ninomegadriver/BlueJamma/CRU/README.md

Custom Resolution Utility  
Copyright (C) 2012-2022 ToastyX  
https://monitortests.com/custom-resolution-utility  
  
Permission is hereby granted, free of charge, to any person obtaining a copy
of this software the rights to use, copy, and/or distribute copies of the
software subject to the following conditions:  
  
The above copyright notice and this permission notice shall be included in
all copies of the software.  
  
THE SOFTWARE IS PROVIDED "AS IS" WITHOUT WARRANTY OF ANY KIND, EXPRESS OR
IMPLIED. IN NO EVENT SHALL THE AUTHOR BE LIABLE FOR ANY CLAIM, DAMAGES, OR
OTHER LIABILITY IN CONNECTION WITH THE USE OF THE SOFTWARE.
