ninomegadriver/BlueJamma/images/BlueJammaInShell1.jpg

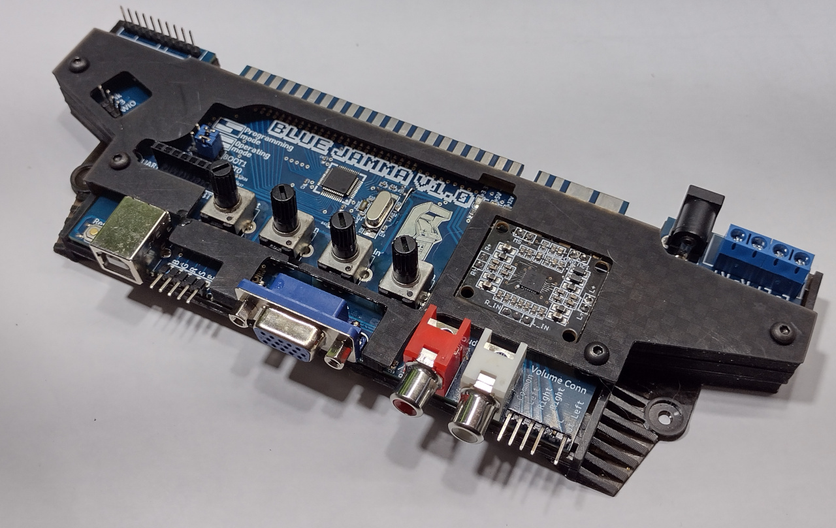
images/BlueJammaInShell1.jpg
