ninomegadriver/BlueJamma/images/BlueJammaInShell2.jpg

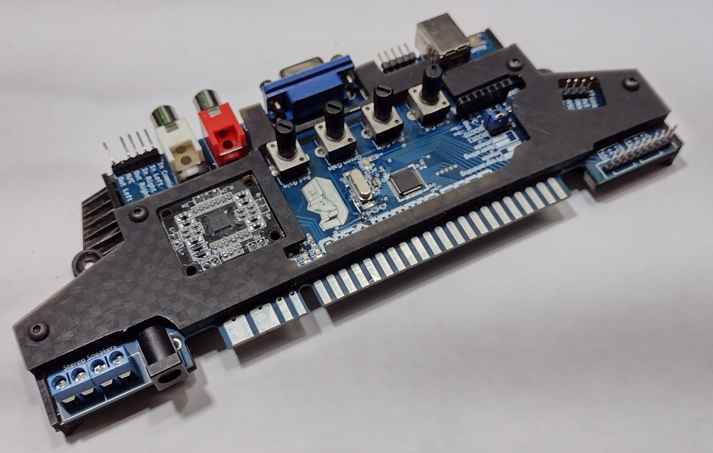
images/BlueJammaInShell2.jpg
