ninomegadriver/BlueJamma/images/BlueJammaInShell3.jpg

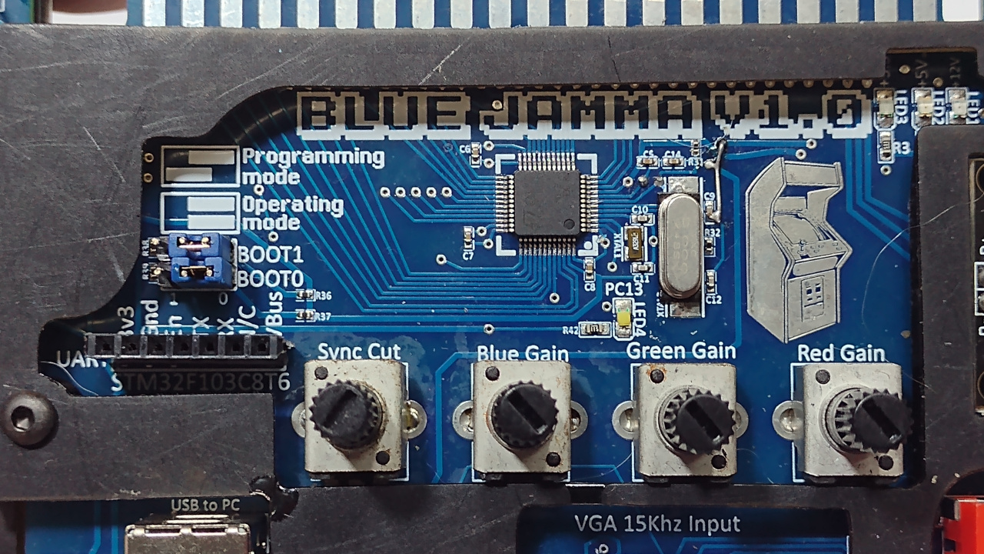
images/BlueJammaInShell3.jpg
