ninomegadriver/BlueJamma/images/pcb-cad-top.jpg

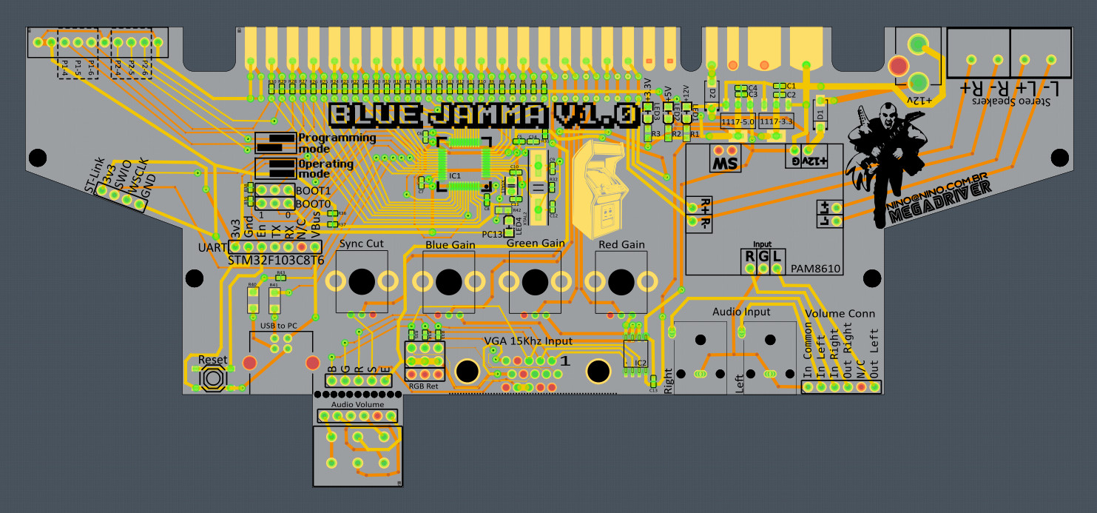
images/pcb-cad-top.jpg
