ninomegadriver/BlueJamma/images/pcb-top.jpg

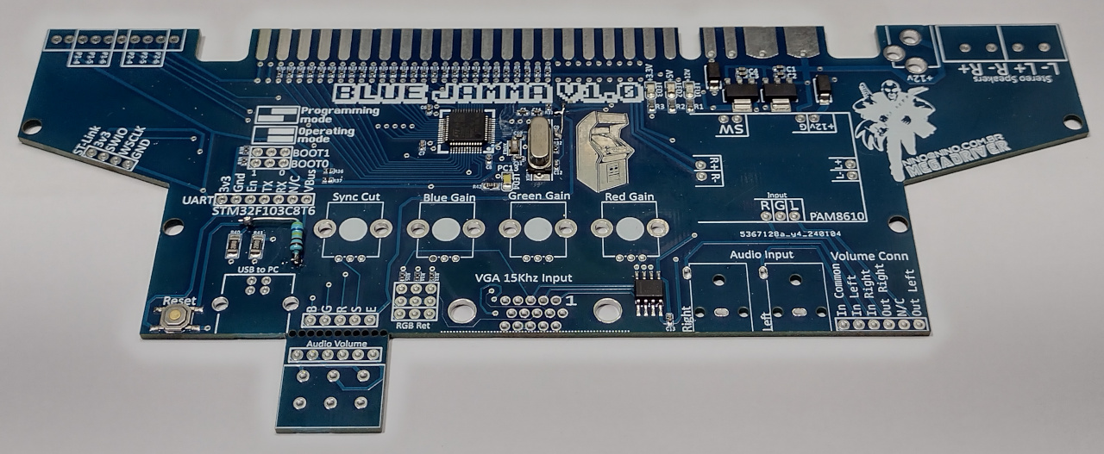
images/pcb-top.jpg
