ninomegadriver/BlueJamma/images/pcbs.jpg

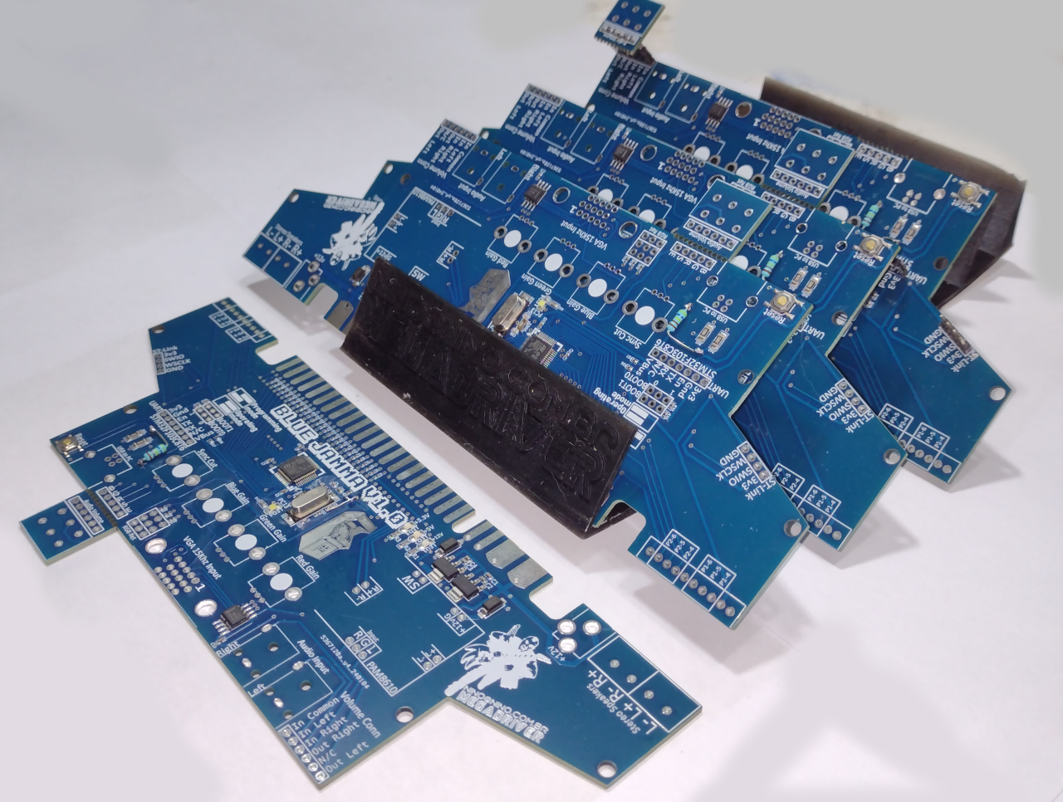
images/pcbs.jpg
