ninomegadriver/BlueJamma/images/schematic-audio.jpg

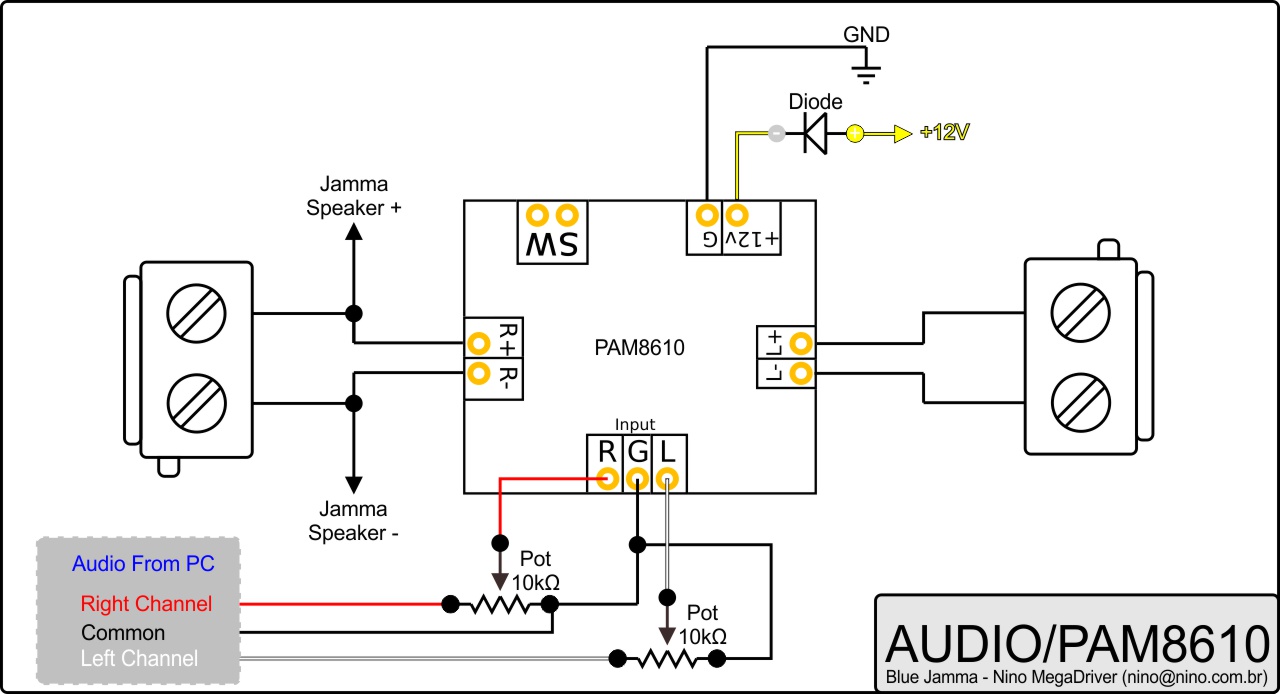
images/schematic-audio.jpg
