ninomegadriver/BlueJamma/images/schematic-flash.jpg

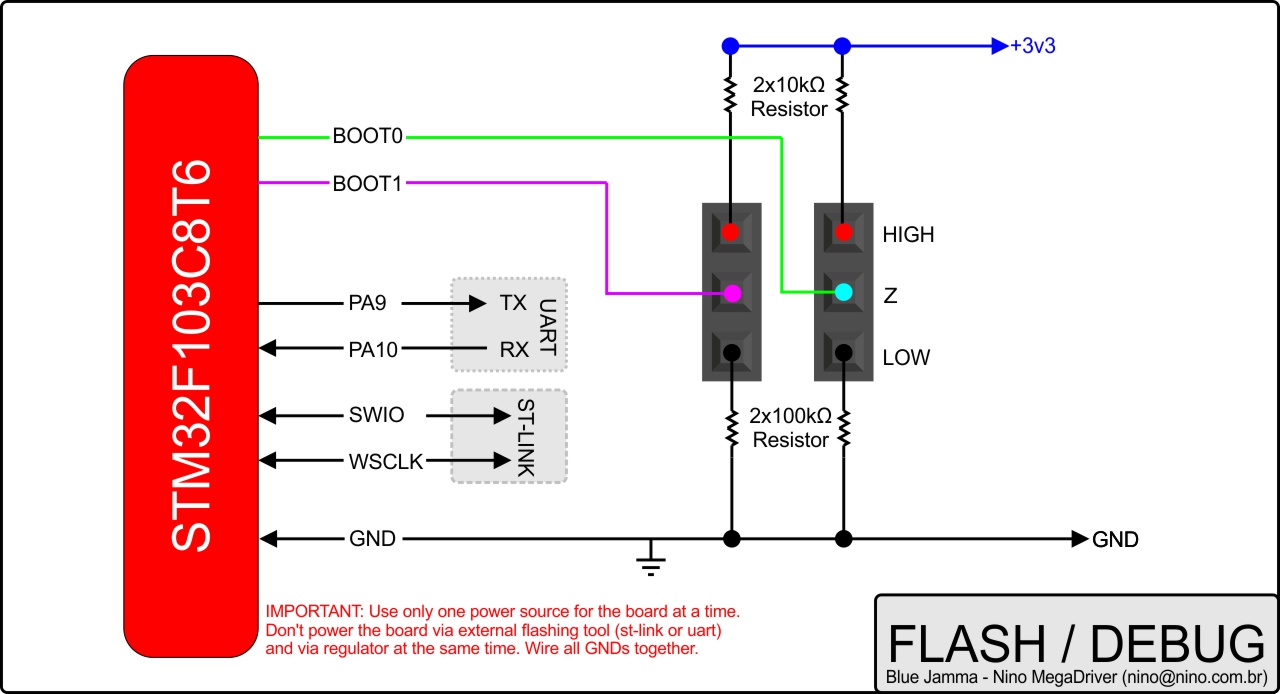
images/schematic-flash.jpg
