ninomegadriver/BlueJamma/images/schematic-oscillator.jpg

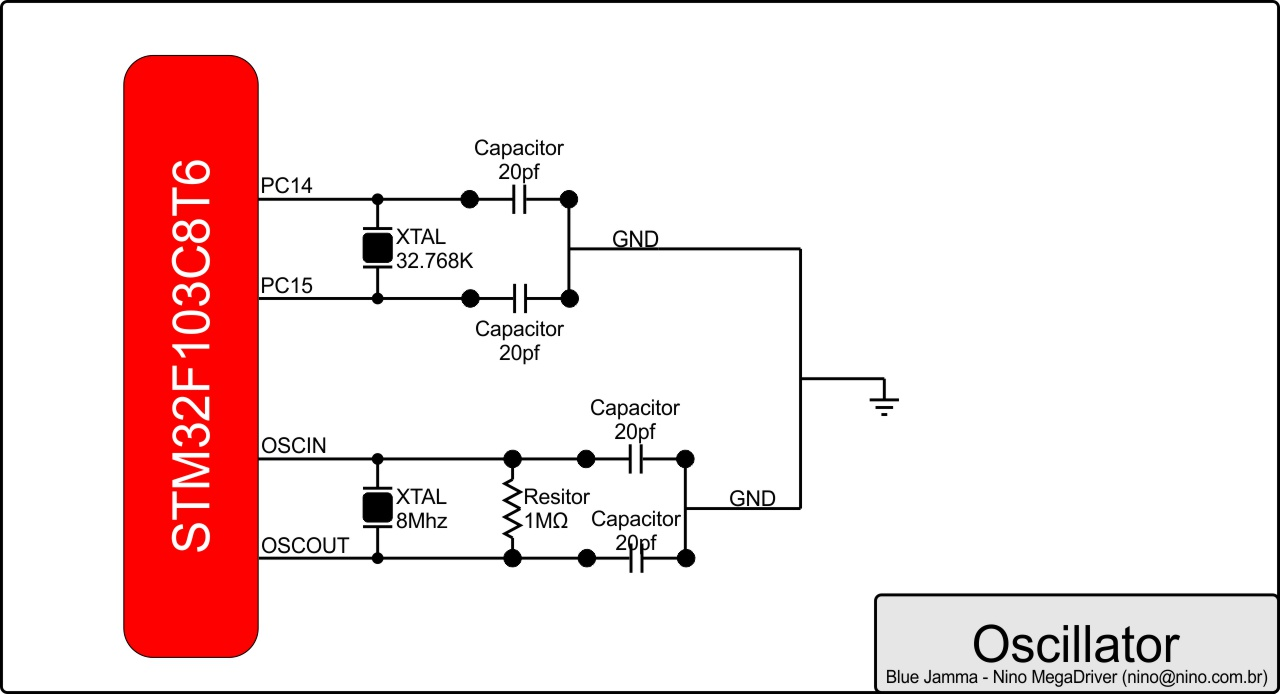
images/schematic-oscillator.jpg
