ninomegadriver/BlueJamma/images/schematic-power.jpg

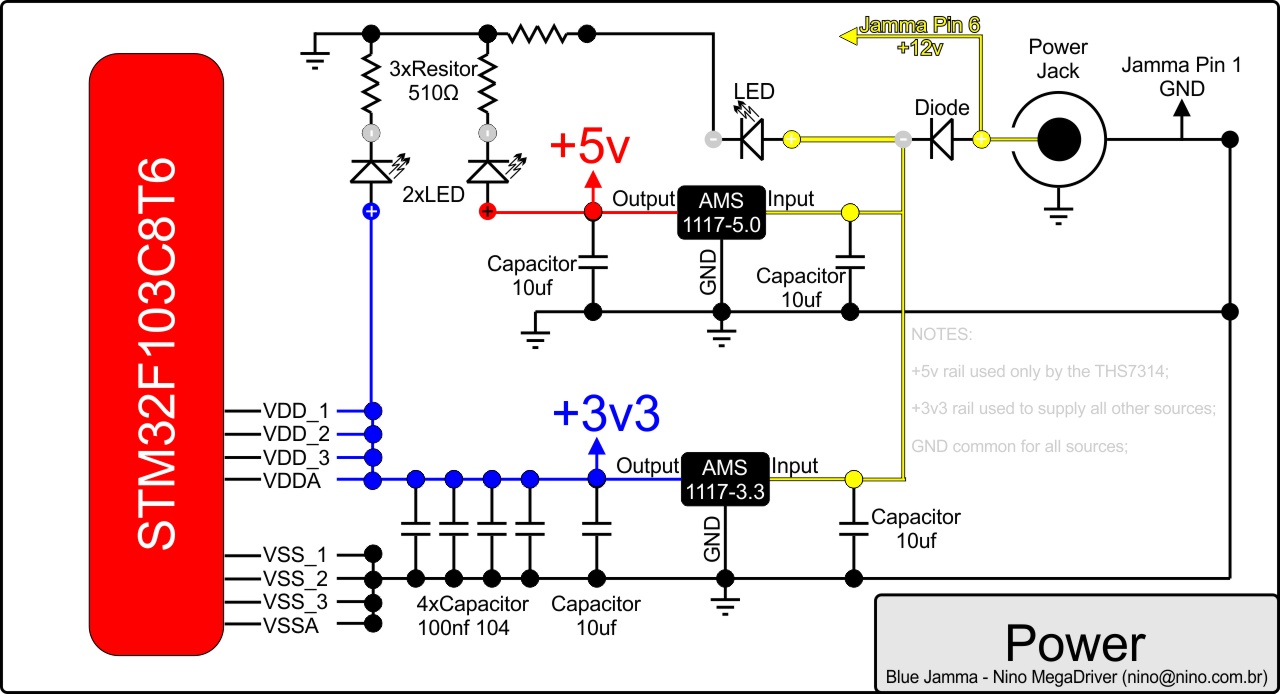
images/schematic-power.jpg
