ninomegadriver/BlueJamma/images/schematic-usb.jpg

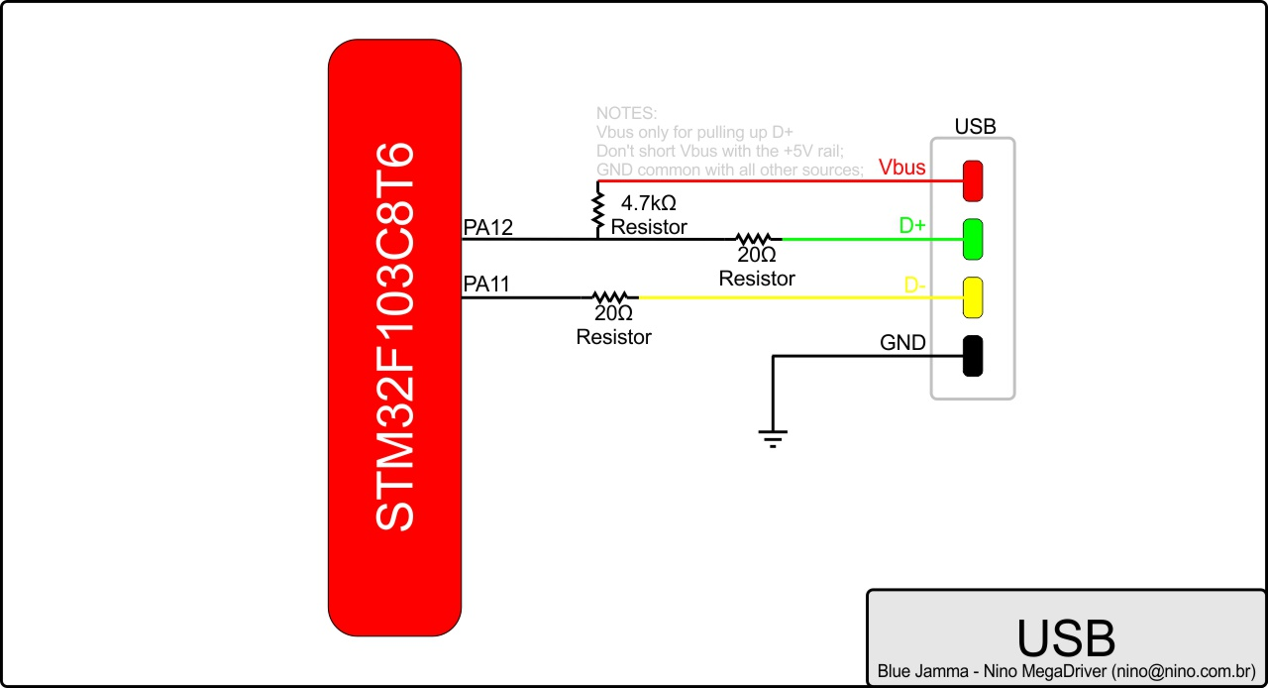
images/schematic-usb.jpg
