ninomegadriver/BlueJamma/images/schematic-video.jpg

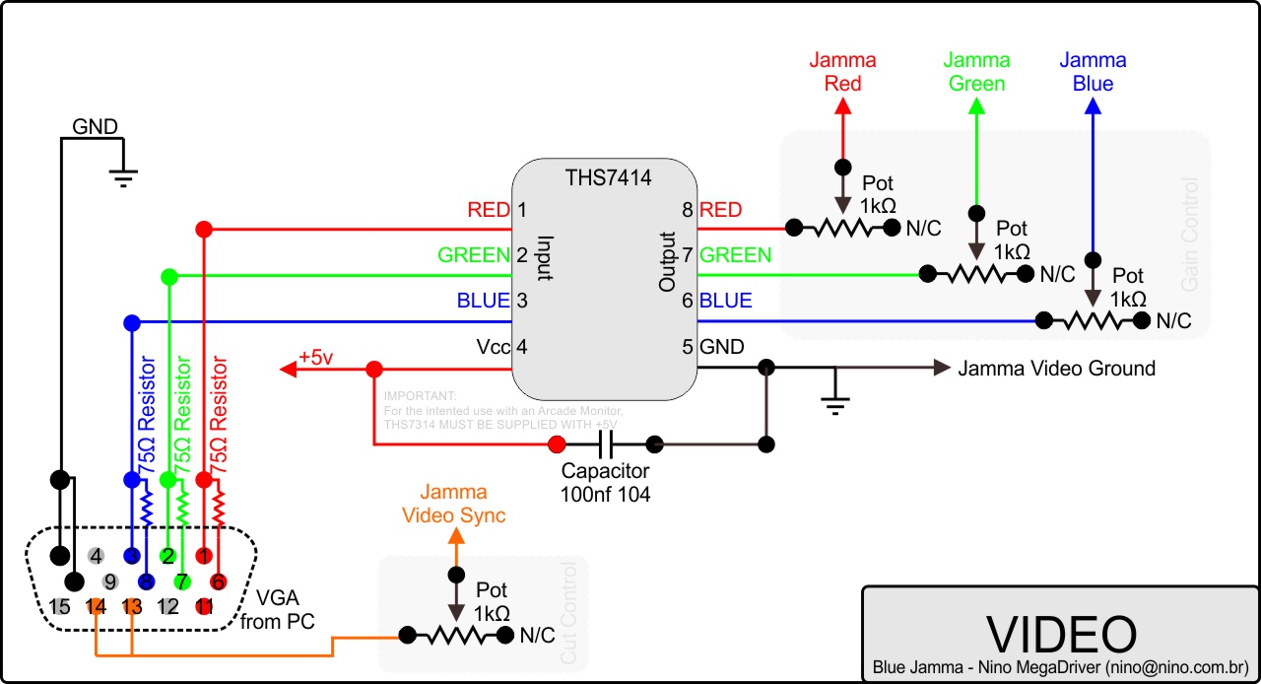
images/schematic-video.jpg
