ninomegadriver/BlueJamma/images/VGA-HowTo-Step00.jpg

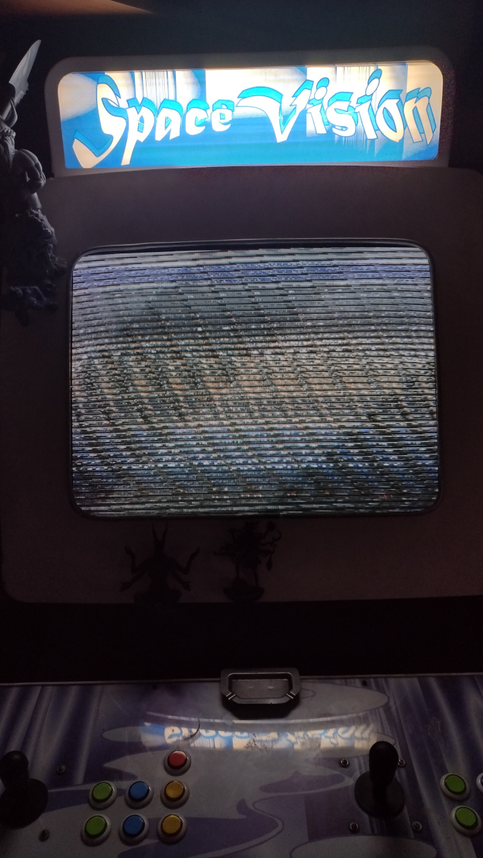
images/VGA-HowTo-Step00.jpg
