ninomegadriver/BlueJamma/images/VGA-HowTo-Step01.jpg

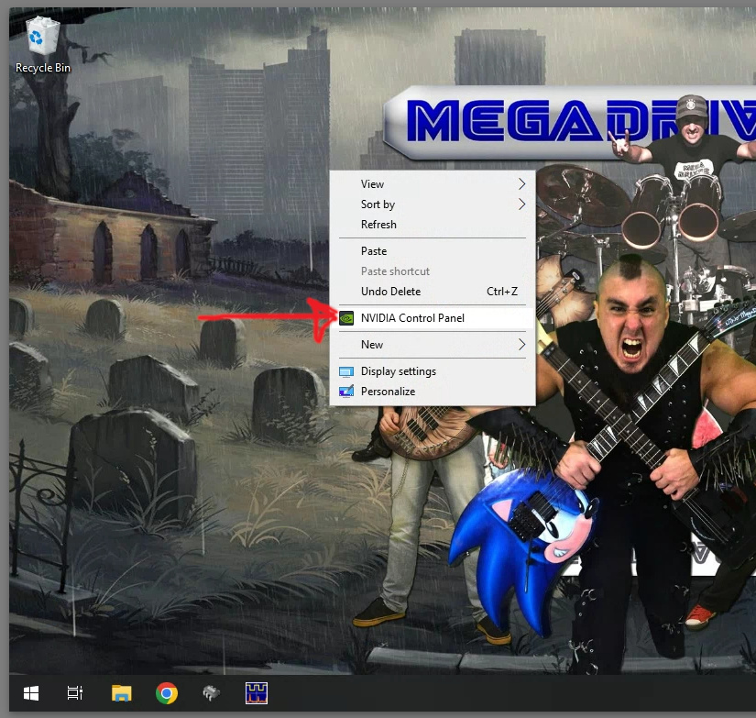
images/VGA-HowTo-Step01.jpg
