ninomegadriver/BlueJamma/images/VGA-HowTo-Step02.jpg

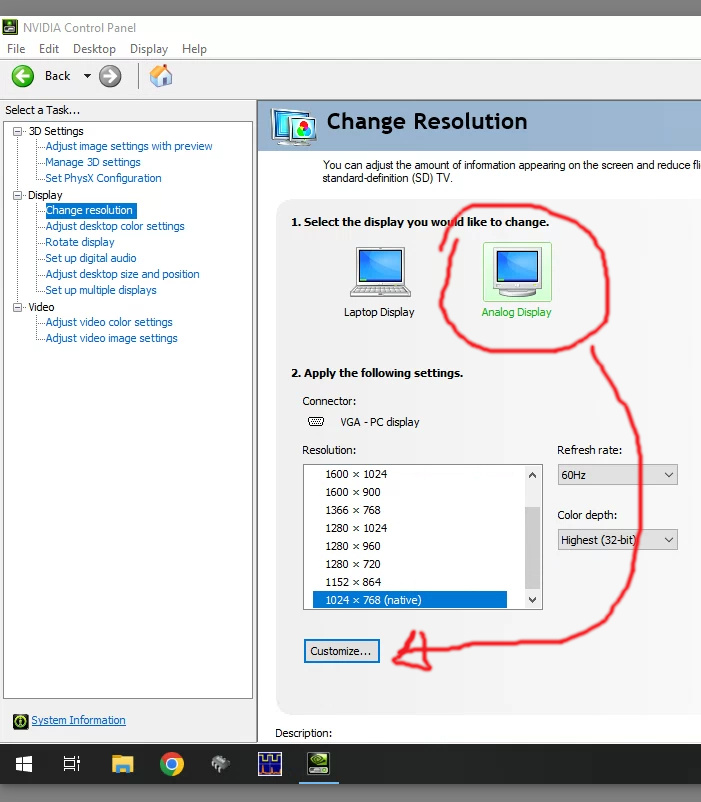
images/VGA-HowTo-Step02.jpg
