ninomegadriver/BlueJamma/images/VGA-HowTo-Step03.jpg

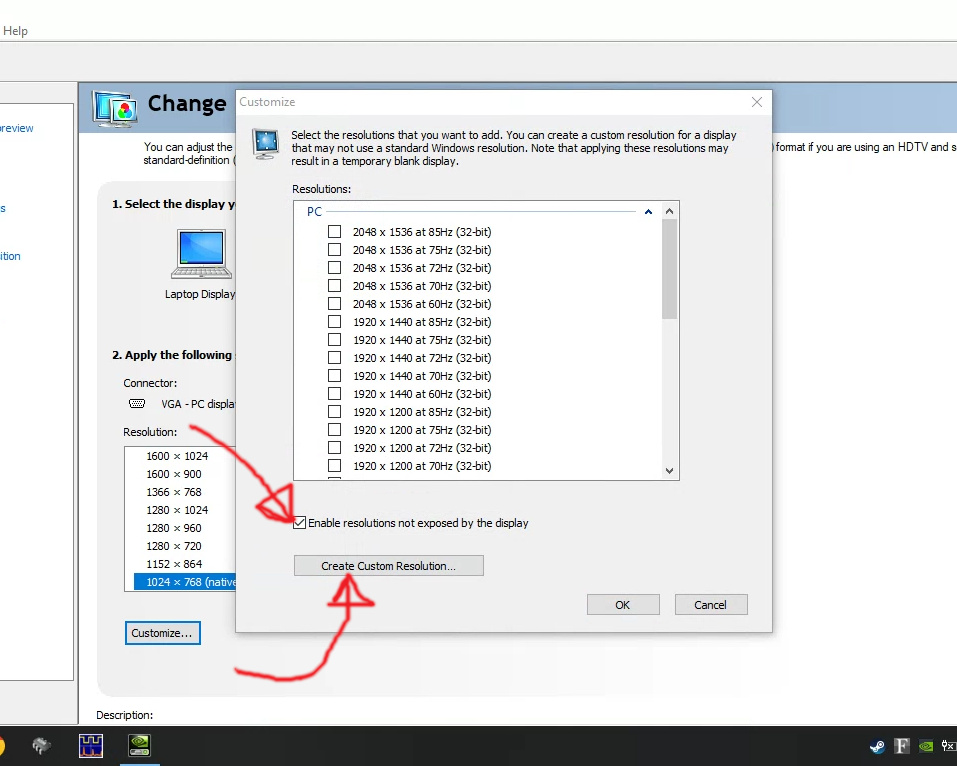
images/VGA-HowTo-Step03.jpg
