ninomegadriver/BlueJamma/images/VGA-HowTo-Step04.jpg

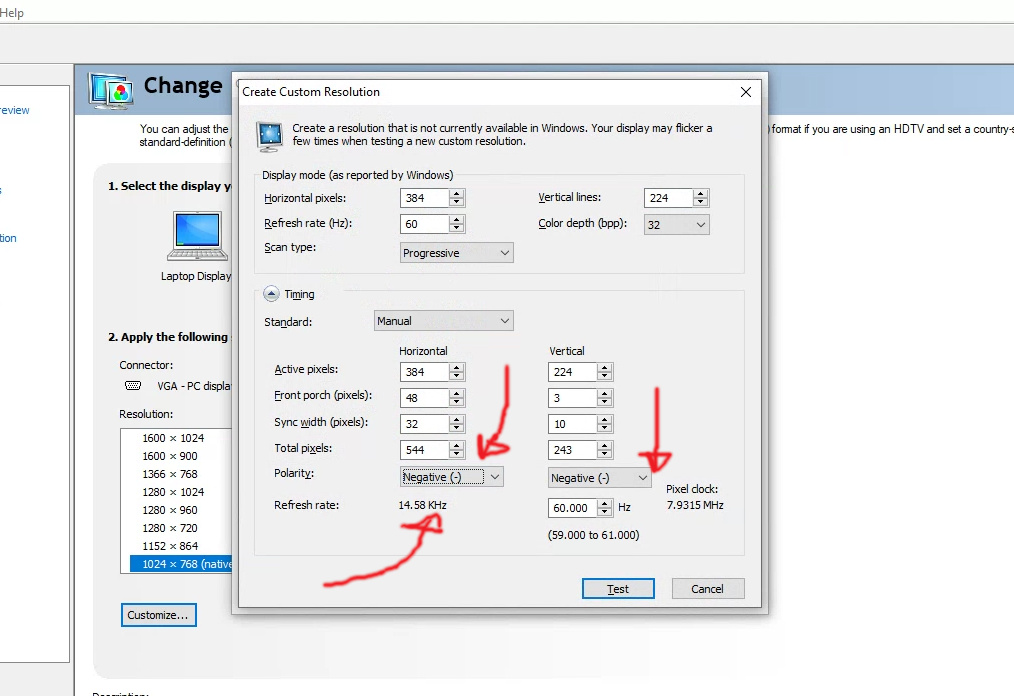
images/VGA-HowTo-Step04.jpg
