ninomegadriver/BlueJamma/images/VGA-HowTo-Step05.jpg

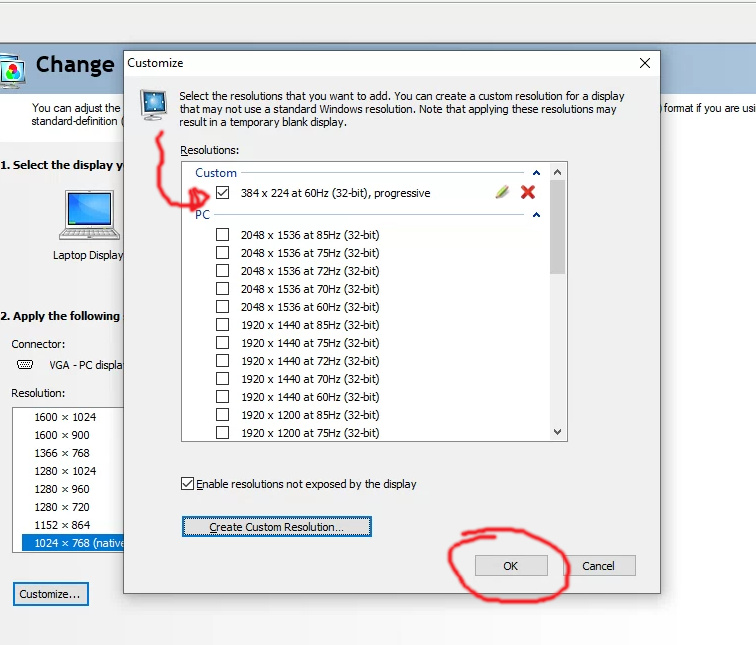
images/VGA-HowTo-Step05.jpg
