ninomegadriver/BlueJamma/images/VGA-HowTo-Step06.jpg

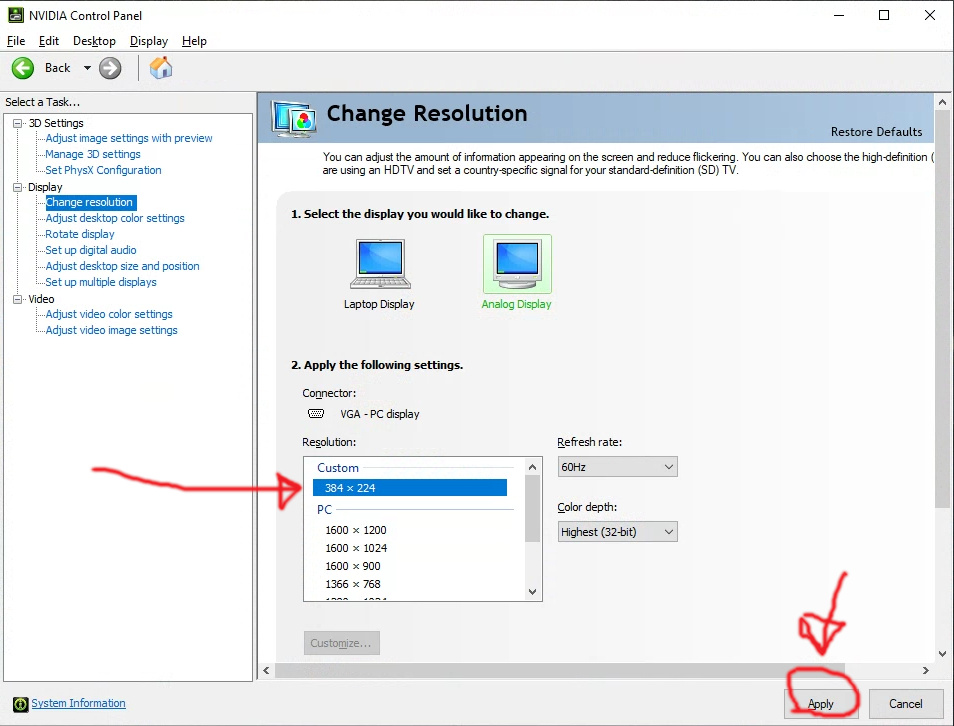
images/VGA-HowTo-Step06.jpg
