ninomegadriver/BlueJamma/images/VGA-HowTo-Step07.jpg

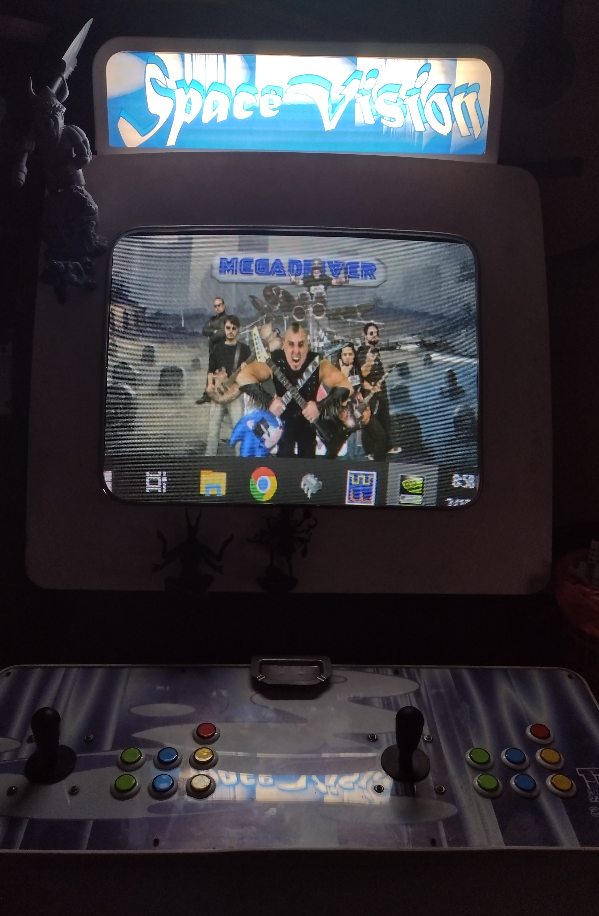
images/VGA-HowTo-Step07.jpg
