ninomegadriver/BlueJamma/images/VGA-HowTo-Step08.jpg

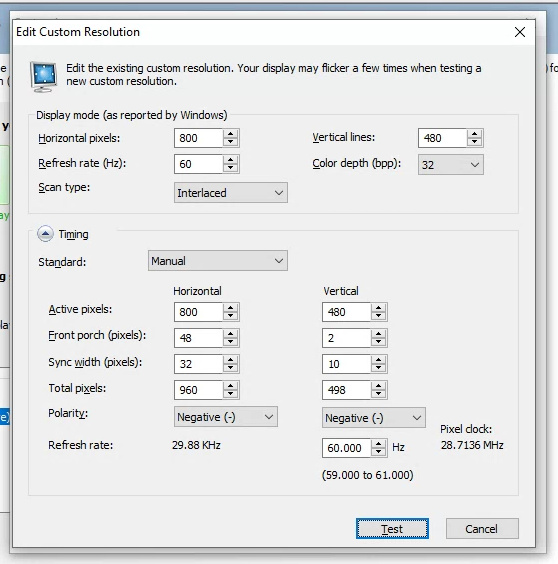
images/VGA-HowTo-Step08.jpg
