ninomegadriver/BlueJamma/CRU/CRU/CRU/DisplayClass.cpp

//---------------------------------------------------------------------------
#include "Common.h"
#pragma hdrstop

#include "DisplayClass.h"
//---------------------------------------------------------------------------
#pragma comment(lib, "setupapi.lib")
//---------------------------------------------------------------------------
unsigned char *DisplayClass::CopyData;
PropertiesClass DisplayClass::CopyProperties;
//---------------------------------------------------------------------------
DisplayClass::DisplayClass()
{
	int Size = MAX_EDID_BLOCKS * 128;

	if (Size < 256)
		Size = 256;

	ActiveData = new unsigned char[Size];
	OverrideData = new unsigned char[Size];
	ResetData = new unsigned char[Size];

	std::memset(ActiveData, 0, Size);
	std::memset(OverrideData, 0, Size);
	std::memset(ResetData, 0, Size);

	DeviceID = new char[TEXTSIZE];
	InstanceID = new char[TEXTSIZE];
	DriverName = new char[TEXTSIZE];

	DeviceID[0] = 0;
	InstanceID[0] = 0;
	DriverName[0] = 0;

	Active = false;
	Override = false;
	Matched = false;
	Deleted = false;
	Restart = false;

	DetailedResolutionList = new DetailedResolutionListClass(4);
	StandardResolutionList = new StandardResolutionListClass(32);
	EstablishedResolutionList = new EstablishedResolutionListClass;
	ExtensionBlockList = new ExtensionBlockListClass(MAX_EDID_EXTENSION_BLOCKS);
}
//---------------------------------------------------------------------------
bool DisplayClass::GetText(char *Text, int TextSize, bool GetStatus)
{
	char OverrideID[TEXTSIZE];
	char OverrideName[TEXTSIZE];
	const char *Name;
	const char *Status;

	OverrideProperties.GetDeviceID(OverrideID, TEXTSIZE);
	OverrideProperties.GetName(OverrideName, TEXTSIZE);

	if (OverrideName[0] != 0)
		Name = OverrideName;
	else if (DriverName[0] != 0)
		Name = DriverName;
	else
		Name = "Unknown Display";

	if (!GetStatus)
		Status = "";
	else if (Deleted)
		Status = " (delete)";
	else if (Active && Restart)
		Status = " (restart required)";
	else if (Active && Override)
		Status = " (active)*";
	else if (Active)
		Status = " (active)";
	else if (Override)
		Status = "*";
	else
		Status = "";

	std::snprintf(Text, TextSize, "%s - %s%s", OverrideID, Name, Status);
	return true;
}
//---------------------------------------------------------------------------
bool DisplayClass::Load(const char *NewDeviceID, const char *NewInstanceID)
{
	if (std::snprintf(DeviceID, TEXTSIZE, "%s", NewDeviceID) >= TEXTSIZE)
		return false;

	if (std::snprintf(InstanceID, TEXTSIZE, "%s", NewInstanceID) >= TEXTSIZE)
		return false;

	if (!LoadDriverName())
		return false;

	Active = LoadActiveStatus();
	Override = LoadOverrideData();

	if (!LoadActiveData())
	{
		if (std::strcmp(DeviceID, "Default_Monitor") == 0)
		{
			if (!Active && !Override)
				return false;
		}
		else
		{
			if (!Override)
				return false;
		}

		if (!LoadDefaultData())
			return false;
	}

	Matched = false;
	Deleted = false;
	Restart = false;
	return true;
}
//---------------------------------------------------------------------------
bool DisplayClass::MatchFullActive(EDIDListClass &EDIDList)
{
	if (Active && !Matched)
		Matched = EDIDList.MatchFullActive(ActiveData);

	return true;
}
//---------------------------------------------------------------------------
bool DisplayClass::MatchFullOverride(EDIDListClass &EDIDList)
{
	if (Active && Override && !Matched)
		Matched = EDIDList.MatchFullOverride(ActiveData, OverrideData);

	return true;
}
//---------------------------------------------------------------------------
bool DisplayClass::MatchPartialOverride(EDIDListClass &EDIDList)
{
	if (Active && Override && !Matched)
		Matched = EDIDList.MatchPartialOverride(ActiveData, OverrideData);

	return true;
}
//---------------------------------------------------------------------------
bool DisplayClass::MatchFirstActive(EDIDListClass &EDIDList)
{
	if (Active && !Matched)
		Matched = EDIDList.MatchFirstActive(ActiveData);

	return true;
}
//---------------------------------------------------------------------------
bool DisplayClass::Init()
{
	int Block;

	if (Override)
	{
		if (std::memcmp(ActiveData, OverrideData, 128) != 0)
			Restart = true;

		for (Block = 1; Block < MAX_EDID_BLOCKS; Block++)
			if (ActiveData[Block * 128] != 0 && OverrideData[Block * 128] != 0)
				if (std::memcmp(&ActiveData[Block * 128], &OverrideData[Block * 128], 128) != 0)
					Restart = true;
	}
	else
	{
		std::memcpy(OverrideData, ActiveData, MAX_EDID_BLOCKS * 128);
		OverrideProperties = ActiveProperties;
	}

	FixData(OverrideData, Override);
	DisplayInit();
	DisplayWrite();
	OverrideProperties.FixIncludes(DetailedResolutions()->GetSlotsLeft());
	OverrideProperties.Write(OverrideData);
	CalculateChecksums();
	std::memcpy(ResetData, OverrideData, MAX_EDID_BLOCKS * 128);
	ResetProperties = OverrideProperties;
	return true;
}
//---------------------------------------------------------------------------
bool DisplayClass::LoadDriverName()
{
	HKEY Key;
	char Path[TEXTSIZE];
	unsigned char Buffer[256];
	unsigned long BufferSize;
	int Index;
	const unsigned char *Text;

	if (std::snprintf(Path, TEXTSIZE, "SYSTEM\\CurrentControlSet\\Enum\\DISPLAY\\%s\\%s", DeviceID, InstanceID) >= TEXTSIZE)
		return false;

	if (RegOpenKeyEx(HKEY_LOCAL_MACHINE, Path, 0, KEY_QUERY_VALUE, &Key) != ERROR_SUCCESS)
		return false;

	BufferSize = sizeof Buffer - sizeof *Buffer;

	if (RegQueryValueEx(Key, "DeviceDesc", NULL, NULL, Buffer, &BufferSize) != ERROR_SUCCESS)
	{
		RegCloseKey(Key);
		return false;
	}

	RegCloseKey(Key);
	Buffer[BufferSize] = 0;

	for (Text = Buffer; *Text; Text++)
	{
		if (*Text == ';')
		{
			Text++;
			break;
		}
	}

	// Generic Non-PnP Monitor
	// ThinkPad Display 1920x1080
	// Wide viewing angle & High density FlexView Display
	for (Index = 0; Index < 29 && Text[Index] != 0; Index++)
		DriverName[Index] = Text[Index];

	if (Index == 29)
	{
		DriverName[26] = '.';
		DriverName[27] = '.';
		DriverName[28] = '.';
	}

	DriverName[Index] = 0;
	return true;
}
//---------------------------------------------------------------------------
bool DisplayClass::LoadActiveStatus()
{
	const GUID GUID_DEVINTERFACE_MONITOR = {0xE6F07B5F, 0xEE97, 0x4A90, {0xB0, 0x76, 0x33, 0xF5, 0x7B, 0xF4, 0xEA, 0xA7}};
	char Path[TEXTSIZE];
	HDEVINFO Devices;
	SP_DEVINFO_DATA Device;
	bool Status = false;

	if (std::snprintf(Path, TEXTSIZE, "DISPLAY\\%s\\%s", DeviceID, InstanceID) >= TEXTSIZE)
		return false;

	Devices = SetupDiGetClassDevs(&GUID_DEVINTERFACE_MONITOR, Path, NULL, DIGCF_DEVICEINTERFACE | DIGCF_PRESENT);

	if (Devices == INVALID_HANDLE_VALUE)
		return false;

	Device.cbSize = sizeof Device;

	if (SetupDiEnumDeviceInfo(Devices, 0, &Device))
		Status = true;

	SetupDiDestroyDeviceInfoList(Devices);
	return Status;
}
//---------------------------------------------------------------------------
bool DisplayClass::LoadOverrideData()
{
	HKEY Key;
	char Path[TEXTSIZE];
	unsigned char Buffer[256];
	unsigned long BufferSize;
	int Block;
	bool Status = false;

	std::memset(OverrideData, 0, MAX_EDID_BLOCKS * 128);

	if (std::snprintf(Path, TEXTSIZE, "SYSTEM\\CurrentControlSet\\Enum\\DISPLAY\\%s\\%s\\Device Parameters\\EDID_OVERRIDE", DeviceID, InstanceID) >= TEXTSIZE)
		return false;

	if (RegOpenKeyEx(HKEY_LOCAL_MACHINE, Path, 0, KEY_QUERY_VALUE, &Key) != ERROR_SUCCESS)
		return false;

	BufferSize = sizeof Buffer;

	if (RegQueryValueEx(Key, "0", NULL, NULL, Buffer, &BufferSize) == ERROR_SUCCESS && BufferSize >= 128 && IsValidData(Buffer))
	{
		std::memcpy(OverrideData, Buffer, 128);
		OverrideProperties.LoadBackupData(Key);
		OverrideProperties.SetResetID(DeviceID);
		OverrideProperties.Read(OverrideData, true);
		Status = true;

		for (Block = 1; Block < MAX_EDID_BLOCKS; Block++)
		{
			std::snprintf(Path, TEXTSIZE, "%d", Block);
			BufferSize = sizeof Buffer;

			if (RegQueryValueEx(Key, Path, NULL, NULL, Buffer, &BufferSize) == ERROR_SUCCESS && BufferSize >= 128)
				std::memcpy(&OverrideData[Block * 128], Buffer, 128);
		}
	}

	RegCloseKey(Key);
	return Status;
}
//---------------------------------------------------------------------------
bool DisplayClass::LoadActiveData()
{
	HKEY Key;
	char Path[TEXTSIZE];
	unsigned char Buffer[32768];
	unsigned long BufferSize;
	bool Status = false;

	std::memset(ActiveData, 0, MAX_EDID_BLOCKS * 128);

	if (std::snprintf(Path, TEXTSIZE, "SYSTEM\\CurrentControlSet\\Enum\\DISPLAY\\%s\\%s\\Device Parameters", DeviceID, InstanceID) >= TEXTSIZE)
		return false;

	if (RegOpenKeyEx(HKEY_LOCAL_MACHINE, Path, 0, KEY_QUERY_VALUE, &Key) != ERROR_SUCCESS)
		return false;

	BufferSize = sizeof Buffer;

	if (RegQueryValueEx(Key, "EDID", NULL, NULL, Buffer, &BufferSize) == ERROR_SUCCESS && BufferSize >= 128 && IsValidData(Buffer))
	{
		if (BufferSize > MAX_EDID_BLOCKS * 128)
			BufferSize = MAX_EDID_BLOCKS * 128;

		std::memcpy(ActiveData, Buffer, BufferSize / 128 * 128);
		ActiveProperties.SetResetID(DeviceID);
		ActiveProperties.Read(ActiveData, false);
		Status = true;
	}

	RegCloseKey(Key);
	return Status;
}
//---------------------------------------------------------------------------
bool DisplayClass::LoadDefaultData()
{
	HKEY Key;
	char Path[TEXTSIZE];

	std::memset(ActiveData, 0, MAX_EDID_BLOCKS * 128);

	if (std::snprintf(Path, TEXTSIZE, "SYSTEM\\CurrentControlSet\\Enum\\DISPLAY\\%s\\%s\\Device Parameters", DeviceID, InstanceID) >= TEXTSIZE)
		return false;

	if (RegOpenKeyEx(HKEY_LOCAL_MACHINE, Path, 0, KEY_QUERY_VALUE, &Key) != ERROR_SUCCESS)
		return false;

	RegCloseKey(Key);
	std::memcpy(ActiveData, "\x00\xFF\xFF\xFF\xFF\xFF\xFF\x00\x41\xD0\xFF\x09\x00\x00\x00\x00\x00\x00\x01\x03\x08\x00\x00\x78\xEA\xEE\x95\xA3\x54\x4C\x99\x26\x0F\x50\x54", 35);
	ActiveProperties.SetResetID(DeviceID);
	ActiveProperties.Read(ActiveData, false);
	return true;
}
//---------------------------------------------------------------------------
bool DisplayClass::GetDeviceID(char *Text, int TextSize)
{
	if (std::snprintf(Text, TextSize, "%s", DeviceID) >= TextSize)
		return false;

	return true;
}
//---------------------------------------------------------------------------
bool DisplayClass::GetInstanceID(char *Text, int TextSize)
{
	if (std::snprintf(Text, TextSize, "%s", InstanceID) >= TextSize)
		return false;

	return true;
}
//---------------------------------------------------------------------------
bool DisplayClass::GetDriverName(char *Text, int TextSize)
{
	if (std::snprintf(Text, TextSize, "%s", DriverName) >= TextSize)
		return false;

	return true;
}
//---------------------------------------------------------------------------
bool DisplayClass::GetActiveStatus()
{
	return Active;
}
//---------------------------------------------------------------------------
bool DisplayClass::GetOverrideStatus()
{
	return Override;
}
//---------------------------------------------------------------------------
bool DisplayClass::IsValidData(const unsigned char *Data)
{
	if (std::memcmp(Data, "\x00\xFF\xFF\xFF\xFF\xFF\xFF\x00", 8) != 0)
		return false;

	return true;
}
//---------------------------------------------------------------------------
bool DisplayClass::FixData(unsigned char *Data, bool Override)
{
	unsigned char CompareData[127];

	if (!IsValidData(Data))
		return false;

	std::memset(&Data[12], 0, 4);

	if (Data[18] != 1 || Data[19] != 4)
	{
		Data[18] = 1;
		Data[19] = 3;

		if (Data[20] & 128)
			Data[20] = 128;
	}

	Data[24] |= 2;

	if (Override)
	{
		if (Data[126] == 1)
		{
			std::memset(CompareData, 0, 127);
			CompareData[0] = 0x02;
			CompareData[1] = 0x03;

			if (std::memcmp(&Data[128], CompareData, 127) == 0)
				Data[126] = 0;
		}
	}
	else
	{
		if (Data[126] == 1)
		{
			std::memset(CompareData, 0xFF, 127);

			if (std::memcmp(&Data[128], CompareData, 127) == 0)
				Data[126] = 0;
		}
	}

	return true;
}
//---------------------------------------------------------------------------
bool DisplayClass::Import(const char *FileName, bool Complete)
{
	std::FILE *File = std::fopen(FileName, "rb");

	if (!File)
		return false;

	DisplayWrite();
	OverrideData[126] = 0;

	if (!ImportFile(File, Complete, "(b)"))
	if (!ImportFile(File, Complete, "(hhhhhhhhhhhhhhhh)"))
	if (!ImportFile(File, Complete, "l(hhhhhhhhhhhhhhhh)"))
	if (!ImportFile(File, Complete, "(xcxcxcxcxcxcxcxcxcxcxcxcxcxcxcxc)"))
	if (!ImportFile(File, Complete, "l(xcxcxcxcxcxcxcxcxcxcxcxcxcxcxcxc)"))
	if (!ImportFile(File, Complete, "lll(oshhhhhhhhhhhhhhhh)"))
	if (!ImportFile(File, Complete, "lll(sshhhhhhhhhh)"))
	if (!ImportINF(File, Complete))
	if (!ImportEXE(File, Complete))
	{
		std::fclose(File);
		return false;
	}

	std::fclose(File);
	FixData(OverrideData, true);
	DisplayRead();
	return true;
}
//---------------------------------------------------------------------------
bool DisplayClass::ImportFile(std::FILE *File, bool Complete, const char *Format)
{
	PropertiesClass Properties;
	unsigned char Buffer[128];
	int Index;
	int Block;
	const char *Byte;
	const char *Start;
	int Hex;
	char Text[256];
	bool Valid = false;
	bool Status = false;

	rewind(File);
	Index = 0;
	Block = 0;

	for (Byte = Format; Block < MAX_EDID_BLOCKS; Byte++)
	{
		switch (*Byte)
		{
			case '(':
				Start = Byte;
				break;

			case ')':
				Byte = Start;
				break;

			case 'b':
				if (std::fread(&Buffer[Index], 1, 128, File) != 128)
					return Status;

				Index += 128;
				break;

			case 'c':
				if (std::fgetc(File) == EOF)
					return Status;

				break;

			case 'h':
				if (std::fscanf(File, "%2x", &Hex) != 1)
					return Status;

				Buffer[Index] = Hex;
				Index++;
				break;

			case 'l':
				if (!std::fgets(Text, 256, File))
					return Status;

				break;

			case 'o':
				if (std::fscanf(File, "%x", &Hex) != 1)
					return Status;

				if (Hex % 128 != Index)
					return Status;

				if (Hex / 128 < Block)
					return Status;

				if (Index == 0)
					Block = Hex / 128;

				break;

			case 's':
				if (std::fscanf(File, "%255s", Text) != 1)
					return Status;

				break;

			case 'x':
				if (std::fscanf(File, "%x", &Hex) != 1)
					return Status;

				if (Hex > 255)
					return Status;

				Buffer[Index] = Hex;
				Index++;
				break;

			default:
				return Status;
		}

		if (Index != 128)
			continue;

		if (Block == 0)
		{
			if (!IsValidData(Buffer))
				return Status;

			Valid = true;

			if (Complete)
				std::memcpy(OverrideData, Buffer, 128);
			else
				std::memcpy(&OverrideData[35], &Buffer[35], 93);

			if (!Status)
				std::memset(&OverrideData[128], 0, MAX_EDID_EXTENSION_BLOCKS * 128);

			Properties = OverrideProperties;
			Properties.Read(Buffer, true);
			Properties.ResetIncludes();

			if (Complete)
				OverrideProperties = Properties;
			else
				OverrideProperties.Import(Properties);

			Status = true;
		}
		else
		{
			if (!Valid && OverrideData[126] < Block)
				OverrideData[126] = Block;

			if (!Status)
				std::memset(&OverrideData[128], 0, MAX_EDID_EXTENSION_BLOCKS * 128);

			std::memcpy(&OverrideData[Block * 128], Buffer, 128);
			Status = true;
		}

		Index = 0;
		Block++;
	}

	return Status;
}
//---------------------------------------------------------------------------
bool DisplayClass::ImportINF(std::FILE *File, bool Complete)
{
	PropertiesClass Properties;
	unsigned char Buffer[128];
	char Line[1024];
	const char *Text;
	int Block;
	int Hex;
	int Index;
	bool Valid = false;
	bool Status = false;

	rewind(File);

	while (std::fgets(Line, 1024, File))
	{
		if (std::strchr(Line, '\x7F'))
			return Status;

		Text = std::strtok(Line, ", \"\r\n");

		if (!Text)
			continue;

		if (stricmp(Text, "HKR") != 0)
			continue;

		Text = std::strtok(NULL, ", \"\r\n");

		if (!Text)
			continue;

		if (stricmp(Text, "EDID_OVERRIDE") != 0)
			continue;

		Text = std::strtok(NULL, ", \"\r\n");

		if (!Text)
			continue;

		if (std::sscanf(Text, "%d", &Block) != 1)
			continue;

		if (Block < 0 || Block >= MAX_EDID_BLOCKS)
			continue;

		Text = std::strtok(NULL, ", \"\r\n");

		if (!Text)
			continue;

		if (std::sscanf(Text, "%x", &Hex) != 1)
			continue;

		if (Hex != 1)
			continue;

		for (Index = 0; Index < 128; Index++)
		{
			Text = std::strtok(NULL, ", \"\r\n");

			if (!Text)
				break;

			if (std::sscanf(Text, "%x", &Hex) != 1)
				break;

			if (Hex > 255)
				break;

			Buffer[Index] = Hex;
		}

		if (Index != 128)
			return Status;

		Text = std::strtok(NULL, ", \"\r\n");

		if (Text)
			return Status;

		if (Block == 0)
		{
			if (!IsValidData(Buffer))
				return Status;

			Valid = true;

			if (Complete)
				std::memcpy(OverrideData, Buffer, 128);
			else
				std::memcpy(&OverrideData[35], &Buffer[35], 93);

			if (!Status)
				std::memset(&OverrideData[128], 0, MAX_EDID_EXTENSION_BLOCKS * 128);

			Properties = OverrideProperties;
			Properties.Read(Buffer, true);
			Properties.ResetIncludes();

			if (Complete)
				OverrideProperties = Properties;
			else
				OverrideProperties.Import(Properties);

			Status = true;
		}
		else
		{
			if (!Valid && OverrideData[126] < Block)
				OverrideData[126] = Block;

			if (!Status)
				std::memset(&OverrideData[128], 0, MAX_EDID_EXTENSION_BLOCKS * 128);

			std::memcpy(&OverrideData[Block * 128], Buffer, 128);
			Status = true;
		}
	}

	return Status;
}
//---------------------------------------------------------------------------
bool DisplayClass::ImportEXE(std::FILE *File, bool Complete)
{
	PropertiesClass Properties;
	const unsigned char Magic[] = {0x71, 0x42, 0x12, 0x83, 0x54, 0x24, 0x95, 0x66};
	const int DataSize = sizeof Magic + MAX_EDID_BLOCKS * 128;
	const int ReadSize = 4096;
	unsigned char Buffer[DataSize + ReadSize];
	int Size;
	int Index;

	rewind(File);
	Size = std::fread(&Buffer[DataSize], 1, ReadSize, File);
	Index = DataSize;

	if (Size < DataSize || memcmp(&Buffer[DataSize], "MZ", 2) != 0)
		return false;

	while (Size > 0)
	{
		while (Index <= Size)
		{
			if (memcmp(&Buffer[Index], Magic, sizeof Magic) == 0)
			{
				Index += sizeof Magic;

				if (!IsValidData(&Buffer[Index]))
					continue;

				if (Complete)
					std::memcpy(OverrideData, &Buffer[Index], DataSize);
				else
					std::memcpy(&OverrideData[35], &Buffer[Index + 35], DataSize - 35);

				Properties = OverrideProperties;
				Properties.Read(&Buffer[Index], true);
				Properties.ResetIncludes();

				if (Complete)
					OverrideProperties = Properties;
				else
					OverrideProperties.Import(Properties);

				return true;
			}

			Index++;
		}

		std::memcpy(Buffer, &Buffer[ReadSize], DataSize);
		Size = std::fread(&Buffer[DataSize], 1, ReadSize, File);
		Index = 1;
	}

	return false;
}
//---------------------------------------------------------------------------
const char *DisplayClass::GetImportFormats()
{
	return "EDID Files (*.bin, *.dat, *.inf)\0*.bin;*.dat;*.inf\0TXT Files (*.txt)\0*.txt\0CSV Files (*.csv)\0*.csv\0EXE Files (*.exe)\0*.exe\0All Files (*.*)\0*.*\0\0";
}
//---------------------------------------------------------------------------
const char *DisplayClass::GetExportFormats()
{
	return "BIN File (*.bin)\0*.bin\0DAT File (*.dat)\0*.dat\0INF File (*.inf)\0*.inf\0TXT File (*.txt)\0*.txt\0CSV File (*.csv)\0*.csv\0EXE File (*.exe)\0*.exe\0\0";
}
//---------------------------------------------------------------------------
bool DisplayClass::Export(const char *FileName, int FileType, const char *Name)
{
	std::FILE *File = std::fopen(FileName, "wb");

	if (!File)
		return false;

	if (!ExportFile(File, FileType, Name))
	{
		std::fclose(File);
		return false;
	}

	if (std::fclose(File) != 0)
		return false;

	return true;
}
//---------------------------------------------------------------------------
bool DisplayClass::ExportFile(std::FILE *File, int FileType, const char *Name)
{
	unsigned char *ExportData;
	unsigned Count;
	unsigned Line;
	unsigned Index;
	char OverrideID[TEXTSIZE];

	DisplayWrite();
	OverrideProperties.Write(OverrideData);
	CalculateChecksums();

	if (!Override && std::memcmp(OverrideData, ResetData, MAX_EDID_BLOCKS * 128) == 0 && OverrideProperties == ResetProperties)
		ExportData = ActiveData;
	else
		ExportData = OverrideData;

	for (Count = MAX_EDID_EXTENSION_BLOCKS; Count > 0; Count--)
		if (ExportData[Count * 128] != 0)
			break;

	Count++;

	switch (FileType)
	{
		case 1:
			Count *= 128;

			if (std::fwrite(ExportData, 1, Count, File) != Count)
				return false;

			return true;

		case 2:
			Count *= 8;

			if (std::fprintf(File, "EDID BYTES:\r\n") <= 0)
				return false;

			if (std::fprintf(File, "0x %*s 00 01 02 03 04 05 06 07 08 09 0A 0B 0C 0D 0E 0F\r\n", Count <= 16 ? 1 : 3, "") <= 0)
				return false;

			if (std::fprintf(File, "%*s   ------------------------------------------------\r\n", Count <= 16 ? 1 : 3, "") <= 0)
				return false;

			for (Line = 0; Line < Count; Line++)
			{
				if (std::fprintf(File, "%0*X0 |", Count <= 16 ? 1 : 3, Line) <= 0)
					return false;

				for (Index = 0; Index < 16; Index++)
					if (std::fprintf(File, " %02X", *(ExportData++)) <= 0)
						return false;

				if (std::fprintf(File, "\r\n") <= 0)
					return false;
			}

			return true;

		case 3:
			if (ExportData == OverrideData && ExportData[126] == 0 && OverrideProperties.GetExtensions())
			{
				Count++;
				ExportData[126]++;
				ExportData[127]--;
				ExtensionBlockList->WriteBlankExtension(&ExportData[128], 128);
			}

			if (std::fprintf(File,
				"[Version]\r\n"
				"Signature=\"$Windows NT$\"\r\n"
				"Class=Monitor\r\n"
				"ClassGUID={4d36e96e-e325-11ce-bfc1-08002be10318}\r\n"
				"Provider=%%MFR%%\r\n"
				"\r\n"
				"[Manufacturer]\r\n"
				"%%MFR%%=Monitor,NTx86,NTamd64\r\n"
				) <= 0)
				return false;

			OverrideProperties.GetDeviceID(OverrideID, TEXTSIZE);

			if (std::fprintf(File,
				"\r\n"
				"[Monitor.NTx86]\r\n"
				"%%MODEL%%=Monitor.Install,MONITOR\\%s\r\n", OverrideID
				) <= 0)
				return false;

			if (std::fprintf(File,
				"\r\n"
				"[Monitor.NTamd64]\r\n"
				"%%MODEL%%=Monitor.Install,MONITOR\\%s\r\n", OverrideID
				) <= 0)
				return false;

			if (std::fprintf(File,
				"\r\n"
				"[Monitor.Install]\r\n"
				"DelReg=Monitor.DelReg\r\n"
				"\r\n"
				"[Monitor.Install.HW]\r\n"
				"DelReg=Monitor.DelReg\r\n"
				"AddReg=Monitor.AddReg\r\n"
				"\r\n"
				"[Monitor.DelReg]\r\n"
				"HKR,EDID_OVERRIDE\r\n"
				"HKR,MODES\r\n"
				"HKR,,DPMS\r\n"
				"HKR,,ICMProfile\r\n"
				"HKR,,MaxResolution\r\n"
				"HKR,,PreferredMode\r\n"
				"\r\n"
				"[Monitor.AddReg]\r\n"
				) <= 0)
				return false;

			for (Line = 0; Line < Count; Line++)
			{
				if (Line > 0 && *ExportData == 0)
				{
					ExportData += 128;
					continue;
				}

				if (std::fprintf(File, "HKR,EDID_OVERRIDE,\"%d\",0x01", Line) <= 0)
					return false;

				for (Index = 0; Index < 128; Index++)
					if (std::fprintf(File, ",0x%02X", *(ExportData++)) <= 0)
						return false;

				if (std::fprintf(File, "\r\n") <= 0)
					return false;
			}

			if (std::fprintf(File,
				"\r\n"
				"[Strings]\r\n"
				"MFR=\"EDID Override\"\r\n"
				"MODEL=\"%s\"\r\n", Name
				) <= 0)
				return false;

			return true;

		case 4:
			Count *= 8;

			for (Line = 0; Line < Count; Line++)
			{
				if (std::fprintf(File, "%02X", *(ExportData++)) <= 0)
					return false;

				for (Index = 1; Index < 16; Index++)
					if (std::fprintf(File, " %02X", *(ExportData++)) <= 0)
						return false;

				if (std::fprintf(File, "\r\n") <= 0)
					return false;
			}

			return true;

		case 5:
			for (Line = 0; Line < Count; Line++)
			{
				if (std::fprintf(File, "%02X", *(ExportData++)) <= 0)
					return false;

				for (Index = 1; Index < 128; Index++)
					if (std::fprintf(File, ",%02X", *(ExportData++)) <= 0)
						return false;

				if (std::fprintf(File, "\r\n") <= 0)
					return false;
			}

			return true;

		case 6:
			unsigned char FileData[] =
			{
				0x4D, 0x5A, 0x90, 0x00, 0x03, 0x00, 0x00, 0x00, 0x04, 0x00, 0x00, 0x00, 0xFF, 0xFF, 0x00, 0x00, 0xB8, 0x00, 0x00, 0x00, 0x00, 0x00, 0x00, 0x00, 0x40, 0x00, 0x00, 0x00, 0x00, 0x00, 0x00, 0x00, 0x00, 0x00, 0x00, 0x00, 0x00, 0x00, 0x00, 0x00, 0x00, 0x00, 0x00, 0x00, 0x00, 0x00, 0x00, 0x00, 0x00, 0x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
				0x00, 0x10, 0x00, 0x00, 0x00, 0x82, 0x00, 0x00, 0x00, 0x04, 0x00, 0x00, 0x00, 0x00, 0x00, 0x00, 0x00, 0x00, 0x00, 0x00, 0x00, 0x00, 0x00, 0x00, 0x20, 0x00, 0x00, 0x60, 0x2E, 0x72, 0x64, 0x61, 0x74, 0x61, 0x00, 0x00, 0x5E, 0x2A, 0x00, 0x00, 0x00, 0xA0, 0x00, 0x00, 0x00, 0x2C, 0x00, 0x00, 0x00, 0x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
				0x00, 0x00, 0x00, 0x00, 0x00, 0x00, 0x00, 0x00, 0x00, 0x00, 0x00, 0x00, 0x00, 0x00, 0x00, 0x00, 0x00, 0x00, 0x00, 0x00, 0x00, 0x00, 0x00, 0x00, 0x55, 0x8B, 0xEC, 0x81, 0xEC, 0x08, 0x01, 0x00, 0x00, 0xA1, 0x04, 0xD0, 0x40, 0x00, 0x33, 0xC5, 0x89, 0x45, 0xFC, 0x8B, 0x45, 0x08, 0x50, 0x68, 0xB8, 0xB9, 0x40, 0x00, 0x68, 0x58, 0xBC, 0x40, 0x00, 0x68, 0x80, 0xBC, 0x40, 0x00, 0x8D, 0x85, 0xFC, 0xFE, 0xFF, 0xFF, 0x68, 0x00, 0x01, 0x00, 0x00, 0x50, 0xE8, 0x93, 0x13, 0x00, 0x00, 0x83, 0xC4, 0x18, 0x3D, 0x00, 0x01, 0x00, 0x00, 0x7C, 0x1B, 0xA1, 0x38, 0xEA, 0x40, 0x00, 0x83, 0xC8, 0xFE, 0xA3, 0x38, 0xEA, 0x40, 0x00, 0x8B, 0x4D, 0xFC, 0x33, 0xCD, 0xE8, 0x67, 0x10, 0x00, 0x00, 0x8B, 0xE5, 0x5D, 0xC3, 0x6A, 0x00, 0x8D, 0x8D, 0xF8, 0xFE, 0xFF, 0xFF, 0x51, 0x6A, 0x00, 0x6A, 0x02, 0x6A, 0x00, 0x6A, 0x00, 0x6A, 0x00, 0x8D, 0x95, 0xFC, 0xFE, 0xFF, 0xFF, 0x52, 0x68, 0x02, 0x00, 0x00, 0x80, 0xFF, 0x15, 0x14, 0xA0, 0x40, 0x00, 0x85, 0xC0, 0x75, 0xBC, 0x83, 0x0D, 0x38, 0xEA, 0x40, 0x00, 0x01, 0x53, 0x8B, 0x1D, 0x0C, 0xA0, 0x40, 0x00, 0x56, 0x57, 0x33, 0xFF, 0xBE, 0xD8, 0xB9, 0x40, 0x00, 0x8D, 0x64, 0x24, 0x00, 0x57, 0x68, 0xAC, 0xBC, 0x40, 0x00, 0x8D, 0x85, 0xFC, 0xFE, 0xFF, 0xFF, 0x68, 0x00, 0x01, 0x00, 0x00, 0x50, 0xE8, 0x13, 0x13, 0x00, 0x00, 0x83, 0xC4, 0x10, 0x3D, 0x00, 0x01, 0x00, 0x00, 0x0F, 0x8D, 0xD4, 0x00, 0x00, 0x00, 0x85, 0xFF, 0x74, 0x49, 0x80, 0x3E, 0x00, 0x75, 0x44, 0x8B, 0x95, 0xF8, 0xFE, 0xFF, 0xFF, 0x8D, 0x8D, 0xFC, 0xFE, 0xFF, 0xFF, 0x51, 0x52, 0xFF, 0x15, 0x1C, 0xA0, 0x40, 0x00, 0x85, 0xC0, 0x74, 0x4A, 0x83, 0xC0, 0xFE, 0x83, 0xF8, 0x01, 0x76, 0x49, 0x8B, 0x85, 0xF8, 0xFE, 0xFF, 0xFF, 0xBE, 0xFE, 0xFF, 0xFF, 0xFF, 0x09, 0x35, 0x38, 0xEA, 0x40, 0x00, 0x50, 0xFF, 0x15, 0x04, 0xA0, 0x40, 0x00, 0x85, 0xC0, 0x74, 0x55, 0x09, 0x35, 0x38, 0xEA, 0x40, 0x00, 0xEB, 0x4D, 0x8B, 0x8D, 0xF8, 0xFE, 0xFF, 0xFF, 0x68, 0x80, 0x00, 0x00, 0x00, 0x56, 0x6A, 0x03, 0x6A, 0x00, 0x8D, 0x85, 0xFC, 0xFE, 0xFF, 0xFF, 0x50, 0x51, 0xFF, 0xD3, 0x85, 0xC0, 0x75, 0x45, 0x83, 0x0D, 0x38, 0xEA, 0x40, 0x00, 0x01, 0x83, 0xEE, 0x80, 0x47, 0x81, 0xFE, 0xD8, 0xBB, 0x40, 0x00, 0x0F, 0x8C, 0x59, 0xFF, 0xFF, 0xFF, 0x8B, 0x95, 0xF8, 0xFE, 0xFF, 0xFF, 0x52, 0xFF, 0x15, 0x04, 0xA0, 0x40, 0x00, 0x85, 0xC0, 0x74, 0x07, 0x83, 0x0D, 0x38, 0xEA, 0x40, 0x00, 0xFE, 0x8B, 0x4D, 0xFC, 0xA1, 0x38, 0xEA, 0x40, 0x00, 0x5F, 0x5E, 0x33, 0xCD, 0x5B, 0xE8, 0x4E, 0x0F, 0x00, 0x00, 0x8B, 0xE5, 0x5D, 0xC3, 0x8B, 0x8D, 0xF8, 0xFE, 0xFF, 0xFF, 0xBE, 0xFE, 0xFF, 0xFF, 0xFF, 0x09, 0x35, 0x38, 0xEA, 0x40, 0x00, 0x51, 0xFF, 0x15, 0x04, 0xA0, 0x40, 0x00, 0x85, 0xC0, 0x74, 0xCE, 0x09, 0x35, 0x38, 0xEA, 0x40, 0x00, 0xEB, 0xC6, 0x8B, 0x95, 0xF8, 0xFE, 0xFF, 0xFF, 0xBE, 0xFE, 0xFF, 0xFF, 0xFF, 0x09, 0x35, 0x38, 0xEA, 0x40, 0x00, 0x52, 0xFF, 0x15, 0x04, 0xA0, 0x40, 0x00, 0x85, 0xC0, 0x74, 0xAA, 0x09, 0x35, 0x38, 0xEA, 0x40, 0x00, 0xEB, 0xA2, 0xCC, 0xCC, 0xCC, 0x55, 0x8B, 0xEC, 0x81, 0xEC, 0x08, 0x01, 0x00, 0x00, 0xA1, 0x04, 0xD0, 0x40, 0x00, 0x33, 0xC5, 0x89, 0x45, 0xFC, 0x8B, 0x45, 0x08, 0x50, 0x68, 0xB8, 0xB9, 0x40, 0x00,
				0x68, 0x58, 0xBC, 0x40, 0x00, 0x68, 0xB0, 0xBC, 0x40, 0x00, 0x8D, 0x85, 0xFC, 0xFE, 0xFF, 0xFF, 0x68, 0x00, 0x01, 0x00, 0x00, 0x50, 0xE8, 0xD3, 0x11, 0x00, 0x00, 0x83, 0xC4, 0x18, 0x3D, 0x00, 0x01, 0x00, 0x00, 0x7C, 0x1B, 0xA1, 0x38, 0xEA, 0x40, 0x00, 0x83, 0xC8, 0xFE, 0xA3, 0x38, 0xEA, 0x40, 0x00, 0x8B, 0x4D, 0xFC, 0x33, 0xCD, 0xE8, 0xA7, 0x0E, 0x00, 0x00, 0x8B, 0xE5, 0x5D, 0xC3, 0x8D, 0x8D, 0xF8, 0xFE, 0xFF, 0xFF, 0x51, 0x6A, 0x02, 0x6A, 0x00, 0x8D, 0x95, 0xFC, 0xFE, 0xFF, 0xFF, 0x52, 0x68, 0x02, 0x00, 0x00, 0x80, 0xFF, 0x15, 0x18, 0xA0, 0x40, 0x00, 0x85, 0xC0, 0x74, 0x22, 0x83, 0xC0, 0xFE, 0x83, 0xF8, 0x01, 0x76, 0x07, 0x83, 0x0D, 0x38, 0xEA, 0x40, 0x00, 0xFE, 0xA1, 0x38, 0xEA, 0x40, 0x00, 0x8B, 0x4D, 0xFC, 0x33, 0xCD, 0xE8, 0x64, 0x0E, 0x00, 0x00, 0x8B, 0xE5, 0x5D, 0xC3, 0x8B, 0x85, 0xF8, 0xFE, 0xFF, 0xFF, 0x56, 0x8B, 0x35, 0x08, 0xA0, 0x40, 0x00, 0x68, 0xCC, 0xBC, 0x40, 0x00, 0x50, 0xFF, 0xD6, 0x85, 0xC0, 0x74, 0x3E, 0x83, 0xC0, 0xFE, 0x83, 0xF8, 0x01, 0x76, 0x3D, 0x8B, 0x8D, 0xF8, 0xFE, 0xFF, 0xFF, 0xBE, 0xFE, 0xFF, 0xFF, 0xFF, 0x09, 0x35, 0x38, 0xEA, 0x40, 0x00, 0x51, 0xFF, 0x15, 0x04, 0xA0, 0x40, 0x00, 0x85, 0xC0, 0x74, 0x61, 0x09, 0x35, 0x38, 0xEA, 0x40, 0x00, 0xA1, 0x38, 0xEA, 0x40, 0x00, 0x5E, 0x8B, 0x4D, 0xFC, 0x33, 0xCD, 0xE8, 0x0D, 0x0E, 0x00, 0x00, 0x8B, 0xE5, 0x5D, 0xC3, 0x83, 0x0D, 0x38, 0xEA, 0x40, 0x00, 0x01, 0x8B, 0x95, 0xF8, 0xFE, 0xFF, 0xFF, 0x68, 0xDC, 0xBC, 0x40, 0x00, 0x52, 0xFF, 0x15, 0x1C, 0xA0, 0x40, 0x00, 0x85, 0xC0, 0x74, 0x3E, 0x83, 0xC0, 0xFE, 0x83, 0xF8, 0x01, 0x76, 0x3D, 0x8B, 0x85, 0xF8, 0xFE, 0xFF, 0xFF, 0xBE, 0xFE, 0xFF, 0xFF, 0xFF, 0x09, 0x35, 0x38, 0xEA, 0x40, 0x00, 0x50, 0xFF, 0x15, 0x04, 0xA0, 0x40, 0x00, 0x85, 0xC0, 0x74, 0x06, 0x09, 0x35, 0x38, 0xEA, 0x40, 0x00, 0xA1, 0x38, 0xEA, 0x40, 0x00, 0x5E, 0x8B, 0x4D, 0xFC, 0x33, 0xCD, 0xE8, 0xB2, 0x0D, 0x00, 0x00, 0x8B, 0xE5, 0x5D, 0xC3, 0x83, 0x0D, 0x38, 0xEA, 0x40, 0x00, 0x01, 0x8B, 0x8D, 0xF8, 0xFE, 0xFF, 0xFF, 0x68, 0xE4, 0xBC, 0x40, 0x00, 0x51, 0xFF, 0xD6, 0x85, 0xC0, 0x74, 0x11, 0x83, 0xC0, 0xFE, 0x83, 0xF8, 0x01, 0x76, 0x10, 0x83, 0x0D, 0x38, 0xEA, 0x40, 0x00, 0xFE, 0xEB, 0x07, 0x83, 0x0D, 0x38, 0xEA, 0x40, 0x00, 0x01, 0x8B, 0x85, 0xF8, 0xFE, 0xFF, 0xFF, 0xE8, 0xF3, 0x0A, 0x00, 0x00, 0x8B, 0x4D, 0xFC, 0x33, 0xCD, 0x5E, 0xE8, 0x67, 0x0D, 0x00, 0x00, 0x8B, 0xE5, 0x5D, 0xC3, 0xCC, 0xCC, 0xCC, 0xCC, 0x55, 0x8B, 0xEC, 0x81, 0xEC, 0x0C, 0x01, 0x00, 0x00, 0xA1, 0x04, 0xD0, 0x40, 0x00, 0x33, 0xC5, 0x89, 0x45, 0xFC, 0x53, 0x68, 0xB8, 0xB9, 0x40, 0x00, 0x68, 0x58, 0xBC, 0x40, 0x00, 0x68, 0xF4, 0xBC, 0x40, 0x00, 0xBB, 0x00, 0x01, 0x00, 0x00, 0x8D, 0x85, 0xFC, 0xFE, 0xFF, 0xFF, 0x53, 0x50, 0xE8, 0x35, 0x10, 0x00, 0x00, 0x83, 0xC4, 0x14, 0x3B, 0xC3, 0x7C, 0x1C, 0xA1, 0x38, 0xEA, 0x40, 0x00, 0x83, 0xC8, 0xFE, 0xA3, 0x38, 0xEA, 0x40, 0x00, 0x5B, 0x8B, 0x4D, 0xFC, 0x33, 0xCD, 0xE8, 0x0B, 0x0D, 0x00, 0x00, 0x8B, 0xE5, 0x5D, 0xC3, 0x8D, 0x8D, 0xF8, 0xFE, 0xFF, 0xFF, 0x51, 0x6A, 0x08, 0x6A, 0x00, 0x8D, 0x95, 0xFC, 0xFE, 0xFF, 0xFF, 0x52, 0x68, 0x02, 0x00, 0x00, 0x80, 0xFF,
				0x15, 0x18, 0xA0, 0x40, 0x00, 0x85, 0xC0, 0x74, 0x11, 0x83, 0xC0, 0xFE, 0x83, 0xF8, 0x01, 0x0F, 0x86, 0xF7, 0x00, 0x00, 0x00, 0xE9, 0xEB, 0x00, 0x00, 0x00, 0x8B, 0x45, 0x08, 0x83, 0xE8, 0x00, 0x56, 0x57, 0x0F, 0x84, 0xA8, 0x00, 0x00, 0x00, 0x48, 0x74, 0x51, 0x48, 0x0F, 0x85, 0xC0, 0x00, 0x00, 0x00, 0x8B, 0x3D, 0x00, 0xA0, 0x40, 0x00, 0x33, 0xF6, 0x8D, 0x9B, 0x00, 0x00, 0x00, 0x00, 0x8B, 0x95, 0xF8, 0xFE, 0xFF, 0xFF, 0x6A, 0x00, 0x6A, 0x00, 0x6A, 0x00, 0x6A, 0x00, 0x8D, 0x85, 0xF4, 0xFE, 0xFF, 0xFF, 0x50, 0x8D, 0x8D, 0xFC, 0xFE, 0xFF, 0xFF, 0x51, 0x56, 0x52, 0x89, 0x9D, 0xF4, 0xFE, 0xFF, 0xFF, 0xFF, 0xD7, 0x85, 0xC0, 0x75, 0x56, 0x8D, 0x85, 0xFC, 0xFE, 0xFF, 0xFF, 0x50, 0xE8, 0x7A, 0xFD, 0xFF, 0xFF, 0x83, 0xC4, 0x04, 0x46, 0xEB, 0xC4, 0x8B, 0x3D, 0x00, 0xA0, 0x40, 0x00, 0x33, 0xF6, 0x8B, 0x85, 0xF8, 0xFE, 0xFF, 0xFF, 0x6A, 0x00, 0x6A, 0x00, 0x6A, 0x00, 0x6A, 0x00, 0x8D, 0x8D, 0xF4, 0xFE, 0xFF, 0xFF, 0x51, 0x8D, 0x95, 0xFC, 0xFE, 0xFF, 0xFF, 0x52, 0x56, 0x50, 0x89, 0x9D, 0xF4, 0xFE, 0xFF, 0xFF, 0xFF, 0xD7, 0x85, 0xC0, 0x75, 0x12, 0x8D, 0x8D, 0xFC, 0xFE, 0xFF, 0xFF, 0x51, 0xE8, 0x76, 0xFB, 0xFF, 0xFF, 0x83, 0xC4, 0x04, 0x46, 0xEB, 0xC4, 0x3D, 0x03, 0x01, 0x00, 0x00, 0x74, 0x2B, 0x83, 0x0D, 0x38, 0xEA, 0x40, 0x00, 0xFE, 0xEB, 0x22, 0x8B, 0x95, 0xF8, 0xFE, 0xFF, 0xFF, 0x52, 0x8D, 0x8D, 0xFC, 0xFE, 0xFF, 0xFF, 0x33, 0xD2, 0xE8, 0x3C, 0x09, 0x00, 0x00, 0x83, 0xC4, 0x04, 0x83, 0xF8, 0x01, 0x75, 0x06, 0x09, 0x05, 0x38, 0xEA, 0x40, 0x00, 0x8B, 0x85, 0xF8, 0xFE, 0xFF, 0xFF, 0x50, 0xFF, 0x15, 0x04, 0xA0, 0x40, 0x00, 0x5F, 0x5E, 0x85, 0xC0, 0x74, 0x07, 0x83, 0x0D, 0x38, 0xEA, 0x40, 0x00, 0xFE, 0x8B, 0x4D, 0xFC, 0xA1, 0x38, 0xEA, 0x40, 0x00, 0x33, 0xCD, 0x5B, 0xE8, 0xD3, 0x0B, 0x00, 0x00, 0x8B, 0xE5, 0x5D, 0xC3, 0x55, 0x8B, 0xEC, 0x81, 0xEC, 0x0C, 0x01, 0x00, 0x00, 0xA1, 0x04, 0xD0, 0x40, 0x00, 0x33, 0xC5, 0x89, 0x45, 0xFC, 0x8B, 0xC2, 0x56, 0x8D, 0x70, 0x01, 0x8D, 0xA4, 0x24, 0x00, 0x00, 0x00, 0x00, 0x8A, 0x08, 0x40, 0x84, 0xC9, 0x75, 0xF9, 0x2B, 0xC6, 0x83, 0xF8, 0x04, 0x75, 0x72, 0x52, 0x68, 0x00, 0xBD, 0x40, 0x00, 0x68, 0x50, 0xBD, 0x40, 0x00, 0x8D, 0x85, 0xFC, 0xFE, 0xFF, 0xFF, 0x68, 0x00, 0x01, 0x00, 0x00, 0x50, 0xE8, 0x90, 0x0E, 0x00, 0x00, 0x83, 0xC4, 0x14, 0x3D, 0x00, 0x01, 0x00, 0x00, 0x7C, 0x1C, 0xA1, 0x38, 0xEA, 0x40, 0x00, 0x83, 0xC8, 0xFE, 0xA3, 0x38, 0xEA, 0x40, 0x00, 0x5E, 0x8B, 0x4D, 0xFC, 0x33, 0xCD, 0xE8, 0x63, 0x0B, 0x00, 0x00, 0x8B, 0xE5, 0x5D, 0xC3, 0x8D, 0x8D, 0xF8, 0xFE, 0xFF, 0xFF, 0x51, 0x6A, 0x03, 0x6A, 0x00, 0x8D, 0x95, 0xFC, 0xFE, 0xFF, 0xFF, 0x52, 0x68, 0x02, 0x00, 0x00, 0x80, 0xFF, 0x15, 0x18, 0xA0, 0x40, 0x00, 0x85, 0xC0, 0x74, 0x23, 0x83, 0xC0, 0xFE, 0x83, 0xF8, 0x01, 0x76, 0x07, 0x83, 0x0D, 0x38, 0xEA, 0x40, 0x00, 0xFE, 0xA1, 0x38, 0xEA, 0x40, 0x00, 0x5E, 0x8B, 0x4D, 0xFC, 0x33, 0xCD, 0xE8, 0x1F, 0x0B, 0x00, 0x00, 0x8B, 0xE5, 0x5D, 0xC3, 0x8B, 0x95, 0xF8, 0xFE, 0xFF, 0xFF, 0x8D, 0x85, 0xF4, 0xFE, 0xFF, 0xFF, 0x50, 0x8D, 0x8D, 0xFC, 0xFE, 0xFF, 0xFF, 0x51, 0x6A, 0x00, 0x6A, 0x00, 0x68, 0x58, 0xBD, 0x40, 0x00, 0x52, 0xC7, 0x85,
				0xF4, 0xFE, 0xFF, 0xFF, 0x00, 0x01, 0x00, 0x00, 0xFF, 0x15, 0x10, 0xA0, 0x40, 0x00, 0x85, 0xC0, 0x74, 0x3E, 0x83, 0xC0, 0xFE, 0xBE, 0xFE, 0xFF, 0xFF, 0xFF, 0x83, 0xF8, 0x01, 0x76, 0x06, 0x09, 0x35, 0x38, 0xEA, 0x40, 0x00, 0x8B, 0x85, 0xF8, 0xFE, 0xFF, 0xFF, 0x50, 0xFF, 0x15, 0x04, 0xA0, 0x40, 0x00, 0x85, 0xC0, 0x74, 0x06, 0x09, 0x35, 0x38, 0xEA, 0x40, 0x00, 0xA1, 0x38, 0xEA, 0x40, 0x00, 0x5E, 0x8B, 0x4D, 0xFC, 0x33, 0xCD, 0xE8, 0xAF, 0x0A, 0x00, 0x00, 0x8B, 0xE5, 0x5D, 0xC3, 0x83, 0xBD, 0xF4, 0xFE, 0xFF, 0xFF, 0x05, 0x0F, 0x82, 0x99, 0x02, 0x00, 0x00, 0x6A, 0x05, 0x8D, 0x8D, 0xFC, 0xFE, 0xFF, 0xFF, 0x68, 0x68, 0xBD, 0x40, 0x00, 0x51, 0xE8, 0x43, 0x0D, 0x00, 0x00, 0x83, 0xC4, 0x0C, 0x85, 0xC0, 0x0F, 0x85, 0x7B, 0x02, 0x00, 0x00, 0x8B, 0x45, 0x08, 0x48, 0x53, 0x57, 0x0F, 0x84, 0x10, 0x01, 0x00, 0x00, 0x48, 0x0F, 0x85, 0xED, 0x01, 0x00, 0x00, 0x33, 0xFF, 0xEB, 0x0A, 0x8D, 0xA4, 0x24, 0x00, 0x00, 0x00, 0x00, 0x8D, 0x49, 0x00, 0x33, 0xF6, 0x0F, 0xB6, 0x05, 0xCB, 0xB9, 0x40, 0x00, 0x8A, 0x0D, 0xC9, 0xB9, 0x40, 0x00, 0x0F, 0xB6, 0x15, 0xCA, 0xB9, 0x40, 0x00, 0xC1, 0xE0, 0x08, 0x0B, 0xD0, 0xA0, 0xC8, 0xB9, 0x40, 0x00, 0x52, 0x0F, 0xB6, 0xC9, 0x0F, 0xB6, 0xD0, 0xC1, 0xE1, 0x08, 0x0B, 0xD1, 0x52, 0x56, 0x57, 0x68, 0x70, 0xBD, 0x40, 0x00, 0x8D, 0x85, 0xFC, 0xFE, 0xFF, 0xFF, 0x68, 0x00, 0x01, 0x00, 0x00, 0x50, 0xE8, 0x25, 0x0D, 0x00, 0x00, 0x83, 0xC4, 0x1C, 0x3D, 0x00, 0x01, 0x00, 0x00, 0x7D, 0x74, 0x8D, 0x8D, 0xFC, 0xFE, 0xFF, 0xFF, 0x68, 0xA0, 0xBD, 0x40, 0x00, 0x51, 0xE8, 0x8E, 0x0B, 0x00, 0x00, 0x83, 0xC4, 0x08, 0x85, 0xC0, 0x75, 0x16, 0x8B, 0x9D, 0xF8, 0xFE, 0xFF, 0xFF, 0xE8, 0xDE, 0x07, 0x00, 0x00, 0x83, 0xF8, 0x01, 0x0F, 0x85, 0xC3, 0x01, 0x00, 0x00, 0xEB, 0x2D, 0x8B, 0x85, 0xF8, 0xFE, 0xFF, 0xFF, 0x8D, 0x95, 0xFC, 0xFE, 0xFF, 0xFF, 0x52, 0x50, 0xFF, 0x15, 0x1C, 0xA0, 0x40, 0x00, 0x85, 0xC0, 0x74, 0x0E, 0x83, 0xC0, 0xFE, 0x83, 0xF8, 0x01, 0x0F, 0x87, 0x5C, 0x01, 0x00, 0x00, 0xEB, 0x07, 0x83, 0x0D, 0x38, 0xEA, 0x40, 0x00, 0x01, 0x46, 0x83, 0xFE, 0x04, 0x0F, 0x8C, 0x4E, 0xFF, 0xFF, 0xFF, 0x47, 0x83, 0xFF, 0x14, 0x0F, 0x8C, 0x42, 0xFF, 0xFF, 0xFF, 0xE9, 0x1C, 0x01, 0x00, 0x00, 0x8B, 0x8D, 0xF8, 0xFE, 0xFF, 0xFF, 0xBE, 0xFE, 0xFF, 0xFF, 0xFF, 0x09, 0x35, 0x38, 0xEA, 0x40, 0x00, 0x51, 0xFF, 0x15, 0x04, 0xA0, 0x40, 0x00, 0x85, 0xC0, 0x74, 0x06, 0x09, 0x35, 0x38, 0xEA, 0x40, 0x00, 0xA1, 0x38, 0xEA, 0x40, 0x00, 0x5F, 0x5B, 0x5E, 0x8B, 0x4D, 0xFC, 0x33, 0xCD, 0xE8, 0x68, 0x09, 0x00, 0x00, 0x8B, 0xE5, 0x5D, 0xC3, 0x33, 0xDB, 0x8D, 0x49, 0x00, 0x33, 0xFF, 0xBE, 0xD8, 0xB9, 0x40, 0x00, 0xEB, 0x07, 0x8D, 0xA4, 0x24, 0x00, 0x00, 0x00, 0x00, 0x0F, 0xB6, 0x05, 0xCB, 0xB9, 0x40, 0x00, 0x8A, 0x0D, 0xC9, 0xB9, 0x40, 0x00, 0x0F, 0xB6, 0x15, 0xCA, 0xB9, 0x40, 0x00, 0xC1, 0xE0, 0x08, 0x0B, 0xD0, 0xA0, 0xC8, 0xB9, 0x40, 0x00, 0x52, 0x0F, 0xB6, 0xC9, 0x0F, 0xB6, 0xD0, 0xC1, 0xE1, 0x08, 0x0B, 0xD1, 0x52, 0x57, 0x53, 0x68, 0x70, 0xBD, 0x40, 0x00, 0x8D, 0x85, 0xFC, 0xFE, 0xFF, 0xFF, 0x68, 0x00, 0x01, 0x00, 0x00, 0x50, 0xE8, 0x17, 0x0C, 0x00, 0x00, 0x83, 0xC4, 0x1C, 0x3D, 0x00,
				0x01, 0x00, 0x00, 0x0F, 0x8D, 0xBF, 0x00, 0x00, 0x00, 0x85, 0xFF, 0x74, 0x27, 0x80, 0x3E, 0x00, 0x75, 0x22, 0x8B, 0x95, 0xF8, 0xFE, 0xFF, 0xFF, 0x8D, 0x8D, 0xFC, 0xFE, 0xFF, 0xFF, 0x51, 0x52, 0xFF, 0x15, 0x1C, 0xA0, 0x40, 0x00, 0x85, 0xC0, 0x74, 0x2C, 0x83, 0xC0, 0xFE, 0x83, 0xF8, 0x01, 0x77, 0x73, 0xEB, 0x29, 0x8B, 0x8D, 0xF8, 0xFE, 0xFF, 0xFF, 0x68, 0x80, 0x00, 0x00, 0x00, 0x56, 0x6A, 0x03, 0x6A, 0x00, 0x8D, 0x85, 0xFC, 0xFE, 0xFF, 0xFF, 0x50, 0x51, 0xFF, 0x15, 0x0C, 0xA0, 0x40, 0x00, 0x85, 0xC0, 0x75, 0x4F, 0x83, 0x0D, 0x38, 0xEA, 0x40, 0x00, 0x01, 0x83, 0xEE, 0x80, 0x47, 0x81, 0xFE, 0xD8, 0xBB, 0x40, 0x00, 0x0F, 0x8C, 0x4B, 0xFF, 0xFF, 0xFF, 0x43, 0x83, 0xFB, 0x14, 0x0F, 0x8C, 0x31, 0xFF, 0xFF, 0xFF, 0x8B, 0x8D, 0xF8, 0xFE, 0xFF, 0xFF, 0xE8, 0x26, 0x06, 0x00, 0x00, 0x83, 0xF8, 0x01, 0x75, 0x5F, 0x8B, 0x85, 0xF8, 0xFE, 0xFF, 0xFF, 0x68, 0xE4, 0xBC, 0x40, 0x00, 0x50, 0xFF, 0x15, 0x08, 0xA0, 0x40, 0x00, 0x85, 0xC0, 0x74, 0x42, 0x83, 0xC0, 0xFE, 0x83, 0xF8, 0x01, 0x76, 0x41, 0x8B, 0x85, 0xF8, 0xFE, 0xFF, 0xFF, 0x83, 0x0D, 0x38, 0xEA, 0x40, 0x00, 0xFE, 0xE8, 0xD1, 0x05, 0x00, 0x00, 0x5F, 0x5B, 0x5E, 0x8B, 0x4D, 0xFC, 0x33, 0xCD, 0xE8, 0x43, 0x08, 0x00, 0x00, 0x8B, 0xE5, 0x5D, 0xC3, 0x8B, 0x95, 0xF8, 0xFE, 0xFF, 0xFF, 0xBE, 0xFE, 0xFF, 0xFF, 0xFF, 0x09, 0x35, 0x38, 0xEA, 0x40, 0x00, 0x52, 0xE9, 0x9E, 0xFE, 0xFF, 0xFF, 0x83, 0x0D, 0x38, 0xEA, 0x40, 0x00, 0x01, 0x8B, 0x85, 0xF8, 0xFE, 0xFF, 0xFF, 0xE8, 0x97, 0x05, 0x00, 0x00, 0x5F, 0x5B, 0x5E, 0x8B, 0x4D, 0xFC, 0x33, 0xCD, 0xE8, 0x09, 0x08, 0x00, 0x00, 0x8B, 0xE5, 0x5D, 0xC3, 0x8B, 0x8D, 0xF8, 0xFE, 0xFF, 0xFF, 0x51, 0xFF, 0x15, 0x04, 0xA0, 0x40, 0x00, 0x85, 0xC0, 0x0F, 0x84, 0xC1, 0xFC, 0xFF, 0xFF, 0x8B, 0x4D, 0xFC, 0x83, 0x0D, 0x38, 0xEA, 0x40, 0x00, 0xFE, 0xA1, 0x38, 0xEA, 0x40, 0x00, 0x33, 0xCD, 0x5E, 0xE8, 0xD9, 0x07, 0x00, 0x00, 0x8B, 0xE5, 0x5D, 0xC3, 0xCC, 0xCC, 0xCC, 0xCC, 0xCC, 0xCC, 0x55, 0x8B, 0xEC, 0x81, 0xEC, 0x0C, 0x01, 0x00, 0x00, 0xA1, 0x04, 0xD0, 0x40, 0x00, 0x33, 0xC5, 0x89, 0x45, 0xFC, 0xB9, 0xB8, 0xBD, 0x40, 0x00, 0xB8, 0xB8, 0xB9, 0x40, 0x00, 0x8D, 0x49, 0x00, 0x8A, 0x10, 0x3A, 0x11, 0x75, 0x1A, 0x84, 0xD2, 0x74, 0x12, 0x8A, 0x50, 0x01, 0x3A, 0x51, 0x01, 0x75, 0x0E, 0x83, 0xC0, 0x02, 0x83, 0xC1, 0x02, 0x84, 0xD2, 0x75, 0xE4, 0x33, 0xC0, 0xEB, 0x05, 0x1B, 0xC0, 0x83, 0xD8, 0xFF, 0x85, 0xC0, 0x0F, 0x84, 0xC1, 0x00, 0x00, 0x00, 0x8D, 0x85, 0xF8, 0xFE, 0xFF, 0xFF, 0x50, 0x6A, 0x08, 0x6A, 0x00, 0x68, 0x00, 0xBD, 0x40, 0x00, 0x68, 0x02, 0x00, 0x00, 0x80, 0xFF, 0x15, 0x18, 0xA0, 0x40, 0x00, 0x85, 0xC0, 0x74, 0x26, 0x83, 0xC0, 0xFE, 0x83, 0xF8, 0x01, 0x0F, 0x86, 0x96, 0x00, 0x00, 0x00, 0x83, 0x0D, 0x38, 0xEA, 0x40, 0x00, 0xFE, 0xA1, 0x38, 0xEA, 0x40, 0x00, 0x8B, 0x4D, 0xFC, 0x33, 0xCD, 0xE8, 0x41, 0x07, 0x00, 0x00, 0x8B, 0xE5, 0x5D, 0xC3, 0x56, 0x57, 0x8B, 0x3D, 0x00, 0xA0, 0x40, 0x00, 0x33, 0xF6, 0x8D, 0x64, 0x24, 0x00, 0x8B, 0x85, 0xF8, 0xFE, 0xFF, 0xFF, 0x6A, 0x00, 0x6A, 0x00, 0x6A, 0x00, 0x6A, 0x00, 0x8D, 0x8D, 0xF4, 0xFE, 0xFF, 0xFF, 0x51, 0x8D, 0x95, 0xFC, 0xFE, 0xFF, 0xFF, 0x52,
				0x56, 0x50, 0xC7, 0x85, 0xF4, 0xFE, 0xFF, 0xFF, 0x00, 0x01, 0x00, 0x00, 0xFF, 0xD7, 0x85, 0xC0, 0x75, 0x15, 0x8B, 0x4D, 0x08, 0x51, 0x8D, 0x95, 0xFC, 0xFE, 0xFF, 0xFF, 0xE8, 0x23, 0xFB, 0xFF, 0xFF, 0x83, 0xC4, 0x04, 0x46, 0xEB, 0xBD, 0xBE, 0xFE, 0xFF, 0xFF, 0xFF, 0x3D, 0x03, 0x01, 0x00, 0x00, 0x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
				0xF6, 0x74, 0x14, 0x6A, 0x40, 0x68, 0x34, 0xBF, 0x40, 0x00, 0x68, 0x40, 0xBF, 0x40, 0x00, 0x6A, 0x00, 0xFF, 0x15, 0x24, 0xA1, 0x40, 0x00, 0x33, 0xC0, 0xC3, 0x85, 0xF6, 0x74, 0x14, 0x6A, 0x40, 0x68, 0x34, 0xBF, 0x40, 0x00, 0x68, 0x90, 0xBF, 0x40, 0x00, 0x6A, 0x00, 0xFF, 0x15, 0x24, 0xA1, 0x40, 0x00, 0x33, 0xC0, 0xC3, 0x6A, 0x10, 0x68, 0x34, 0xBF, 0x40, 0x00, 0x68, 0xE0, 0xBF, 0x40, 0x00, 0x6A, 0x00, 0xFF, 0x15, 0x24, 0xA1, 0x40, 0x00, 0xB8, 0x01, 0x00, 0x00, 0x00, 0xC3, 0x6A, 0x10, 0x68, 0x34, 0xBF, 0x40, 0x00, 0x68, 0x38, 0xC0, 0x40, 0x00, 0x6A, 0x00, 0xFF, 0x15, 0x24, 0xA1, 0x40, 0x00, 0xB8, 0x01, 0x00, 0x00, 0x00, 0xC3, 0x6A, 0x10, 0x68, 0x34, 0xBF, 0x40, 0x00, 0x68, 0x30, 0xBE, 0x40, 0x00, 0x6A, 0x00, 0xFF, 0x15, 0x24, 0xA1, 0x40, 0x00, 0xB8, 0x01, 0x00, 0x00, 0x00, 0xC3, 0x90, 0xEF, 0x1B, 0x40, 0x00, 0xD5, 0x1B, 0x40, 0x00, 0xBA, 0x1B, 0x40, 0x00, 0x9F, 0x1B, 0x40, 0x00, 0xCC, 0xCC, 0xCC, 0xCC, 0xCC, 0xCC, 0xCC, 0xCC, 0xCC, 0xCC, 0xCC, 0xCC, 0x55, 0x8B, 0xEC, 0x81, 0x7D, 0x0C, 0x11, 0x01, 0x00, 0x00, 0x74, 0x06, 0x33, 0xC0, 0x5D, 0xC2, 0x10, 0x00, 0x8B, 0x45, 0x10, 0x8B, 0x4D, 0x08, 0x50, 0x51, 0xFF, 0x15, 0x28, 0xA1, 0x40, 0x00, 0xB8, 0x01, 0x00, 0x00, 0x00, 0x5D, 0xC2, 0x10, 0x00, 0xCC, 0xCC, 0xCC, 0xCC, 0xCC, 0xCC, 0xCC, 0x55, 0x8B, 0xEC, 0xE8, 0xA8, 0xFD, 0xFF, 0xFF, 0x85, 0xC0, 0x0F, 0x84, 0x08, 0x01, 0x00, 0x00, 0x8B, 0x4D, 0x10, 0x8A, 0x01, 0x3C, 0x2D, 0x74, 0x04, 0x3C, 0x2F, 0x75, 0x2E, 0x80, 0x79, 0x02, 0x00, 0x75, 0x28, 0x0F, 0xBE, 0x41, 0x01, 0x83, 0xC0, 0xB7, 0x83, 0xF8, 0x29, 0x77, 0x1C, 0x0F, 0xB6, 0x80, 0xAC, 0x1D, 0x40, 0x00, 0xFF, 0x24, 0x85, 0xA0, 0x1D, 0x40, 0x00, 0xB8, 0x64, 0x00, 0x00, 0x00, 0xEB, 0x09, 0xB8, 0x65, 0x00, 0x00, 0x00, 0xEB, 0x02, 0x33, 0xC0, 0x83, 0xE8, 0x64, 0x0F, 0x84, 0xCB, 0x00, 0x00, 0x00, 0x48, 0x74, 0x3C, 0x8B, 0x4D, 0x08, 0x6A, 0x00, 0x68, 0x40, 0x1C, 0x40, 0x00, 0x6A, 0x00, 0x68, 0x6C, 0xC0, 0x40, 0x00, 0x51, 0xFF, 0x15, 0x2C, 0xA1, 0x40, 0x00, 0x83, 0xE8, 0x64, 0x74, 0x11, 0x48, 0x75, 0x4B, 0x56, 0x8D, 0x70, 0x01, 0xE8, 0x7E, 0xFE, 0xFF, 0xFF, 0x5E, 0x5D, 0xC2, 0x10, 0x00, 0x6A, 0x01, 0xE8, 0xA2, 0xFD, 0xFF, 0xFF, 0x83, 0xC4, 0x04, 0x5D, 0xC2, 0x10, 0x00, 0x6A, 0x02, 0xC7, 0x05, 0x38, 0xEA, 0x40, 0x00, 0x00, 0x00, 0x00, 0x00, 0xE8, 0x4A, 0xF6, 0xFF, 0xFF, 0x6A, 0x02, 0xE8, 0xD3, 0xFB, 0xFF, 0xFF, 0xA1, 0x38, 0xEA, 0x40, 0x00, 0x83, 0xC0, 0x02, 0x83, 0xC4, 0x08, 0x83, 0xF8, 0x03, 0x77, 0x47, 0xFF, 0x24, 0x85, 0xD8, 0x1D, 0x40, 0x00, 0x33, 0xC0, 0x5D, 0xC2, 0x10, 0x00, 0x6A, 0x10, 0x68, 0x34, 0xBF, 0x40, 0x00, 0x68, 0xE0, 0xBF, 0x40, 0x00, 0x6A, 0x00, 0xFF, 0x15, 0x24, 0xA1, 0x40, 0x00, 0xB8, 0x01, 0x00, 0x00, 0x00, 0x5D, 0xC2, 0x10, 0x00, 0x6A, 0x10, 0x68, 0x34, 0xBF, 0x40, 0x00, 0x68, 0x38, 0xC0, 0x40, 0x00, 0x6A, 0x00, 0xFF, 0x15, 0x24, 0xA1, 0x40, 0x00, 0xB8, 0x01, 0x00, 0x00, 0x00, 0x5D, 0xC2, 0x10, 0x00, 0x6A, 0x10, 0x68, 0x34, 0xBF, 0x40, 0x00, 0x68, 0x30, 0xBE, 0x40, 0x00, 0x6A, 0x00, 0xFF, 0x15, 0x24, 0xA1, 0x40, 0x00, 0xB8, 0x01, 0x00, 0x00, 0x00, 0x5D, 0xC2, 0x10, 0x00, 0x6A, 0x00, 0xE8,
				0x08, 0xFD, 0xFF, 0xFF, 0x83, 0xC4, 0x04, 0x5D, 0xC2, 0x10, 0x00, 0x90, 0xAD, 0x1C, 0x40, 0x00, 0xB4, 0x1C, 0x40, 0x00, 0xBB, 0x1C, 0x40, 0x00, 0x00, 0x02, 0x02, 0x02, 0x02, 0x02, 0x02, 0x02, 0x02, 0x01, 0x02, 0x02, 0x02, 0x02, 0x02, 0x02, 0x02, 0x02, 0x02, 0x02, 0x02, 0x02, 0x02, 0x02, 0x02, 0x02, 0x02, 0x02, 0x02, 0x02, 0x02, 0x02, 0x00, 0x02, 0x02, 0x02, 0x02, 0x02, 0x02, 0x02, 0x02, 0x01, 0x8B, 0xFF, 0x57, 0x1D, 0x40, 0x00, 0x3A, 0x1D, 0x40, 0x00, 0x34, 0x1D, 0x40, 0x00, 0x34, 0x1D, 0x40, 0x00, 0xCC, 0xCC, 0xCC, 0xCC, 0xCC, 0xCC, 0xCC, 0xCC, 0x55, 0x8B, 0xEC, 0x51, 0x6A, 0x00, 0x6A, 0x00, 0x6A, 0x00, 0x6A, 0x00, 0x8D, 0x45, 0xFC, 0x50, 0x8B, 0x45, 0x08, 0x51, 0x52, 0x50, 0xC7, 0x45, 0xFC, 0x00, 0x01, 0x00, 0x00, 0xFF, 0x15, 0x00, 0xA0, 0x40, 0x00, 0x85, 0xC0, 0x74, 0x1C, 0x3D, 0x03, 0x01, 0x00, 0x00, 0x74, 0x0F, 0xB8, 0xFE, 0xFF, 0xFF, 0xFF, 0x09, 0x05, 0x38, 0xEA, 0x40, 0x00, 0x8B, 0xE5, 0x5D, 0xC3, 0x33, 0xC0, 0x8B, 0xE5, 0x5D, 0xC3, 0xB8, 0x01, 0x00, 0x00, 0x00, 0x8B, 0xE5, 0x5D, 0xC3, 0xCC, 0xCC, 0xCC, 0xCC, 0x50, 0xFF, 0x15, 0x04, 0xA0, 0x40, 0x00, 0x85, 0xC0, 0xA1, 0x38, 0xEA, 0x40, 0x00, 0x74, 0x08, 0x83, 0xC8, 0xFE, 0xA3, 0x38, 0xEA, 0x40, 0x00, 0xC3, 0xCC, 0xCC, 0xCC, 0xCC, 0xCC, 0xCC, 0xCC, 0x55, 0x8B, 0xEC, 0x51, 0x6A, 0x04, 0x8D, 0x45, 0xFC, 0x50, 0x6A, 0x04, 0x6A, 0x00, 0x68, 0x88, 0xBD, 0x40, 0x00, 0x51, 0xC7, 0x45, 0xFC, 0x01, 0x00, 0x00, 0x00, 0xFF, 0x15, 0x0C, 0xA0, 0x40, 0x00, 0x85, 0xC0, 0x75, 0x10, 0x83, 0x0D, 0x38, 0xEA, 0x40, 0x00, 0x01, 0xB8, 0x01, 0x00, 0x00, 0x00, 0x8B, 0xE5, 0x5D, 0xC3, 0xB8, 0xFE, 0xFF, 0xFF, 0xFF, 0x09, 0x05, 0x38, 0xEA, 0x40, 0x00, 0x8B, 0xE5, 0x5D, 0xC3, 0xCC, 0xCC, 0xCC, 0xCC, 0xCC, 0xCC, 0xCC, 0xCC, 0xCC, 0xCC, 0xCC, 0xCC, 0x55, 0x8B, 0xEC, 0x83, 0xEC, 0x08, 0x56, 0x57, 0xBF, 0x80, 0x00, 0x00, 0x00, 0x57, 0xE8, 0xED, 0x05, 0x00, 0x00, 0x8B, 0xF0, 0x83, 0xC4, 0x04, 0x85, 0xF6, 0x0F, 0x84, 0xE5, 0x00, 0x00, 0x00, 0x8D, 0x45, 0xFC, 0x50, 0x56, 0x8D, 0x4D, 0xF8, 0x51, 0x6A, 0x00, 0x68, 0xA0, 0xBD, 0x40, 0x00, 0x53, 0x89, 0x7D, 0xFC, 0xFF, 0x15, 0x10, 0xA0, 0x40, 0x00, 0x3D, 0xEA, 0x00, 0x00, 0x00, 0x0F, 0x87, 0xB7, 0x00, 0x00, 0x00, 0x0F, 0xB6, 0x90, 0xD4, 0x1F, 0x40, 0x00, 0xFF, 0x24, 0x95, 0xC8, 0x1F, 0x40, 0x00, 0x83, 0x7D, 0xF8, 0x03, 0x75, 0x5A, 0x39, 0x7D, 0xFC, 0x75, 0x55, 0x8B, 0xC7, 0xB9, 0xD8, 0xBB, 0x40, 0x00, 0x8B, 0xFE, 0x8B, 0x17, 0x3B, 0x11, 0x75, 0x46, 0x83, 0xE8, 0x04, 0x83, 0xC1, 0x04, 0x83, 0xC7, 0x04, 0x83, 0xF8, 0x04, 0x73, 0xEC, 0x85, 0xC0, 0x74, 0x20, 0x8A, 0x11, 0x3A, 0x17, 0x75, 0x2E, 0x83, 0xF8, 0x01, 0x76, 0x15, 0x8A, 0x51, 0x01, 0x3A, 0x57, 0x01, 0x75, 0x21, 0x83, 0xF8, 0x02, 0x76, 0x08, 0x8A, 0x41, 0x02, 0x3A, 0x47, 0x02, 0x75, 0x14, 0x56, 0xE8, 0x21, 0x05, 0x00, 0x00, 0x83, 0xC4, 0x04, 0x5F, 0xB8, 0x01, 0x00, 0x00, 0x00, 0x5E, 0x8B, 0xE5, 0x5D, 0xC3, 0x56, 0xE8, 0x0D, 0x05, 0x00, 0x00, 0x83, 0xC4, 0x04, 0x68, 0x80, 0x00, 0x00, 0x00, 0x68, 0xD8, 0xBB, 0x40, 0x00, 0x6A, 0x03, 0x6A, 0x00, 0x68, 0xA0, 0xBD, 0x40, 0x00, 0x53, 0xFF, 0x15, 0x0C, 0xA0, 0x40, 0x00, 0x85, 0xC0,
				0xB8, 0x01, 0x00, 0x00, 0x00, 0x74, 0x2B, 0xB8, 0xFE, 0xFF, 0xFF, 0xFF, 0x09, 0x05, 0x38, 0xEA, 0x40, 0x00, 0x5F, 0x5E, 0x8B, 0xE5, 0x5D, 0xC3, 0x56, 0xE8, 0xD0, 0x04, 0x00, 0x00, 0x83, 0xC4, 0x04, 0x57, 0xEB, 0xC5, 0x56, 0xE8, 0xC4, 0x04, 0x00, 0x00, 0x83, 0xC4, 0x04, 0xB8, 0xFE, 0xFF, 0xFF, 0x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
				0x03, 0x83, 0xC1, 0x20, 0x85, 0xC0, 0x74, 0x04, 0x3B, 0xC1, 0x74, 0xDA, 0x5F, 0x2B, 0xC1, 0x5E, 0x5D, 0xC3, 0x8B, 0xFF, 0x55, 0x8B, 0xEC, 0x83, 0xEC, 0x10, 0x53, 0xFF, 0x75, 0x10, 0x8D, 0x4D, 0xF0, 0xE8, 0x2C, 0xFF, 0xFF, 0xFF, 0x8B, 0x5D, 0x08, 0x85, 0xDB, 0x75, 0x23, 0xE8, 0xBE, 0x17, 0x00, 0x00, 0xC7, 0x00, 0x16, 0x00, 0x00, 0x00, 0xE8, 0x61, 0x17, 0x00, 0x00, 0x38, 0x5D, 0xFC, 0x74, 0x07, 0x8B, 0x45, 0xF8, 0x83, 0x60, 0x70, 0xFD, 0xB8, 0xFF, 0xFF, 0xFF, 0x7F, 0xEB, 0x7F, 0x56, 0x8B, 0x75, 0x0C, 0x85, 0xF6, 0x75, 0x24, 0xE8, 0x93, 0x17, 0x00, 0x00, 0xC7, 0x00, 0x16, 0x00, 0x00, 0x00, 0xE8, 0x36, 0x17, 0x00, 0x00, 0x80, 0x7D, 0xFC, 0x00, 0x74, 0x07, 0x8B, 0x45, 0xF8, 0x83, 0x60, 0x70, 0xFD, 0xB8, 0xFF, 0xFF, 0xFF, 0x7F, 0xEB, 0x52, 0x8B, 0x45, 0xF0, 0x83, 0x78, 0x14, 0x00, 0x75, 0x0B, 0x56, 0x53, 0xE8, 0x4D, 0xFF, 0xFF, 0xFF, 0x59, 0x59, 0xEB, 0x31, 0x2B, 0xDE, 0x57, 0x0F, 0xB6, 0x04, 0x33, 0x8D, 0x4D, 0xF0, 0x51, 0x50, 0xE8, 0x5E, 0x14, 0x00, 0x00, 0x8B, 0xF8, 0x0F, 0xB6, 0x06, 0x8D, 0x4D, 0xF0, 0x51, 0x50, 0xE8, 0x4F, 0x14, 0x00, 0x00, 0x83, 0xC4, 0x10, 0x46, 0x85, 0xFF, 0x74, 0x04, 0x3B, 0xF8, 0x74, 0xD7, 0x2B, 0xF8, 0x8B, 0xC7, 0x5F, 0x80, 0x7D, 0xFC, 0x00, 0x74, 0x07, 0x8B, 0x4D, 0xF8, 0x83, 0x61, 0x70, 0xFD, 0x5E, 0x5B, 0xC9, 0xC3, 0x8B, 0xFF, 0x55, 0x8B, 0xEC, 0x33, 0xC0, 0x39, 0x05, 0x24, 0xE1, 0x40, 0x00, 0x75, 0x27, 0x39, 0x45, 0x08, 0x75, 0x17, 0xE8, 0x05, 0x17, 0x00, 0x00, 0xC7, 0x00, 0x16, 0x00, 0x00, 0x00, 0xE8, 0xA8, 0x16, 0x00, 0x00, 0xB8, 0xFF, 0xFF, 0xFF, 0x7F, 0x5D, 0xC3, 0x39, 0x45, 0x0C, 0x74, 0xE4, 0x5D, 0xE9, 0xD1, 0xFE, 0xFF, 0xFF, 0x50, 0xFF, 0x75, 0x0C, 0xFF, 0x75, 0x08, 0xE8, 0xFE, 0xFE, 0xFF, 0xFF, 0x83, 0xC4, 0x0C, 0x5D, 0xC3, 0x8B, 0xFF, 0x55, 0x8B, 0xEC, 0x83, 0xEC, 0x10, 0x83, 0x7D, 0x10, 0x00, 0x53, 0x56, 0x57, 0x0F, 0x84, 0xC6, 0x00, 0x00, 0x00, 0xFF, 0x75, 0x14, 0x8D, 0x4D, 0xF0, 0xE8, 0x19, 0xFE, 0xFF, 0xFF, 0x8B, 0x5D, 0x08, 0x85, 0xDB, 0x75, 0x27, 0xE8, 0xAB, 0x16, 0x00, 0x00, 0xC7, 0x00, 0x16, 0x00, 0x00, 0x00, 0xE8, 0x4E, 0x16, 0x00, 0x00, 0x80, 0x7D, 0xFC, 0x00, 0x74, 0x07, 0x8B, 0x45, 0xF8, 0x83, 0x60, 0x70, 0xFD, 0xB8, 0xFF, 0xFF, 0xFF, 0x7F, 0xE9, 0x8F, 0x00, 0x00, 0x00, 0x8B, 0x75, 0x0C, 0x85, 0xF6, 0x74, 0xD2, 0xBF, 0xFF, 0xFF, 0xFF, 0x7F, 0x39, 0x7D, 0x10, 0x76, 0x21, 0xE8, 0x73, 0x16, 0x00, 0x00, 0xC7, 0x00, 0x16, 0x00, 0x00, 0x00, 0xE8, 0x16, 0x16, 0x00, 0x00, 0x80, 0x7D, 0xFC, 0x00, 0x74, 0x07, 0x8B, 0x45, 0xF8, 0x83, 0x60, 0x70, 0xFD, 0x8B, 0xC7, 0xEB, 0x5D, 0x8B, 0x45, 0xF0, 0x83, 0x78, 0x14, 0x00, 0x75, 0x1C, 0xFF, 0x75, 0x10, 0x56, 0x53, 0xE8, 0x98, 0x16, 0x00, 0x00, 0x83, 0xC4, 0x0C, 0x80, 0x7D, 0xFC, 0x00, 0x74, 0x41, 0x8B, 0x4D, 0xF8, 0x83, 0x61, 0x70, 0xFD, 0xEB, 0x38, 0x2B, 0xDE, 0x0F, 0xB6, 0x04, 0x33, 0x8D, 0x4D, 0xF0, 0x51, 0x50, 0xE8, 0x31, 0x13, 0x00, 0x00, 0x8B, 0xF8, 0x0F, 0xB6, 0x06, 0x8D, 0x4D, 0xF0, 0x51, 0x50, 0xE8, 0x22, 0x13, 0x00, 0x00, 0x83, 0xC4, 0x10, 0x46, 0xFF, 0x4D, 0x10, 0x74, 0x08, 0x85, 0xFF, 0x74, 0x04, 0x3B, 0xF8, 0x74, 0xD2, 0x2B, 0xF8, 0x8B, 0xC7, 0xEB, 0xBB,
				0x33, 0xC0, 0x5F, 0x5E, 0x5B, 0xC9, 0xC3, 0x8B, 0xFF, 0x55, 0x8B, 0xEC, 0x33, 0xC0, 0x39, 0x05, 0x24, 0xE1, 0x40, 0x00, 0x75, 0x30, 0x39, 0x45, 0x08, 0x75, 0x17, 0xE8, 0xDC, 0x15, 0x00, 0x00, 0xC7, 0x00, 0x16, 0x00, 0x00, 0x00, 0xE8, 0x7F, 0x15, 0x00, 0x00, 0xB8, 0xFF, 0xFF, 0xFF, 0x7F, 0x5D, 0xC3, 0x39, 0x45, 0x0C, 0x74, 0xE4, 0x81, 0x7D, 0x10, 0xFF, 0xFF, 0xFF, 0x7F, 0x77, 0xDB, 0x5D, 0xE9, 0x0A, 0x16, 0x00, 0x00, 0x50, 0xFF, 0x75, 0x10, 0xFF, 0x75, 0x0C, 0xFF, 0x75, 0x08, 0xE8, 0xD0, 0xFE, 0xFF, 0xFF, 0x83, 0xC4, 0x10, 0x5D, 0xC3, 0x8B, 0xFF, 0x55, 0x8B, 0xEC, 0x83, 0xEC, 0x20, 0x53, 0x57, 0x33, 0xDB, 0x6A, 0x07, 0x33, 0xC0, 0x59, 0x8D, 0x7D, 0xE4, 0x89, 0x5D, 0xE0, 0xF3, 0xAB, 0x39, 0x5D, 0x10, 0x75, 0x15, 0xE8, 0x7F, 0x15, 0x00, 0x00, 0xC7, 0x00, 0x16, 0x00, 0x00, 0x00, 0xE8, 0x22, 0x15, 0x00, 0x00, 0x83, 0xC8, 0xFF, 0xEB, 0x75, 0x8B, 0x4D, 0x0C, 0x56, 0x8B, 0x75, 0x08, 0x3B, 0xCB, 0x74, 0x19, 0x3B, 0xF3, 0x75, 0x15, 0xE8, 0x5B, 0x15, 0x00, 0x00, 0xC7, 0x00, 0x16, 0x00, 0x00, 0x00, 0xE8, 0xFE, 0x14, 0x00, 0x00, 0x83, 0xC8, 0xFF, 0xEB, 0x50, 0xB8, 0xFF, 0xFF, 0xFF, 0x7F, 0x89, 0x45, 0xE4, 0x3B, 0xC8, 0x77, 0x03, 0x89, 0x4D, 0xE4, 0x8D, 0x45, 0x14, 0x50, 0x53, 0xFF, 0x75, 0x10, 0x8D, 0x45, 0xE0, 0x50, 0xC7, 0x45, 0xEC, 0x42, 0x00, 0x00, 0x00, 0x89, 0x75, 0xE8, 0x89, 0x75, 0xE0, 0xE8, 0xCC, 0x17, 0x00, 0x00, 0x83, 0xC4, 0x10, 0x8B, 0xF8, 0x3B, 0xF3, 0x74, 0x1A, 0xFF, 0x4D, 0xE4, 0x78, 0x07, 0x8B, 0x45, 0xE0, 0x88, 0x18, 0xEB, 0x0C, 0x8D, 0x45, 0xE0, 0x50, 0x53, 0xE8, 0xB4, 0x15, 0x00, 0x00, 0x59, 0x59, 0x8B, 0xC7, 0x5E, 0x5F, 0x5B, 0xC9, 0xC3, 0x8B, 0xFF, 0x55, 0x8B, 0xEC, 0x83, 0x7D, 0x08, 0x00, 0x74, 0x2D, 0xFF, 0x75, 0x08, 0x6A, 0x00, 0xFF, 0x35, 0x28, 0xE1, 0x40, 0x00, 0xFF, 0x15, 0x38, 0xA0, 0x40, 0x00, 0x85, 0xC0, 0x75, 0x18, 0x56, 0xE8, 0xD0, 0x14, 0x00, 0x00, 0x8B, 0xF0, 0xFF, 0x15, 0x34, 0xA0, 0x40, 0x00, 0x50, 0xE8, 0x80, 0x14, 0x00, 0x00, 0x59, 0x89, 0x06, 0x5E, 0x5D, 0xC3, 0x8B, 0xFF, 0x55, 0x8B, 0xEC, 0x53, 0x8B, 0x5D, 0x08, 0x83, 0xFB, 0xE0, 0x77, 0x6F, 0x56, 0x57, 0x83, 0x3D, 0x28, 0xE1, 0x40, 0x00, 0x00, 0x75, 0x18, 0xE8, 0x32, 0x28, 0x00, 0x00, 0x6A, 0x1E, 0xE8, 0x7C, 0x26, 0x00, 0x00, 0x68, 0xFF, 0x00, 0x00, 0x00, 0xE8, 0x8C, 0x23, 0x00, 0x00, 0x59, 0x59, 0x85, 0xDB, 0x74, 0x04, 0x8B, 0xC3, 0xEB, 0x03, 0x33, 0xC0, 0x40, 0x50, 0x6A, 0x00, 0xFF, 0x35, 0x28, 0xE1, 0x40, 0x00, 0xFF, 0x15, 0x3C, 0xA0, 0x40, 0x00, 0x8B, 0xF8, 0x85, 0xFF, 0x75, 0x26, 0x6A, 0x0C, 0x5E, 0x39, 0x05, 0x8C, 0xE7, 0x40, 0x00, 0x74, 0x0D, 0x53, 0xE8, 0x36, 0x28, 0x00, 0x00, 0x59, 0x85, 0xC0, 0x75, 0xA9, 0xEB, 0x07, 0xE8, 0x4E, 0x14, 0x00, 0x00, 0x89, 0x30, 0xE8, 0x47, 0x14, 0x00, 0x00, 0x89, 0x30, 0x8B, 0xC7, 0x5F, 0x5E, 0xEB, 0x14, 0x53, 0xE8, 0x15, 0x28, 0x00, 0x00, 0x59, 0xE8, 0x33, 0x14, 0x00, 0x00, 0xC7, 0x00, 0x0C, 0x00, 0x00, 0x00, 0x33, 0xC0, 0x5B, 0x5D, 0xC3, 0x8B, 0xFF, 0x55, 0x8B, 0xEC, 0x83, 0x3D, 0xC8, 0xDD, 0x40, 0x00, 0x01, 0x75, 0x05, 0xE8, 0xA9, 0x27, 0x00, 0x00, 0xFF, 0x75, 0x08, 0xE8, 0xF2, 0x25, 0x00, 0x00, 0x68, 0xFF, 0x00, 0x00, 0x00,
				0xE8, 0x02, 0x23, 0x00, 0x00, 0x59, 0x59, 0x5D, 0xC3, 0x6A, 0x58, 0x68, 0xE0, 0xC0, 0x40, 0x00, 0xE8, 0x57, 0x30, 0x00, 0x00, 0x8D, 0x45, 0x98, 0x50, 0xFF, 0x15, 0x48, 0xA0, 0x40, 0x00, 0x33, 0xF6, 0x39, 0x35, 0x9C, 0xFB, 0x40, 0x00, 0x75, 0x0B, 0x56, 0x56, 0x6A, 0x01, 0x56, 0xFF, 0x15, 0x44, 0xA0, 0x40, 0x00, 0xB8, 0x4D, 0x5A, 0x00, 0x00, 0x66, 0x39, 0x05, 0x00, 0x00, 0x40, 0x00, 0x74, 0x05, 0x89, 0x75, 0xE4, 0xEB, 0x36, 0xA1, 0x3C, 0x00, 0x40, 0x00, 0x81, 0xB8, 0x00, 0x00, 0x40, 0x00, 0x50, 0x45, 0x00, 0x00, 0x75, 0xEA, 0xB9, 0x0B, 0x01, 0x00, 0x00, 0x66, 0x39, 0x88, 0x18, 0x00, 0x40, 0x00, 0x75, 0xDC, 0x83, 0xB8, 0x74, 0x00, 0x40, 0x00, 0x0E, 0x76, 0xD3, 0x33, 0xC9, 0x39, 0xB0, 0xE8, 0x00, 0x40, 0x00, 0x0F, 0x95, 0xC1, 0x89, 0x4D, 0xE4, 0xE8, 0x3C, 0x22, 0x00, 0x00, 0x85, 0xC0, 0x75, 0x08, 0x6A, 0x1C, 0xE8, 0x53, 0xFF, 0xFF, 0xFF, 0x59, 0xE8, 0x09, 0x0F, 0x00, 0x00, 0x85, 0xC0, 0x75, 0x08, 0x6A, 0x10, 0xE8, 0x42, 0xFF, 0xFF, 0xFF, 0x59, 0xE8, 0x71, 0x2F, 0x00, 0x00, 0x89, 0x75, 0xFC, 0xE8, 0x24, 0x2D, 0x00, 0x00, 0x85, 0xC0, 0x79, 0x08, 0x6A, 0x1B, 0xE8, 0xF2, 0x24, 0x00, 0x00, 0x59, 0xFF, 0x15, 0x40, 0xA0, 0x40, 0x00, 0xA3, 0x98, 0xFB, 0x40, 0x00, 0xE8, 0x71, 0x2C, 0x00, 0x00, 0xA3, 0xC0, 0xDD, 0x40, 0x00, 0xE8, 0xAC, 0x2B, 0x00, 0x00, 0x85, 0xC0, 0x79, 0x08, 0x6A, 0x08, 0xE8, 0xCC, 0x24, 0x00, 0x00, 0x59, 0xE8, 0x25, 0x29, 0x00, 0x00, 0x85, 0xC0, 0x79, 0x08, 0x6A, 0x09, 0xE8, 0xBB, 0x24, 0x00, 0x00, 0x59, 0x6A, 0x01, 0xE8, 0x92, 0x22, 0x00, 0x00, 0x59, 0x3B, 0xC6, 0x74, 0x07, 0x50, 0xE8, 0xA8, 0x24, 0x00, 0x00, 0x59, 0xE8, 0x9F, 0x28, 0x00, 0x00, 0xF6, 0x45, 0xC4, 0x01, 0x74, 0x06, 0x0F, 0xB7, 0x4D, 0xC8, 0xEB, 0x03, 0x6A, 0x0A, 0x59, 0x51, 0x50, 0x56, 0x68, 0x00, 0x00, 0x40, 0x00, 0xE8, 0xE9, 0xF5, 0xFF, 0xFF, 0x89, 0x45, 0xE0, 0x39, 0x75, 0xE4, 0x75, 0x06, 0x50, 0xE8, 0x2E, 0x24, 0x00, 0x00, 0xE8, 0x55, 0x24, 0x00, 0x00, 0xEB, 0x2E, 0x8B, 0x45, 0xEC, 0x8B, 0x08, 0x8B, 0x09, 0x89, 0x4D, 0xDC, 0x50, 0x51, 0xE8, 0x13, 0x27, 0x00, 0x00, 0x59, 0x59, 0xC3, 0x8B, 0x65, 0xE8, 0x8B, 0x45, 0xDC, 0x89, 0x45, 0xE0, 0x83, 0x7D, 0xE4, 0x00, 0x75, 0x06, 0x50, 0xE8, 0x14, 0x24, 0x00, 0x00, 0xE8, 0x34, 0x24, 0x00, 0x00, 0xC7, 0x45, 0xFC, 0xFE, 0xFF, 0xFF, 0xFF, 0x8B, 0x45, 0xE0, 0xE8, 0x3C, 0x2F, 0x00, 0x00, 0xC3, 0xE8, 0xE0, 0x30, 0x00, 0x00, 0xE9, 0x89, 0xFE, 0xFF, 0xFF, 0x8B, 0xFF, 0x55, 0x8B, 0xEC, 0x81, 0xEC, 0x28, 0x03, 0x00, 0x00, 0xA3, 0xD8, 0xDE, 0x40, 0x00, 0x89, 0x0D, 0xD4, 0xDE, 0x40, 0x00, 0x89, 0x15, 0xD0, 0xDE, 0x40, 0x00, 0x89, 0x1D, 0xCC, 0xDE, 0x40, 0x00, 0x89, 0x35, 0xC8, 0xDE, 0x40, 0x00, 0x89, 0x3D, 0xC4, 0xDE, 0x40, 0x00, 0x66, 0x8C, 0x15, 0xF0, 0xDE, 0x40, 0x00, 0x66, 0x8C, 0x0D, 0xE4, 0xDE, 0x40, 0x00, 0x66, 0x8C, 0x1D, 0xC0, 0xDE, 0x40, 0x00, 0x66, 0x8C, 0x05, 0xBC, 0xDE, 0x40, 0x00, 0x66, 0x8C, 0x25, 0xB8, 0xDE, 0x40, 0x00, 0x66, 0x8C, 0x2D, 0xB4, 0xDE, 0x40, 0x00, 0x9C, 0x8F, 0x05, 0xE8, 0xDE, 0x40, 0x00, 0x8B, 0x45, 0x00, 0xA3, 0xDC, 0xDE, 0x40, 0x00, 0x8B, 0x45, 0x04, 0xA3, 0xE0, 0xDE, 0x40, 0x00, 0x8D, 0x45, 0x08, 0xA3, 0xEC,
				0xDE, 0x40, 0x00, 0x8B, 0x85, 0xE0, 0xFC, 0xFF, 0xFF, 0xC7, 0x05, 0x28, 0xDE, 0x40, 0x00, 0x01, 0x00, 0x01, 0x00, 0xA1, 0xE0, 0xDE, 0x40, 0x00, 0xA3, 0xDC, 0xDD, 0x40, 0x00, 0xC7, 0x05, 0xD0, 0xDD, 0x40, 0x00, 0x09, 0x04, 0x00, 0xC0, 0xC7, 0x05, 0xD4, 0xDD, 0x40, 0x00, 0x01, 0x00, 0x00, 0x00, 0xA1, 0x04, 0xD0, 0x40, 0x00, 0x89, 0x85, 0xD8, 0xFC, 0xFF, 0xFF, 0xA1, 0x08, 0xD0, 0x40, 0x00, 0x89, 0x85, 0xDC, 0xFC, 0xFF, 0xFF, 0xFF, 0x15, 0x5C, 0xA0, 0x40, 0x00, 0xA3, 0x20, 0xDE, 0x40, 0x00, 0x6A, 0x01, 0xE8, 0xA9, 0x30, 0x00, 0x00, 0x59, 0x6A, 0x00, 0xFF, 0x15, 0x58, 0xA0, 0x40, 0x00, 0x68, 0x70, 0xA1, 0x40, 0x00, 0xFF, 0x15, 0x54, 0xA0, 0x40, 0x00, 0x83, 0x3D, 0x20, 0xDE, 0x40, 0x00, 0x00, 0x75, 0x08, 0x6A, 0x01, 0xE8, 0x85, 0x30, 0x00, 0x00, 0x59, 0x68, 0x09, 0x04, 0x00, 0xC0, 0xFF, 0x15, 0x50, 0xA0, 0x40, 0x00, 0x50, 0xFF, 0x15, 0x4C, 0xA0, 0x40, 0x00, 0xC9, 0xC3, 0x2D, 0xA4, 0x03, 0x00, 0x00, 0x74, 0x22, 0x83, 0xE8, 0x04, 0x74, 0x17, 0x83, 0xE8, 0x0D, 0x74, 0x0C, 0x48, 0x74, 0x03, 0x33, 0xC0, 0xC3, 0xB8, 0x04, 0x04, 0x00, 0x00, 0xC3, 0xB8, 0x12, 0x04, 0x00, 0x00, 0xC3, 0xB8, 0x04, 0x08, 0x00, 0x00, 0xC3, 0xB8, 0x11, 0x04, 0x00, 0x00, 0xC3, 0x8B, 0xFF, 0x56, 0x57, 0x8B, 0xF0, 0x68, 0x01, 0x01, 0x00, 0x00, 0x33, 0xFF, 0x8D, 0x46, 0x1C, 0x57, 0x50, 0xE8, 0x40, 0x30, 0x00, 0x00, 0x33, 0xC0, 0x0F, 0xB7, 0xC8, 0x8B, 0xC1, 0x89, 0x7E, 0x04, 0x89, 0x7E, 0x08, 0x89, 0x7E, 0x0C, 0xC1, 0xE1, 0x10, 0x0B, 0xC1, 0x8D, 0x7E, 0x10, 0xAB, 0xAB, 0xAB, 0xB9, 0x10, 0xD0, 0x40, 0x00, 0x83, 0xC4, 0x0C, 0x8D, 0x46, 0x1C, 0x2B, 0xCE, 0xBF, 0x01, 0x01, 0x00, 0x00, 0x8A, 0x14, 0x01, 0x88, 0x10, 0x40, 0x4F, 0x75, 0xF7, 0x8D, 0x86, 0x1D, 0x01, 0x00, 0x00, 0xBE, 0x00, 0x01, 0x00, 0x00, 0x8A, 0x14, 0x08, 0x88, 0x10, 0x40, 0x4E, 0x75, 0xF7, 0x5F, 0x5E, 0xC3, 0x8B, 0xFF, 0x55, 0x8B, 0xEC, 0x81, 0xEC, 0x1C, 0x05, 0x00, 0x00, 0xA1, 0x04, 0xD0, 0x40, 0x00, 0x33, 0xC5, 0x89, 0x45, 0xFC, 0x53, 0x57, 0x8D, 0x85, 0xE8, 0xFA, 0xFF, 0xFF, 0x50, 0xFF, 0x76, 0x04, 0xFF, 0x15, 0x60, 0xA0, 0x40, 0x00, 0xBF, 0x00, 0x01, 0x00, 0x00, 0x85, 0xC0, 0x0F, 0x84, 0xFC, 0x00, 0x00, 0x00, 0x33, 0xC0, 0x88, 0x84, 0x05, 0xFC, 0xFE, 0xFF, 0xFF, 0x40, 0x3B, 0xC7, 0x72, 0xF4, 0x8A, 0x85, 0xEE, 0xFA, 0xFF, 0xFF, 0xC6, 0x85, 0xFC, 0xFE, 0xFF, 0xFF, 0x20, 0x84, 0xC0, 0x74, 0x30, 0x8D, 0x9D, 0xEF, 0xFA, 0xFF, 0xFF, 0x0F, 0xB6, 0xC8, 0x0F, 0xB6, 0x03, 0x3B, 0xC8, 0x77, 0x16, 0x2B, 0xC1, 0x40, 0x50, 0x8D, 0x94, 0x0D, 0xFC, 0xFE, 0xFF, 0xFF, 0x6A, 0x20, 0x52, 0xE8, 0x7D, 0x2F, 0x00, 0x00, 0x83, 0xC4, 0x0C, 0x8A, 0x43, 0x01, 0x83, 0xC3, 0x02, 0x84, 0xC0, 0x75, 0xD6, 0x6A, 0x00, 0xFF, 0x76, 0x0C, 0x8D, 0x85, 0xFC, 0xFA, 0xFF, 0xFF, 0xFF, 0x76, 0x04, 0x50, 0x57, 0x8D, 0x85, 0xFC, 0xFE, 0xFF, 0xFF, 0x50, 0x6A, 0x01, 0x6A, 0x00, 0xE8, 0xFE, 0x32, 0x00, 0x00, 0x33, 0xDB, 0x53, 0xFF, 0x76, 0x04, 0x8D, 0x85, 0xFC, 0xFD, 0xFF, 0xFF, 0x57, 0x50, 0x57, 0x8D, 0x85, 0xFC, 0xFE, 0xFF, 0xFF, 0x50, 0x57, 0xFF, 0x76, 0x0C, 0x53, 0xE8, 0xB1, 0x31, 0x00, 0x00, 0x83, 0xC4, 0x44, 0x53, 0xFF, 0x76, 0x04, 0x8D, 0x85, 0xFC, 0xFC, 0xFF,
				0xFF, 0x57, 0x50, 0x57, 0x8D, 0x85, 0xFC, 0xFE, 0xFF, 0xFF, 0x50, 0x68, 0x00, 0x02, 0x00, 0x00, 0xFF, 0x76, 0x0C, 0x53, 0xE8, 0x8C, 0x31, 0x00, 0x00, 0x83, 0xC4, 0x24, 0x33, 0xC0, 0x0F, 0xB7, 0x8C, 0x45, 0xFC, 0xFA, 0xFF, 0xFF, 0xF6, 0xC1, 0x01, 0x74, 0x0E, 0x80, 0x4C, 0x06, 0x1D, 0x10, 0x8A, 0x8C, 0x05, 0xFC, 0xFD, 0xFF, 0xFF, 0xEB, 0x11, 0xF6, 0xC1, 0x02, 0x74, 0x15, 0x80, 0x4C, 0x06, 0x1D, 0x20, 0x8A, 0x8C, 0x05, 0xFC, 0xFC, 0xFF, 0xFF, 0x88, 0x8C, 0x06, 0x1D, 0x01, 0x00, 0x00, 0xEB, 0x07, 0x88, 0x9C, 0x06, 0x1D, 0x01, 0x00, 0x00, 0x40, 0x3B, 0xC7, 0x72, 0xBF, 0xEB, 0x52, 0x8D, 0x86, 0x1D, 0x01, 0x00, 0x00, 0xC7, 0x85, 0xE4, 0xFA, 0xFF, 0xFF, 0x9F, 0xFF, 0xFF, 0xFF, 0x33, 0xC9, 0x29, 0x85, 0xE4, 0xFA, 0xFF, 0xFF, 0x8B, 0x95, 0xE4, 0xFA, 0xFF, 0xFF, 0x8D, 0x84, 0x0E, 0x1D, 0x01, 0x00, 0x00, 0x03, 0xD0, 0x8D, 0x5A, 0x20, 0x83, 0xFB, 0x19, 0x77, 0x0A, 0x80, 0x4C, 0x0E, 0x1D, 0x10, 0x8D, 0x51, 0x20, 0xEB, 0x0D, 0x83, 0xFA, 0x19, 0x77, 0x0C, 0x80, 0x4C, 0x0E, 0x1D, 0x20, 0x8D, 0x51, 0xE0, 0x88, 0x10, 0xEB, 0x03, 0xC6, 0x00, 0x00, 0x41, 0x3B, 0xCF, 0x72, 0xC6, 0x8B, 0x4D, 0xFC, 0x5F, 0x33, 0xCD, 0x5B, 0xE8, 0xB4, 0xF6, 0xFF, 0xFF, 0xC9, 0xC3, 0x6A, 0x0C, 0x68, 0x00, 0xC1, 0x40, 0x00, 0xE8, 0xB7, 0x2B, 0x00, 0x00, 0xE8, 0x99, 0x09, 0x00, 0x00, 0x8B, 0xF8, 0xA1, 0x30, 0xD5, 0x40, 0x00, 0x85, 0x47, 0x70, 0x74, 0x1D, 0x83, 0x7F, 0x6C, 0x00, 0x74, 0x17, 0x8B, 0x77, 0x68, 0x85, 0xF6, 0x75, 0x08, 0x6A, 0x20, 0xE8, 0xCF, 0x20, 0x00, 0x00, 0x59, 0x8B, 0xC6, 0xE8, 0xCF, 0x2B, 0x00, 0x00, 0xC3, 0x6A, 0x0D, 0xE8, 0x8A, 0x33, 0x00, 0x00, 0x59, 0x83, 0x65, 0xFC, 0x00, 0x8B, 0x77, 0x68, 0x89, 0x75, 0xE4, 0x3B, 0x35, 0x38, 0xD4, 0x40, 0x00, 0x74, 0x36, 0x85, 0xF6, 0x74, 0x1A, 0x56, 0xFF, 0x15, 0x68, 0xA0, 0x40, 0x00, 0x85, 0xC0, 0x75, 0x0F, 0x81, 0xFE, 0x10, 0xD0, 0x40, 0x00, 0x74, 0x07, 0x56, 0xE8, 0xF8, 0xF9, 0xFF, 0xFF, 0x59, 0xA1, 0x38, 0xD4, 0x40, 0x00, 0x89, 0x47, 0x68, 0x8B, 0x35, 0x38, 0xD4, 0x40, 0x00, 0x89, 0x75, 0xE4, 0x56, 0xFF, 0x15, 0x64, 0xA0, 0x40, 0x00, 0xC7, 0x45, 0xFC, 0xFE, 0xFF, 0xFF, 0xFF, 0xE8, 0x05, 0x00, 0x00, 0x00, 0xEB, 0x8E, 0x8B, 0x75, 0xE4, 0x6A, 0x0D, 0xE8, 0x50, 0x32, 0x00, 0x00, 0x59, 0xC3, 0x8B, 0xFF, 0x55, 0x8B, 0xEC, 0x83, 0xEC, 0x10, 0x53, 0x33, 0xDB, 0x53, 0x8D, 0x4D, 0xF0, 0xE8, 0x09, 0xF6, 0xFF, 0xFF, 0x89, 0x1D, 0xF4, 0xE0, 0x40, 0x00, 0x83, 0xFE, 0xFE, 0x75, 0x1E, 0xC7, 0x05, 0xF4, 0xE0, 0x40, 0x00, 0x01, 0x00, 0x00, 0x00, 0xFF, 0x15, 0x70, 0xA0, 0x40, 0x00, 0x38, 0x5D, 0xFC, 0x74, 0x45, 0x8B, 0x4D, 0xF8, 0x83, 0x61, 0x70, 0xFD, 0xEB, 0x3C, 0x83, 0xFE, 0xFD, 0x75, 0x12, 0xC7, 0x05, 0xF4, 0xE0, 0x40, 0x00, 0x01, 0x00, 0x00, 0x00, 0xFF, 0x15, 0x6C, 0xA0, 0x40, 0x00, 0xEB, 0xDB, 0x83, 0xFE, 0xFC, 0x75, 0x12, 0x8B, 0x45, 0xF0, 0x8B, 0x40, 0x04, 0xC7, 0x05, 0xF4, 0xE0, 0x40, 0x00, 0x01, 0x00, 0x00, 0x00, 0xEB, 0xC4, 0x38, 0x5D, 0xFC, 0x74, 0x07, 0x8B, 0x45, 0xF8, 0x83, 0x60, 0x70, 0xFD, 0x8B, 0xC6, 0x5B, 0xC9, 0xC3, 0x8B, 0xFF, 0x55, 0x8B, 0xEC, 0x83, 0xEC, 0x20, 0xA1, 0x04, 0xD0, 0x40, 0x00, 0x33, 0xC5, 0x89, 0x45, 0xFC, 0x53,
				0x8B, 0x5D, 0x0C, 0x56, 0x8B, 0x75, 0x08, 0x57, 0xE8, 0x64, 0xFF, 0xFF, 0xFF, 0x8B, 0xF8, 0x33, 0xF6, 0x89, 0x7D, 0x08, 0x3B, 0xFE, 0x75, 0x0E, 0x8B, 0xC3, 0xE8, 0xBA, 0xFC, 0xFF, 0xFF, 0x33, 0xC0, 0xE9, 0xA1, 0x01, 0x00, 0x00, 0x89, 0x75, 0xE4, 0x33, 0xC0, 0x39, 0xB8, 0x40, 0xD4, 0x40, 0x00, 0x0F, 0x84, 0x91, 0x00, 0x00, 0x00, 0xFF, 0x45, 0xE4, 0x83, 0xC0, 0x30, 0x3D, 0xF0, 0x00, 0x00, 0x00, 0x72, 0xE7, 0x81, 0xFF, 0xE8, 0xFD, 0x00, 0x00, 0x0F, 0x84, 0x74, 0x01, 0x00, 0x00, 0x81, 0xFF, 0xE9, 0xFD, 0x00, 0x00, 0x0F, 0x84, 0x68, 0x01, 0x00, 0x00, 0x0F, 0xB7, 0xC7, 0x50, 0xFF, 0x15, 0x74, 0xA0, 0x40, 0x00, 0x85, 0xC0, 0x0F, 0x84, 0x56, 0x01, 0x00, 0x00, 0x8D, 0x45, 0xE8, 0x50, 0x57, 0xFF, 0x15, 0x60, 0xA0, 0x40, 0x00, 0x85, 0xC0, 0x0F, 0x84, 0x37, 0x01, 0x00, 0x00, 0x68, 0x01, 0x01, 0x00, 0x00, 0x8D, 0x43, 0x1C, 0x56, 0x50, 0xE8, 0xA0, 0x2C, 0x00, 0x00, 0x33, 0xD2, 0x42, 0x83, 0xC4, 0x0C, 0x89, 0x7B, 0x04, 0x89, 0x73, 0x0C, 0x39, 0x55, 0xE8, 0x0F, 0x86, 0xFC, 0x00, 0x00, 0x00, 0x80, 0x7D, 0xEE, 0x00, 0x0F, 0x84, 0xD3, 0x00, 0x00, 0x00, 0x8D, 0x75, 0xEF, 0x8A, 0x0E, 0x84, 0xC9, 0x0F, 0x84, 0xC6, 0x00, 0x00, 0x00, 0x0F, 0xB6, 0x46, 0xFF, 0x0F, 0xB6, 0xC9, 0xE9, 0xA9, 0x00, 0x00, 0x00, 0x68, 0x01, 0x01, 0x00, 0x00, 0x8D, 0x43, 0x1C, 0x56, 0x50, 0xE8, 0x59, 0x2C, 0x00, 0x00, 0x8B, 0x4D, 0xE4, 0x83, 0xC4, 0x0C, 0x6B, 0xC9, 0x30, 0x89, 0x75, 0xE0, 0x8D, 0xB1, 0x50, 0xD4, 0x40, 0x00, 0x89, 0x75, 0xE4, 0xEB, 0x2B, 0x8A, 0x46, 0x01, 0x84, 0xC0, 0x74, 0x29, 0x0F, 0xB6, 0x3E, 0x0F, 0xB6, 0xC0, 0xEB, 0x12, 0x8B, 0x45, 0xE0, 0x8A, 0x80, 0x3C, 0xD4, 0x40, 0x00, 0x08, 0x44, 0x3B, 0x1D, 0x0F, 0xB6, 0x46, 0x01, 0x47, 0x3B, 0xF8, 0x76, 0xEA, 0x8B, 0x7D, 0x08, 0x83, 0xC6, 0x02, 0x80, 0x3E, 0x00, 0x75, 0xD0, 0x8B, 0x75, 0xE4, 0xFF, 0x45, 0xE0, 0x83, 0xC6, 0x08, 0x83, 0x7D, 0xE0, 0x04, 0x89, 0x75, 0xE4, 0x72, 0xE9, 0x8B, 0xC7, 0x89, 0x7B, 0x04, 0xC7, 0x43, 0x08, 0x01, 0x00, 0x00, 0x00, 0xE8, 0x69, 0xFB, 0xFF, 0xFF, 0x6A, 0x06, 0x89, 0x43, 0x0C, 0x8D, 0x43, 0x10, 0x8D, 0x89, 0x44, 0xD4, 0x40, 0x00, 0x5A, 0x66, 0x8B, 0x31, 0x66, 0x89, 0x30, 0x83, 0xC1, 0x02, 0x83, 0xC0, 0x02, 0x4A, 0x75, 0xF1, 0x8B, 0xF3, 0xE8, 0xD7, 0xFB, 0xFF, 0xFF, 0xE9, 0xB4, 0xFE, 0xFF, 0xFF, 0x80, 0x4C, 0x03, 0x1D, 0x04, 0x40, 0x3B, 0xC1, 0x76, 0xF6, 0x83, 0xC6, 0x02, 0x80, 0x7E, 0xFF, 0x00, 0x0F, 0x85, 0x30, 0xFF, 0xFF, 0xFF, 0x8D, 0x43, 0x1E, 0xB9, 0xFE, 0x00, 0x00, 0x00, 0x80, 0x08, 0x08, 0x40, 0x49, 0x75, 0xF9, 0x8B, 0x43, 0x04, 0xE8, 0x11, 0xFB, 0xFF, 0xFF, 0x89, 0x43, 0x0C, 0x89, 0x53, 0x08, 0xEB, 0x03, 0x89, 0x73, 0x08, 0x33, 0xC0, 0x0F, 0xB7, 0xC8, 0x8B, 0xC1, 0xC1, 0xE1, 0x10, 0x0B, 0xC1, 0x8D, 0x7B, 0x10, 0xAB, 0xAB, 0xAB, 0xEB, 0xA7, 0x39, 0x35, 0xF4, 0xE0, 0x40, 0x00, 0x0F, 0x85, 0x54, 0xFE, 0xFF, 0xFF, 0x83, 0xC8, 0xFF, 0x8B, 0x4D, 0xFC, 0x5F, 0x5E, 0x33, 0xCD, 0x5B, 0xE8, 0xAB, 0xF3, 0xFF, 0xFF, 0xC9, 0xC3, 0x6A, 0x14, 0x68, 0x20, 0xC1, 0x40, 0x00, 0xE8, 0xAE, 0x28, 0x00, 0x00, 0x83, 0x4D, 0xE0, 0xFF, 0xE8, 0x8C, 0x06, 0x00, 0x00, 0x8B, 0xF8, 0x89, 0x7D, 0xDC, 0xE8, 0xD8, 0xFC, 0xFF,
				0xFF, 0x8B, 0x5F, 0x68, 0x8B, 0x75, 0x08, 0xE8, 0x71, 0xFD, 0xFF, 0xFF, 0x89, 0x45, 0x08, 0x3B, 0x43, 0x04, 0x0F, 0x84, 0x57, 0x01, 0x00, 0x00, 0x68, 0x20, 0x02, 0x00, 0x00, 0xE8, 0xB5, 0x30, 0x00, 0x00, 0x59, 0x8B, 0xD8, 0x85, 0xDB, 0x0F, 0x84, 0x46, 0x01, 0x00, 0x00, 0xB9, 0x88, 0x00, 0x00, 0x00, 0x8B, 0x77, 0x68, 0x8B, 0xFB, 0xF3, 0xA5, 0x83, 0x23, 0x00, 0x53, 0xFF, 0x75, 0x08, 0xE8, 0xB4, 0xFD, 0xFF, 0xFF, 0x59, 0x59, 0x89, 0x45, 0xE0, 0x85, 0xC0, 0x0F, 0x85, 0xFC, 0x00, 0x00, 0x00, 0x8B, 0x75, 0xDC, 0xFF, 0x76, 0x68, 0xFF, 0x15, 0x68, 0xA0, 0x40, 0x00, 0x85, 0xC0, 0x75, 0x11, 0x8B, 0x46, 0x68, 0x3D, 0x10, 0xD0, 0x40, 0x00, 0x74, 0x07, 0x50, 0xE8, 0xD0, 0xF6, 0xFF, 0xFF, 0x59, 0x89, 0x5E, 0x68, 0x53, 0x8B, 0x3D, 0x64, 0xA0, 0x40, 0x00, 0xFF, 0xD7, 0xF6, 0x46, 0x70, 0x02, 0x0F, 0x85, 0xEA, 0x00, 0x00, 0x00, 0xF6, 0x05, 0x30, 0xD5, 0x40, 0x00, 0x01, 0x0F, 0x85, 0xDD, 0x00, 0x00, 0x00, 0x6A, 0x0D, 0xE8, 0x07, 0x30, 0x00, 0x00, 0x59, 0x83, 0x65, 0xFC, 0x00, 0x8B, 0x43, 0x04, 0xA3, 0x04, 0xE1, 0x40, 0x00, 0x8B, 0x43, 0x08, 0xA3, 0x08, 0xE1, 0x40, 0x00, 0x8B, 0x43, 0x0C, 0xA3, 0x0C, 0xE1, 0x40, 0x00, 0x33, 0xC0, 0x89, 0x45, 0xE4, 0x83, 0xF8, 0x05, 0x7D, 0x10, 0x66, 0x8B, 0x4C, 0x43, 0x10, 0x66, 0x89, 0x0C, 0x45, 0xF8, 0xE0, 0x40, 0x00, 0x40, 0xEB, 0xE8, 0x33, 0xC0, 0x89, 0x45, 0xE4, 0x3D, 0x01, 0x01, 0x00, 0x00, 0x7D, 0x0D, 0x8A, 0x4C, 0x18, 0x1C, 0x88, 0x88, 0x30, 0xD2, 0x40, 0x00, 0x40, 0xEB, 0xE9, 0x33, 0xC0, 0x89, 0x45, 0xE4, 0x3D, 0x00, 0x01, 0x00, 0x00, 0x7D, 0x10, 0x8A, 0x8C, 0x18, 0x1D, 0x01, 0x00, 0x00, 0x88, 0x88, 0x38, 0xD3, 0x40, 0x00, 0x40, 0xEB, 0xE6, 0xFF, 0x35, 0x38, 0xD4, 0x40, 0x00, 0xFF, 0x15, 0x68, 0xA0, 0x40, 0x00, 0x85, 0xC0, 0x75, 0x13, 0xA1, 0x38, 0xD4, 0x40, 0x00, 0x3D, 0x10, 0xD0, 0x40, 0x00, 0x74, 0x07, 0x50, 0xE8, 0x17, 0xF6, 0xFF, 0xFF, 0x59, 0x89, 0x1D, 0x38, 0xD4, 0x40, 0x00, 0x53, 0xFF, 0xD7, 0xC7, 0x45, 0xFC, 0xFE, 0xFF, 0xFF, 0xFF, 0xE8, 0x02, 0x00, 0x00, 0x00, 0xEB, 0x30, 0x6A, 0x0D, 0xE8, 0x81, 0x2E, 0x00, 0x00, 0x59, 0xC3, 0xEB, 0x25, 0x83, 0xF8, 0xFF, 0x75, 0x20, 0x81, 0xFB, 0x10, 0xD0, 0x40, 0x00, 0x74, 0x07, 0x53, 0xE8, 0xE1, 0xF5, 0xFF, 0xFF, 0x59, 0xE8, 0xD1, 0x0A, 0x00, 0x00, 0xC7, 0x00, 0x16, 0x00, 0x00, 0x00, 0xEB, 0x04, 0x83, 0x65, 0xE0, 0x00, 0x8B, 0x45, 0xE0, 0xE8, 0x66, 0x27, 0x00, 0x00, 0xC3, 0x83, 0x3D, 0x8C, 0xFB, 0x40, 0x00, 0x00, 0x75, 0x12, 0x6A, 0xFD, 0xE8, 0x56, 0xFE, 0xFF, 0xFF, 0x59, 0xC7, 0x05, 0x8C, 0xFB, 0x40, 0x00, 0x01, 0x00, 0x00, 0x00, 0x33, 0xC0, 0xC3, 0x8B, 0xFF, 0x55, 0x8B, 0xEC, 0x53, 0x56, 0x8B, 0x35, 0x64, 0xA0, 0x40, 0x00, 0x57, 0x8B, 0x7D, 0x08, 0x57, 0xFF, 0xD6, 0x8B, 0x87, 0xB0, 0x00, 0x00, 0x00, 0x85, 0xC0, 0x74, 0x03, 0x50, 0xFF, 0xD6, 0x8B, 0x87, 0xB8, 0x00, 0x00, 0x00, 0x85, 0xC0, 0x74, 0x03, 0x50, 0xFF, 0xD6, 0x8B, 0x87, 0xB4, 0x00, 0x00, 0x00, 0x85, 0xC0, 0x74, 0x03, 0x50, 0xFF, 0xD6, 0x8B, 0x87, 0xC0, 0x00, 0x00, 0x00, 0x85, 0xC0, 0x74, 0x03, 0x50, 0xFF, 0xD6, 0x8D, 0x5F, 0x50, 0xC7, 0x45, 0x08, 0x06, 0x00, 0x00, 0x00, 0x81, 0x7B, 0xF8, 0x34, 0xD5, 0x40, 0x00, 0x74,
				0x09, 0x8B, 0x03, 0x85, 0xC0, 0x74, 0x03, 0x50, 0xFF, 0xD6, 0x83, 0x7B, 0xFC, 0x00, 0x74, 0x0A, 0x8B, 0x43, 0x04, 0x85, 0xC0, 0x74, 0x03, 0x50, 0xFF, 0xD6, 0x83, 0xC3, 0x10, 0xFF, 0x4D, 0x08, 0x75, 0xD6, 0x8B, 0x87, 0xD4, 0x00, 0x00, 0x00, 0x05, 0xB4, 0x00, 0x00, 0x00, 0x50, 0xFF, 0xD6, 0x5F, 0x5E, 0x5B, 0x5D, 0xC3, 0x8B, 0xFF, 0x55, 0x8B, 0xEC, 0x57, 0x8B, 0x7D, 0x08, 0x85, 0xFF, 0x0F, 0x84, 0x83, 0x00, 0x00, 0x00, 0x53, 0x56, 0x8B, 0x35, 0x68, 0xA0, 0x40, 0x00, 0x57, 0xFF, 0xD6, 0x8B, 0x87, 0xB0, 0x00, 0x00, 0x00, 0x85, 0xC0, 0x74, 0x03, 0x50, 0xFF, 0xD6, 0x8B, 0x87, 0xB8, 0x00, 0x00, 0x00, 0x85, 0xC0, 0x74, 0x03, 0x50, 0xFF, 0xD6, 0x8B, 0x87, 0xB4, 0x00, 0x00, 0x00, 0x85, 0xC0, 0x74, 0x03, 0x50, 0xFF, 0xD6, 0x8B, 0x87, 0xC0, 0x00, 0x00, 0x00, 0x85, 0xC0, 0x74, 0x03, 0x50, 0xFF, 0xD6, 0x8D, 0x5F, 0x50, 0xC7, 0x45, 0x08, 0x06, 0x00, 0x00, 0x00, 0x81, 0x7B, 0xF8, 0x34, 0xD5, 0x40, 0x00, 0x74, 0x09, 0x8B, 0x03, 0x85, 0xC0, 0x74, 0x03, 0x50, 0xFF, 0xD6, 0x83, 0x7B, 0xFC, 0x00, 0x74, 0x0A, 0x8B, 0x43, 0x04, 0x85, 0xC0, 0x74, 0x03, 0x50, 0xFF, 0xD6, 0x83, 0xC3, 0x10, 0xFF, 0x4D, 0x08, 0x75, 0xD6, 0x8B, 0x87, 0xD4, 0x00, 0x00, 0x00, 0x05, 0xB4, 0x00, 0x00, 0x00, 0x50, 0xFF, 0xD6, 0x5E, 0x5B, 0x8B, 0xC7, 0x5F, 0x5D, 0xC3, 0x8B, 0xFF, 0x55, 0x8B, 0xEC, 0x53, 0x56, 0x8B, 0x75, 0x08, 0x8B, 0x86, 0xBC, 0x00, 0x00, 0x00, 0x33, 0xDB, 0x57, 0x3B, 0xC3, 0x74, 0x6F, 0x3D, 0x78, 0xDA, 0x40, 0x00, 0x74, 0x68, 0x8B, 0x86, 0xB0, 0x00, 0x00, 0x00, 0x3B, 0xC3, 0x74, 0x5E, 0x39, 0x18, 0x75, 0x5A, 0x8B, 0x86, 0xB8, 0x00, 0x00, 0x00, 0x3B, 0xC3, 0x74, 0x17, 0x39, 0x18, 0x75, 0x13, 0x50, 0xE8, 0x40, 0xF4, 0xFF, 0xFF, 0xFF, 0xB6, 0xBC, 0x00, 0x00, 0x00, 0xE8, 0x89, 0x32, 0x00, 0x00, 0x59, 0x59, 0x8B, 0x86, 0xB4, 0x00, 0x00, 0x00, 0x3B, 0xC3, 0x74, 0x17, 0x39, 0x18, 0x75, 0x13, 0x50, 0xE8, 0x1F, 0xF4, 0xFF, 0xFF, 0xFF, 0xB6, 0xBC, 0x00, 0x00, 0x00, 0xE8, 0xFF, 0x31, 0x00, 0x00, 0x59, 0x59, 0xFF, 0xB6, 0xB0, 0x00, 0x00, 0x00, 0xE8, 0x07, 0xF4, 0xFF, 0xFF, 0xFF, 0xB6, 0xBC, 0x00, 0x00, 0x00, 0xE8, 0xFC, 0xF3, 0xFF, 0xFF, 0x59, 0x59, 0x8B, 0x86, 0xC0, 0x00, 0x00, 0x00, 0x3B, 0xC3, 0x74, 0x44, 0x39, 0x18, 0x75, 0x40, 0x8B, 0x86, 0xC4, 0x00, 0x00, 0x00, 0x2D, 0xFE, 0x00, 0x00, 0x00, 0x50, 0xE8, 0xDB, 0xF3, 0xFF, 0xFF, 0x8B, 0x86, 0xCC, 0x00, 0x00, 0x00, 0xBF, 0x80, 0x00, 0x00, 0x00, 0x2B, 0xC7, 0x50, 0xE8, 0xC8, 0xF3, 0xFF, 0xFF, 0x8B, 0x86, 0xD0, 0x00, 0x00, 0x00, 0x2B, 0xC7, 0x50, 0xE8, 0xBA, 0xF3, 0xFF, 0xFF, 0xFF, 0xB6, 0xC0, 0x00, 0x00, 0x00, 0xE8, 0xAF, 0xF3, 0xFF, 0xFF, 0x83, 0xC4, 0x10, 0x8B, 0x86, 0xD4, 0x00, 0x00, 0x00, 0x3D, 0x38, 0xD5, 0x40, 0x00, 0x74, 0x1B, 0x39, 0x98, 0xB4, 0x00, 0x00, 0x00, 0x75, 0x13, 0x50, 0xE8, 0x05, 0x2E, 0x00, 0x00, 0xFF, 0xB6, 0xD4, 0x00, 0x00, 0x00, 0xE8, 0x86, 0xF3, 0xFF, 0xFF, 0x59, 0x59, 0x8D, 0x7E, 0x50, 0xC7, 0x45, 0x08, 0x06, 0x00, 0x00, 0x00, 0x81, 0x7F, 0xF8, 0x34, 0xD5, 0x40, 0x00, 0x74, 0x11, 0x8B, 0x07, 0x3B, 0xC3, 0x74, 0x0B, 0x39, 0x18, 0x75, 0x07, 0x50, 0xE8, 0x61, 0xF3, 0xFF, 0xFF, 0x59, 0x39, 0x5F, 0xFC, 0x74, 0x12, 0x8B,
				0x47, 0x04, 0x3B, 0xC3, 0x74, 0x0B, 0x39, 0x18, 0x75, 0x07, 0x50, 0xE8, 0x4A, 0xF3, 0xFF, 0xFF, 0x59, 0x83, 0xC7, 0x10, 0xFF, 0x4D, 0x08, 0x75, 0xC7, 0x56, 0xE8, 0x3B, 0xF3, 0xFF, 0xFF, 0x59, 0x5F, 0x5E, 0x5B, 0x5D, 0xC3, 0x8B, 0xFF, 0x55, 0x8B, 0xEC, 0x57, 0x8B, 0x7D, 0x0C, 0x85, 0xFF, 0x74, 0x3B, 0x8B, 0x45, 0x08, 0x85, 0xC0, 0x74, 0x34, 0x56, 0x8B, 0x30, 0x3B, 0xF7, 0x74, 0x28, 0x57, 0x89, 0x38, 0xE8, 0x6A, 0xFD, 0xFF, 0xFF, 0x59, 0x85, 0xF6, 0x74, 0x1B, 0x56, 0xE8, 0xEE, 0xFD, 0xFF, 0xFF, 0x83, 0x3E, 0x00, 0x59, 0x75, 0x0F, 0x81, 0xFE, 0xA0, 0xD6, 0x40, 0x00, 0x74, 0x07, 0x56, 0xE8, 0x73, 0xFE, 0xFF, 0xFF, 0x59, 0x8B, 0xC7, 0x5E, 0xEB, 0x02, 0x33, 0xC0, 0x5F, 0x5D, 0xC3, 0x6A, 0x0C, 0x68, 0x40, 0xC1, 0x40, 0x00, 0xE8, 0x36, 0x24, 0x00, 0x00, 0xE8, 0x18, 0x02, 0x00, 0x00, 0x8B, 0xF0, 0xA1, 0x30, 0xD5, 0x40, 0x00, 0x85, 0x46, 0x70, 0x74, 0x22, 0x83, 0x7E, 0x6C, 0x00, 0x74, 0x1C, 0xE8, 0x01, 0x02, 0x00, 0x00, 0x8B, 0x70, 0x6C, 0x85, 0xF6, 0x75, 0x08, 0x6A, 0x20, 0xE8, 0x49, 0x19, 0x00, 0x00, 0x59, 0x8B, 0xC6, 0xE8, 0x49, 0x24, 0x00, 0x00, 0xC3, 0x6A, 0x0C, 0xE8, 0x04, 0x2C, 0x00, 0x00, 0x59, 0x83, 0x65, 0xFC, 0x00, 0xFF, 0x35, 0x78, 0xD7, 0x40, 0x00, 0x83, 0xC6, 0x6C, 0x56, 0xE8, 0x59, 0xFF, 0xFF, 0xFF, 0x59, 0x59, 0x89, 0x45, 0xE4, 0xC7, 0x45, 0xFC, 0xFE, 0xFF, 0xFF, 0xFF, 0xE8, 0x02, 0x00, 0x00, 0x00, 0xEB, 0xBE, 0x6A, 0x0C, 0xE8, 0xFD, 0x2A, 0x00, 0x00, 0x59, 0x8B, 0x75, 0xE4, 0xC3, 0x6A, 0x00, 0xFF, 0x15, 0x78, 0xA0, 0x40, 0x00, 0xC3, 0xFF, 0x15, 0x7C, 0xA0, 0x40, 0x00, 0xC2, 0x04, 0x00, 0x8B, 0xFF, 0x56, 0xFF, 0x35, 0x80, 0xD7, 0x40, 0x00, 0xFF, 0x15, 0x80, 0xA0, 0x40, 0x00, 0x8B, 0xF0, 0x85, 0xF6, 0x75, 0x1B, 0xFF, 0x35, 0x14, 0xE1, 0x40, 0x00, 0xFF, 0x15, 0x88, 0xA0, 0x40, 0x00, 0x8B, 0xF0, 0x56, 0xFF, 0x35, 0x80, 0xD7, 0x40, 0x00, 0xFF, 0x15, 0x84, 0xA0, 0x40, 0x00, 0x8B, 0xC6, 0x5E, 0xC3, 0xA1, 0x7C, 0xD7, 0x40, 0x00, 0x83, 0xF8, 0xFF, 0x74, 0x16, 0x50, 0xFF, 0x35, 0x1C, 0xE1, 0x40, 0x00, 0xFF, 0x15, 0x88, 0xA0, 0x40, 0x00, 0xFF, 0xD0, 0x83, 0x0D, 0x7C, 0xD7, 0x40, 0x00, 0xFF, 0xA1, 0x80, 0xD7, 0x40, 0x00, 0x83, 0xF8, 0xFF, 0x74, 0x0E, 0x50, 0xFF, 0x15, 0x8C, 0xA0, 0x40, 0x00, 0x83, 0x0D, 0x80, 0xD7, 0x40, 0x00, 0xFF, 0xE9, 0x1E, 0x2A, 0x00, 0x00, 0x6A, 0x08, 0x68, 0x60, 0xC1, 0x40, 0x00, 0xE8, 0x3A, 0x23, 0x00, 0x00, 0x68, 0xC8, 0xA4, 0x40, 0x00, 0xFF, 0x15, 0x90, 0xA0, 0x40, 0x00, 0x8B, 0x75, 0x08, 0xC7, 0x46, 0x5C, 0x20, 0xB0, 0x40, 0x00, 0x83, 0x66, 0x08, 0x00, 0x33, 0xFF, 0x47, 0x89, 0x7E, 0x14, 0x89, 0x7E, 0x70, 0xC6, 0x86, 0xC8, 0x00, 0x00, 0x00, 0x43, 0xC6, 0x86, 0x4B, 0x01, 0x00, 0x00, 0x43, 0xC7, 0x46, 0x68, 0x10, 0xD0, 0x40, 0x00, 0x6A, 0x0D, 0xE8, 0x04, 0x2B, 0x00, 0x00, 0x59, 0x83, 0x65, 0xFC, 0x00, 0xFF, 0x76, 0x68, 0xFF, 0x15, 0x64, 0xA0, 0x40, 0x00, 0xC7, 0x45, 0xFC, 0xFE, 0xFF, 0xFF, 0xFF, 0xE8, 0x3E, 0x00, 0x00, 0x00, 0x6A, 0x0C, 0xE8, 0xE3, 0x2A, 0x00, 0x00, 0x59, 0x89, 0x7D, 0xFC, 0x8B, 0x45, 0x0C, 0x89, 0x46, 0x6C, 0x85, 0xC0, 0x75, 0x08, 0xA1, 0x78, 0xD7, 0x40, 0x00, 0x89, 0x46, 0x6C, 0xFF, 0x76, 0x6C, 0xE8, 0xBB,
				0xFB, 0xFF, 0xFF, 0x59, 0xC7, 0x45, 0xFC, 0xFE, 0xFF, 0xFF, 0xFF, 0xE8, 0x15, 0x00, 0x00, 0x00, 0xE8, 0xF0, 0x22, 0x00, 0x00, 0xC3, 0x33, 0xFF, 0x47, 0x8B, 0x75, 0x08, 0x6A, 0x0D, 0xE8, 0xCC, 0x29, 0x00, 0x00, 0x59, 0xC3, 0x6A, 0x0C, 0xE8, 0xC3, 0x29, 0x00, 0x00, 0x59, 0xC3, 0x8B, 0xFF, 0x56, 0x57, 0xFF, 0x15, 0x34, 0xA0, 0x40, 0x00, 0xFF, 0x35, 0x7C, 0xD7, 0x40, 0x00, 0x8B, 0xF8, 0xE8, 0xC4, 0xFE, 0xFF, 0xFF, 0xFF, 0xD0, 0x8B, 0xF0, 0x85, 0xF6, 0x75, 0x4E, 0x68, 0x14, 0x02, 0x00, 0x00, 0x6A, 0x01, 0xE8, 0xE7, 0x2A, 0x00, 0x00, 0x8B, 0xF0, 0x59, 0x59, 0x85, 0xF6, 0x74, 0x3A, 0x56, 0xFF, 0x35, 0x7C, 0xD7, 0x40, 0x00, 0xFF, 0x35, 0x18, 0xE1, 0x40, 0x00, 0xFF, 0x15, 0x88, 0xA0, 0x40, 0x00, 0xFF, 0xD0, 0x85, 0xC0, 0x74, 0x18, 0x6A, 0x00, 0x56, 0xE8, 0xF8, 0xFE, 0xFF, 0xFF, 0x59, 0x59, 0xFF, 0x15, 0x98, 0xA0, 0x40, 0x00, 0x83, 0x4E, 0x04, 0xFF, 0x89, 0x06, 0xEB, 0x09, 0x56, 0xE8, 0xCE, 0xF0, 0xFF, 0xFF, 0x59, 0x33, 0xF6, 0x57, 0xFF, 0x15, 0x94, 0xA0, 0x40, 0x00, 0x5F, 0x8B, 0xC6, 0x5E, 0xC3, 0x8B, 0xFF, 0x56, 0xE8, 0x7F, 0xFF, 0xFF, 0xFF, 0x8B, 0xF0, 0x85, 0xF6, 0x75, 0x08, 0x6A, 0x10, 0xE8, 0x41, 0x17, 0x00, 0x00, 0x59, 0x8B, 0xC6, 0x5E, 0xC3, 0x6A, 0x08, 0x68, 0x88, 0xC1, 0x40, 0x00, 0xE8, 0xF3, 0x21, 0x00, 0x00, 0x8B, 0x75, 0x08, 0x85, 0xF6, 0x0F, 0x84, 0xF8, 0x00, 0x00, 0x00, 0x8B, 0x46, 0x24, 0x85, 0xC0, 0x74, 0x07, 0x50, 0xE8, 0x81, 0xF0, 0xFF, 0xFF, 0x59, 0x8B, 0x46, 0x2C, 0x85, 0xC0, 0x74, 0x07, 0x50, 0xE8, 0x73, 0xF0, 0xFF, 0xFF, 0x59, 0x8B, 0x46, 0x34, 0x85, 0xC0, 0x74, 0x07, 0x50, 0xE8, 0x65, 0xF0, 0xFF, 0xFF, 0x59, 0x8B, 0x46, 0x3C, 0x85, 0xC0, 0x74, 0x07, 0x50, 0xE8, 0x57, 0xF0, 0xFF, 0xFF, 0x59, 0x8B, 0x46, 0x40, 0x85, 0xC0, 0x74, 0x07, 0x50, 0xE8, 0x49, 0xF0, 0xFF, 0xFF, 0x59, 0x8B, 0x46, 0x44, 0x85, 0xC0, 0x74, 0x07, 0x50, 0xE8, 0x3B, 0xF0, 0xFF, 0xFF, 0x59, 0x8B, 0x46, 0x48, 0x85, 0xC0, 0x74, 0x07, 0x50, 0xE8, 0x2D, 0xF0, 0xFF, 0xFF, 0x59, 0x8B, 0x46, 0x5C, 0x3D, 0x20, 0xB0, 0x40, 0x00, 0x74, 0x07, 0x50, 0xE8, 0x1C, 0xF0, 0xFF, 0xFF, 0x59, 0x6A, 0x0D, 0xE8, 0x76, 0x29, 0x00, 0x00, 0x59, 0x83, 0x65, 0xFC, 0x00, 0x8B, 0x7E, 0x68, 0x85, 0xFF, 0x74, 0x1A, 0x57, 0xFF, 0x15, 0x68, 0xA0, 0x40, 0x00, 0x85, 0xC0, 0x75, 0x0F, 0x81, 0xFF, 0x10, 0xD0, 0x40, 0x00, 0x74, 0x07, 0x57, 0xE8, 0xEF, 0xEF, 0xFF, 0xFF, 0x59, 0xC7, 0x45, 0xFC, 0xFE, 0xFF, 0xFF, 0xFF, 0xE8, 0x57, 0x00, 0x00, 0x00, 0x6A, 0x0C, 0xE8, 0x3D, 0x29, 0x00, 0x00, 0x59, 0xC7, 0x45, 0xFC, 0x01, 0x00, 0x00, 0x00, 0x8B, 0x7E, 0x6C, 0x85, 0xFF, 0x74, 0x23, 0x57, 0xE8, 0xAD, 0xFA, 0xFF, 0xFF, 0x59, 0x3B, 0x3D, 0x78, 0xD7, 0x40, 0x00, 0x74, 0x14, 0x81, 0xFF, 0xA0, 0xD6, 0x40, 0x00, 0x74, 0x0C, 0x83, 0x3F, 0x00, 0x75, 0x07, 0x57, 0xE8, 0x2A, 0xFB, 0xFF, 0xFF, 0x59, 0xC7, 0x45, 0xFC, 0xFE, 0xFF, 0xFF, 0xFF, 0xE8, 0x1E, 0x00, 0x00, 0x00, 0x56, 0xE8, 0x97, 0xEF, 0xFF, 0xFF, 0x59, 0xE8, 0x30, 0x21, 0x00, 0x00, 0xC2, 0x04, 0x00, 0x8B, 0x75, 0x08, 0x6A, 0x0D, 0xE8, 0x0D, 0x28, 0x00, 0x00, 0x59, 0xC3, 0x8B, 0x75, 0x08, 0x6A, 0x0C, 0xE8, 0x01, 0x28, 0x00, 0x00, 0x59, 0xC3, 0x8B, 0xFF, 0x57, 0x68,
				0xC8, 0xA4, 0x40, 0x00, 0xFF, 0x15, 0x90, 0xA0, 0x40, 0x00, 0x8B, 0xF8, 0x85, 0xFF, 0x75, 0x09, 0xE8, 0x34, 0xFD, 0xFF, 0xFF, 0x33, 0xC0, 0x5F, 0xC3, 0x56, 0x8B, 0x35, 0x9C, 0xA0, 0x40, 0x00, 0x68, 0x04, 0xA5, 0x40, 0x00, 0x57, 0xFF, 0xD6, 0x68, 0xF8, 0xA4, 0x40, 0x00, 0x57, 0xA3, 0x10, 0xE1, 0x40, 0x00, 0xFF, 0xD6, 0x68, 0xEC, 0xA4, 0x40, 0x00, 0x57, 0xA3, 0x14, 0xE1, 0x40, 0x00, 0xFF, 0xD6, 0x68, 0xE4, 0xA4, 0x40, 0x00, 0x57, 0xA3, 0x18, 0xE1, 0x40, 0x00, 0xFF, 0xD6, 0x83, 0x3D, 0x10, 0xE1, 0x40, 0x00, 0x00, 0x8B, 0x35, 0x84, 0xA0, 0x40, 0x00, 0xA3, 0x1C, 0xE1, 0x40, 0x00, 0x74, 0x16, 0x83, 0x3D, 0x14, 0xE1, 0x40, 0x00, 0x00, 0x74, 0x0D, 0x83, 0x3D, 0x18, 0xE1, 0x40, 0x00, 0x00, 0x74, 0x04, 0x85, 0xC0, 0x75, 0x24, 0xA1, 0x80, 0xA0, 0x40, 0x00, 0xA3, 0x14, 0xE1, 0x40, 0x00, 0xA1, 0x8C, 0xA0, 0x40, 0x00, 0xC7, 0x05, 0x10, 0xE1, 0x40, 0x00, 0x10, 0x32, 0x40, 0x00, 0x89, 0x35, 0x18, 0xE1, 0x40, 0x00, 0xA3, 0x1C, 0xE1, 0x40, 0x00, 0xFF, 0x15, 0x7C, 0xA0, 0x40, 0x00, 0xA3, 0x80, 0xD7, 0x40, 0x00, 0x83, 0xF8, 0xFF, 0x0F, 0x84, 0xC1, 0x00, 0x00, 0x00, 0xFF, 0x35, 0x14, 0xE1, 0x40, 0x00, 0x50, 0xFF, 0xD6, 0x85, 0xC0, 0x0F, 0x84, 0xB0, 0x00, 0x00, 0x00, 0xE8, 0xCA, 0x12, 0x00, 0x00, 0xFF, 0x35, 0x10, 0xE1, 0x40, 0x00, 0x8B, 0x35, 0x78, 0xA0, 0x40, 0x00, 0xFF, 0xD6, 0xFF, 0x35, 0x14, 0xE1, 0x40, 0x00, 0xA3, 0x10, 0xE1, 0x40, 0x00, 0xFF, 0xD6, 0xFF, 0x35, 0x18, 0xE1, 0x40, 0x00, 0xA3, 0x14, 0xE1, 0x40, 0x00, 0xFF, 0xD6, 0xFF, 0x35, 0x1C, 0xE1, 0x40, 0x00, 0xA3, 0x18, 0xE1, 0x40, 0x00, 0xFF, 0xD6, 0xA3, 0x1C, 0xE1, 0x40, 0x00, 0xE8, 0x54, 0x26, 0x00, 0x00, 0x85, 0xC0, 0x74, 0x63, 0x8B, 0x3D, 0x88, 0xA0, 0x40, 0x00, 0x68, 0xD1, 0x33, 0x40, 0x00, 0xFF, 0x35, 0x10, 0xE1, 0x40, 0x00, 0xFF, 0xD7, 0xFF, 0xD0, 0xA3, 0x7C, 0xD7, 0x40, 0x00, 0x83, 0xF8, 0xFF, 0x74, 0x44, 0x68, 0x14, 0x02, 0x00, 0x00, 0x6A, 0x01, 0xE8, 0x17, 0x28, 0x00, 0x00, 0x8B, 0xF0, 0x59, 0x59, 0x85, 0xF6, 0x74, 0x30, 0x56, 0xFF, 0x35, 0x7C, 0xD7, 0x40, 0x00, 0xFF, 0x35, 0x18, 0xE1, 0x40, 0x00, 0xFF, 0xD7, 0xFF, 0xD0, 0x85, 0xC0, 0x74, 0x1B, 0x6A, 0x00, 0x56, 0xE8, 0x2C, 0xFC, 0xFF, 0xFF, 0x59, 0x59, 0xFF, 0x15, 0x98, 0xA0, 0x40, 0x00, 0x83, 0x4E, 0x04, 0xFF, 0x89, 0x06, 0x33, 0xC0, 0x40, 0xEB, 0x07, 0xE8, 0xD7, 0xFB, 0xFF, 0xFF, 0x33, 0xC0, 0x5E, 0x5F, 0xC3, 0x8B, 0xFF, 0x55, 0x8B, 0xEC, 0x83, 0xEC, 0x18, 0x53, 0x56, 0xFF, 0x75, 0x0C, 0x8D, 0x4D, 0xE8, 0xE8, 0x3E, 0xEA, 0xFF, 0xFF, 0x8B, 0x5D, 0x08, 0xBE, 0x00, 0x01, 0x00, 0x00, 0x3B, 0xDE, 0x73, 0x54, 0x8B, 0x4D, 0xE8, 0x83, 0xB9, 0xAC, 0x00, 0x00, 0x00, 0x01, 0x7E, 0x14, 0x8D, 0x45, 0xE8, 0x50, 0x6A, 0x01, 0x53, 0xE8, 0x5F, 0x2D, 0x00, 0x00, 0x8B, 0x4D, 0xE8, 0x83, 0xC4, 0x0C, 0xEB, 0x0D, 0x8B, 0x81, 0xC8, 0x00, 0x00, 0x00, 0x0F, 0xB7, 0x04, 0x58, 0x83, 0xE0, 0x01, 0x85, 0xC0, 0x74, 0x0F, 0x8B, 0x81, 0xCC, 0x00, 0x00, 0x00, 0x0F, 0xB6, 0x04, 0x18, 0xE9, 0xA3, 0x00, 0x00, 0x00, 0x80, 0x7D, 0xF4, 0x00, 0x74, 0x07, 0x8B, 0x45, 0xF0, 0x83, 0x60, 0x70, 0xFD, 0x8B, 0xC3, 0xE9, 0x9C, 0x00, 0x00, 0x00, 0x8B, 0x45, 0xE8, 0x83, 0xB8, 0xAC, 0x00, 0x00,
				0x00, 0x01, 0x7E, 0x31, 0x89, 0x5D, 0x08, 0xC1, 0x7D, 0x08, 0x08, 0x8D, 0x45, 0xE8, 0x50, 0x8B, 0x45, 0x08, 0x25, 0xFF, 0x00, 0x00, 0x00, 0x50, 0xE8, 0xB3, 0x2C, 0x00, 0x00, 0x59, 0x59, 0x85, 0xC0, 0x74, 0x12, 0x8A, 0x45, 0x08, 0x6A, 0x02, 0x88, 0x45, 0xFC, 0x88, 0x5D, 0xFD, 0xC6, 0x45, 0xFE, 0x00, 0x59, 0xEB, 0x15, 0xE8, 0x3A, 0x02, 0x00, 0x00, 0xC7, 0x00, 0x2A, 0x00, 0x00, 0x00, 0x33, 0xC9, 0x88, 0x5D, 0xFC, 0xC6, 0x45, 0xFD, 0x00, 0x41, 0x8B, 0x45, 0xE8, 0x6A, 0x01, 0xFF, 0x70, 0x04, 0x8D, 0x55, 0xF8, 0x6A, 0x03, 0x52, 0x51, 0x8D, 0x4D, 0xFC, 0x51, 0x56, 0xFF, 0x70, 0x14, 0x8D, 0x45, 0xE8, 0x50, 0xE8, 0x8F, 0x23, 0x00, 0x00, 0x83, 0xC4, 0x24, 0x85, 0xC0, 0x0F, 0x84, 0x6F, 0xFF, 0xFF, 0xFF, 0x83, 0xF8, 0x01, 0x0F, 0xB6, 0x45, 0xF8, 0x74, 0x09, 0x0F, 0xB6, 0x4D, 0xF9, 0xC1, 0xE0, 0x08, 0x0B, 0xC1, 0x80, 0x7D, 0xF4, 0x00, 0x74, 0x07, 0x8B, 0x4D, 0xF0, 0x83, 0x61, 0x70, 0xFD, 0x5E, 0x5B, 0xC9, 0xC3, 0x8B, 0xFF, 0x55, 0x8B, 0xEC, 0x8B, 0x45, 0x08, 0xA3, 0x20, 0xE1, 0x40, 0x00, 0x5D, 0xC3, 0x8B, 0xFF, 0x55, 0x8B, 0xEC, 0x81, 0xEC, 0x28, 0x03, 0x00, 0x00, 0xA1, 0x04, 0xD0, 0x40, 0x00, 0x33, 0xC5, 0x89, 0x45, 0xFC, 0x53, 0x8B, 0x5D, 0x08, 0x57, 0x83, 0xFB, 0xFF, 0x74, 0x07, 0x53, 0xE8, 0x96, 0x20, 0x00, 0x00, 0x59, 0x83, 0xA5, 0xE0, 0xFC, 0xFF, 0xFF, 0x00, 0x6A, 0x4C, 0x8D, 0x85, 0xE4, 0xFC, 0xFF, 0xFF, 0x6A, 0x00, 0x50, 0xE8, 0x94, 0x20, 0x00, 0x00, 0x8D, 0x85, 0xE0, 0xFC, 0xFF, 0xFF, 0x89, 0x85, 0xD8, 0xFC, 0xFF, 0xFF, 0x8D, 0x85, 0x30, 0xFD, 0xFF, 0xFF, 0x83, 0xC4, 0x0C, 0x89, 0x85, 0xDC, 0xFC, 0xFF, 0xFF, 0x89, 0x85, 0xE0, 0xFD, 0xFF, 0xFF, 0x89, 0x8D, 0xDC, 0xFD, 0xFF, 0xFF, 0x89, 0x95, 0xD8, 0xFD, 0xFF, 0xFF, 0x89, 0x9D, 0xD4, 0xFD, 0xFF, 0xFF, 0x89, 0xB5, 0xD0, 0xFD, 0xFF, 0xFF, 0x89, 0xBD, 0xCC, 0xFD, 0xFF, 0xFF, 0x66, 0x8C, 0x95, 0xF8, 0xFD, 0xFF, 0xFF, 0x66, 0x8C, 0x8D, 0xEC, 0xFD, 0xFF, 0xFF, 0x66, 0x8C, 0x9D, 0xC8, 0xFD, 0xFF, 0xFF, 0x66, 0x8C, 0x85, 0xC4, 0xFD, 0xFF, 0xFF, 0x66, 0x8C, 0xA5, 0xC0, 0xFD, 0xFF, 0xFF, 0x66, 0x8C, 0xAD, 0xBC, 0xFD, 0xFF, 0xFF, 0x9C, 0x8F, 0x85, 0xF0, 0xFD, 0xFF, 0xFF, 0x8B, 0x45, 0x04, 0x8D, 0x4D, 0x04, 0x89, 0x8D, 0xF4, 0xFD, 0xFF, 0xFF, 0xC7, 0x85, 0x30, 0xFD, 0xFF, 0xFF, 0x01, 0x00, 0x01, 0x00, 0x89, 0x85, 0xE8, 0xFD, 0xFF, 0xFF, 0x8B, 0x49, 0xFC, 0x89, 0x8D, 0xE4, 0xFD, 0xFF, 0xFF, 0x8B, 0x4D, 0x0C, 0x89, 0x8D, 0xE0, 0xFC, 0xFF, 0xFF, 0x8B, 0x4D, 0x10, 0x89, 0x8D, 0xE4, 0xFC, 0xFF, 0xFF, 0x89, 0x85, 0xEC, 0xFC, 0xFF, 0xFF, 0xFF, 0x15, 0x5C, 0xA0, 0x40, 0x00, 0x6A, 0x00, 0x8B, 0xF8, 0xFF, 0x15, 0x58, 0xA0, 0x40, 0x00, 0x8D, 0x85, 0xD8, 0xFC, 0xFF, 0xFF, 0x50, 0xFF, 0x15, 0x54, 0xA0, 0x40, 0x00, 0x85, 0xC0, 0x75, 0x10, 0x85, 0xFF, 0x75, 0x0C, 0x83, 0xFB, 0xFF, 0x74, 0x07, 0x53, 0xE8, 0xA1, 0x1F, 0x00, 0x00, 0x59, 0x8B, 0x4D, 0xFC, 0x5F, 0x33, 0xCD, 0x5B, 0xE8, 0xF9, 0xE7, 0xFF, 0xFF, 0xC9, 0xC3, 0x8B, 0xFF, 0x56, 0x6A, 0x01, 0xBE, 0x17, 0x04, 0x00, 0xC0, 0x56, 0x6A, 0x02, 0xE8, 0xC5, 0xFE, 0xFF, 0xFF, 0x83, 0xC4, 0x0C, 0x56, 0xFF, 0x15, 0x50, 0xA0, 0x40, 0x00, 0x50, 0xFF, 0x15, 0x4C, 0xA0, 0x40, 0x00, 0x5E,
				0xC3, 0x8B, 0xFF, 0x55, 0x8B, 0xEC, 0xFF, 0x35, 0x20, 0xE1, 0x40, 0x00, 0xFF, 0x15, 0x88, 0xA0, 0x40, 0x00, 0x85, 0xC0, 0x74, 0x03, 0x5D, 0xFF, 0xE0, 0xFF, 0x75, 0x18, 0xFF, 0x75, 0x14, 0xFF, 0x75, 0x10, 0xFF, 0x75, 0x0C, 0xFF, 0x75, 0x08, 0xE8, 0xAF, 0xFF, 0xFF, 0xFF, 0xCC, 0x33, 0xC0, 0x50, 0x50, 0x50, 0x50, 0x50, 0xE8, 0xC7, 0xFF, 0xFF, 0xFF, 0x83, 0xC4, 0x14, 0xC3, 0x8B, 0xFF, 0x55, 0x8B, 0xEC, 0x8B, 0x45, 0x08, 0x33, 0xC9, 0x3B, 0x04, 0xCD, 0x88, 0xD7, 0x40, 0x00, 0x74, 0x13, 0x41, 0x83, 0xF9, 0x2D, 0x72, 0xF1, 0x8D, 0x48, 0xED, 0x83, 0xF9, 0x11, 0x77, 0x0E, 0x6A, 0x0D, 0x58, 0x5D, 0xC3, 0x8B, 0x04, 0xCD, 0x8C, 0xD7, 0x40, 0x00, 0x5D, 0xC3, 0x05, 0x44, 0xFF, 0xFF, 0xFF, 0x6A, 0x0E, 0x59, 0x3B, 0xC8, 0x1B, 0xC0, 0x23, 0xC1, 0x83, 0xC0, 0x08, 0x5D, 0xC3, 0xE8, 0xCD, 0xF9, 0xFF, 0xFF, 0x85, 0xC0, 0x75, 0x06, 0xB8, 0xF0, 0xD8, 0x40, 0x00, 0xC3, 0x83, 0xC0, 0x08, 0xC3, 0xE8, 0xBA, 0xF9, 0xFF, 0xFF, 0x85, 0xC0, 0x75, 0x06, 0xB8, 0xF4, 0xD8, 0x40, 0x00, 0xC3, 0x83, 0xC0, 0x0C, 0xC3, 0x8B, 0xFF, 0x55, 0x8B, 0xEC, 0x56, 0xE8, 0xE2, 0xFF, 0xFF, 0xFF, 0x8B, 0x4D, 0x08, 0x51, 0x89, 0x08, 0xE8, 0x82, 0xFF, 0xFF, 0xFF, 0x59, 0x8B, 0xF0, 0xE8, 0xBC, 0xFF, 0xFF, 0xFF, 0x89, 0x30, 0x5E, 0x5D, 0xC3, 0xCC, 0xCC, 0xCC, 0xCC, 0xCC, 0xCC, 0xCC, 0xCC, 0xCC, 0xCC, 0xCC, 0x55, 0x8B, 0xEC, 0x57, 0x56, 0x53, 0x8B, 0x4D, 0x10, 0x0B, 0xC9, 0x74, 0x4D, 0x8B, 0x75, 0x08, 0x8B, 0x7D, 0x0C, 0xB7, 0x41, 0xB3, 0x5A, 0xB6, 0x20, 0x8D, 0x49, 0x00, 0x8A, 0x26, 0x0A, 0xE4, 0x8A, 0x07, 0x74, 0x27, 0x0A, 0xC0, 0x74, 0x23, 0x83, 0xC6, 0x01, 0x83, 0xC7, 0x01, 0x3A, 0xE7, 0x72, 0x06, 0x3A, 0xE3, 0x77, 0x02, 0x02, 0xE6, 0x3A, 0xC7, 0x72, 0x06, 0x3A, 0xC3, 0x77, 0x02, 0x02, 0xC6, 0x3A, 0xE0, 0x75, 0x0B, 0x83, 0xE9, 0x01, 0x75, 0xD1, 0x33, 0xC9, 0x3A, 0xE0, 0x74, 0x09, 0xB9, 0xFF, 0xFF, 0xFF, 0xFF, 0x72, 0x02, 0xF7, 0xD9, 0x8B, 0xC1, 0x5B, 0x5E, 0x5F, 0xC9, 0xC3, 0x8B, 0xFF, 0x55, 0x8B, 0xEC, 0x51, 0x56, 0x8B, 0x75, 0x0C, 0x56, 0xE8, 0xB3, 0x3B, 0x00, 0x00, 0x89, 0x45, 0x0C, 0x8B, 0x46, 0x0C, 0x59, 0xA8, 0x82, 0x75, 0x17, 0xE8, 0x2B, 0xFF, 0xFF, 0xFF, 0xC7, 0x00, 0x09, 0x00, 0x00, 0x00, 0x83, 0x4E, 0x0C, 0x20, 0x83, 0xC8, 0xFF, 0xE9, 0x2F, 0x01, 0x00, 0x00, 0xA8, 0x40, 0x74, 0x0D, 0xE8, 0x10, 0xFF, 0xFF, 0xFF, 0xC7, 0x00, 0x22, 0x00, 0x00, 0x00, 0xEB, 0xE3, 0x53, 0x33, 0xDB, 0xA8, 0x01, 0x74, 0x16, 0x89, 0x5E, 0x04, 0xA8, 0x10, 0x0F, 0x84, 0x87, 0x00, 0x00, 0x00, 0x8B, 0x4E, 0x08, 0x83, 0xE0, 0xFE, 0x89, 0x0E, 0x89, 0x46, 0x0C, 0x8B, 0x46, 0x0C, 0x83, 0xE0, 0xEF, 0x83, 0xC8, 0x02, 0x89, 0x46, 0x0C, 0x89, 0x5E, 0x04, 0x89, 0x5D, 0xFC, 0xA9, 0x0C, 0x01, 0x00, 0x00, 0x75, 0x2C, 0xE8, 0x90, 0x39, 0x00, 0x00, 0x83, 0xC0, 0x20, 0x3B, 0xF0, 0x74, 0x0C, 0xE8, 0x84, 0x39, 0x00, 0x00, 0x83, 0xC0, 0x40, 0x3B, 0xF0, 0x75, 0x0D, 0xFF, 0x75, 0x0C, 0xE8, 0x1F, 0x39, 0x00, 0x00, 0x59, 0x85, 0xC0, 0x75, 0x07, 0x56, 0xE8, 0xCB, 0x38, 0x00, 0x00, 0x59, 0xF7, 0x46, 0x0C, 0x08, 0x01, 0x00, 0x00, 0x57, 0x0F, 0x84, 0x80, 0x00, 0x00, 0x00, 0x8B, 0x46, 0x08, 0x8B, 0x3E, 0x8D, 0x48, 0x01, 0x89, 0x0E, 0x8B, 0x4E,
				0x18, 0x2B, 0xF8, 0x49, 0x89, 0x4E, 0x04, 0x3B, 0xFB, 0x7E, 0x1D, 0x57, 0x50, 0xFF, 0x75, 0x0C, 0xE8, 0xC7, 0x37, 0x00, 0x00, 0x83, 0xC4, 0x0C, 0x89, 0x45, 0xFC, 0xEB, 0x4D, 0x83, 0xC8, 0x20, 0x89, 0x46, 0x0C, 0x83, 0xC8, 0xFF, 0xEB, 0x79, 0x8B, 0x4D, 0x0C, 0x83, 0xF9, 0xFF, 0x74, 0x1B, 0x83, 0xF9, 0xFE, 0x74, 0x16, 0x8B, 0xC1, 0x83, 0xE0, 0x1F, 0x8B, 0xD1, 0xC1, 0xFA, 0x05, 0xC1, 0xE0, 0x06, 0x03, 0x04, 0x95, 0x80, 0xFA, 0x40, 0x00, 0xEB, 0x05, 0xB8, 0x08, 0xD9, 0x40, 0x00, 0xF6, 0x40, 0x04, 0x20, 0x74, 0x14, 0x6A, 0x02, 0x53, 0x53, 0x51, 0xE8, 0x95, 0x2F, 0x00, 0x00, 0x23, 0xC2, 0x83, 0xC4, 0x10, 0x83, 0xF8, 0xFF, 0x74, 0x25, 0x8B, 0x46, 0x08, 0x8A, 0x4D, 0x08, 0x88, 0x08, 0xEB, 0x16, 0x33, 0xFF, 0x47, 0x57, 0x8D, 0x45, 0x08, 0x50, 0xFF, 0x75, 0x0C, 0xE8, 0x58, 0x37, 0x00, 0x00, 0x83, 0xC4, 0x0C, 0x89, 0x45, 0xFC, 0x39, 0x7D, 0xFC, 0x74, 0x09, 0x83, 0x4E, 0x0C, 0x20, 0x83, 0xC8, 0xFF, 0xEB, 0x08, 0x8B, 0x45, 0x08, 0x25, 0xFF, 0x00, 0x00, 0x00, 0x5F, 0x5B, 0x5E, 0xC9, 0xC3, 0xF6, 0x41, 0x0C, 0x40, 0x74, 0x06, 0x83, 0x79, 0x08, 0x00, 0x74, 0x24, 0xFF, 0x49, 0x04, 0x78, 0x0B, 0x8B, 0x11, 0x88, 0x02, 0xFF, 0x01, 0x0F, 0xB6, 0xC0, 0xEB, 0x0C, 0x0F, 0xBE, 0xC0, 0x51, 0x50, 0xE8, 0x76, 0xFE, 0xFF, 0xFF, 0x59, 0x59, 0x83, 0xF8, 0xFF, 0x75, 0x03, 0x09, 0x06, 0xC3, 0xFF, 0x06, 0xC3, 0x8B, 0xFF, 0x55, 0x8B, 0xEC, 0x51, 0xF6, 0x43, 0x0C, 0x40, 0x56, 0x8B, 0xF0, 0x8B, 0x07, 0x89, 0x45, 0xFC, 0x74, 0x0D, 0x83, 0x7B, 0x08, 0x00, 0x75, 0x07, 0x8B, 0x45, 0x0C, 0x01, 0x06, 0xEB, 0x3E, 0x83, 0x27, 0x00, 0x83, 0x7D, 0x0C, 0x00, 0x7E, 0x30, 0x8B, 0x45, 0x08, 0x8A, 0x00, 0xFF, 0x4D, 0x0C, 0x8B, 0xCB, 0xE8, 0x94, 0xFF, 0xFF, 0xFF, 0xFF, 0x45, 0x08, 0x83, 0x3E, 0xFF, 0x75, 0x0E, 0x83, 0x3F, 0x2A, 0x75, 0x0F, 0x8B, 0xCB, 0xB0, 0x3F, 0xE8, 0x7E, 0xFF, 0xFF, 0xFF, 0x83, 0x7D, 0x0C, 0x00, 0x7F, 0xD5, 0x83, 0x3F, 0x00, 0x75, 0x05, 0x8B, 0x45, 0xFC, 0x89, 0x07, 0x5E, 0xC9, 0xC3, 0x8B, 0xFF, 0x55, 0x8B, 0xEC, 0x81, 0xEC, 0x80, 0x02, 0x00, 0x00, 0xA1, 0x04, 0xD0, 0x40, 0x00, 0x33, 0xC5, 0x89, 0x45, 0xFC, 0x53, 0x8B, 0x5D, 0x0C, 0x56, 0x8B, 0x75, 0x08, 0x33, 0xC0, 0x57, 0x8B, 0x7D, 0x14, 0xFF, 0x75, 0x10, 0x8D, 0x8D, 0xA4, 0xFD, 0xFF, 0xFF, 0x89, 0xB5, 0xD0, 0xFD, 0xFF, 0xFF, 0x89, 0xBD, 0xE4, 0xFD, 0xFF, 0xFF, 0x89, 0x85, 0xB4, 0xFD, 0xFF, 0xFF, 0x89, 0x85, 0xF0, 0xFD, 0xFF, 0xFF, 0x89, 0x85, 0xC8, 0xFD, 0xFF, 0xFF, 0x89, 0x85, 0xE8, 0xFD, 0xFF, 0xFF, 0x89, 0x85, 0xCC, 0xFD, 0xFF, 0xFF, 0x89, 0x85, 0xBC, 0xFD, 0xFF, 0xFF, 0x89, 0x85, 0xC4, 0xFD, 0xFF, 0xFF, 0xE8, 0x4D, 0xE4, 0xFF, 0xFF, 0xE8, 0xE6, 0xFC, 0xFF, 0xFF, 0x89, 0x85, 0x94, 0xFD, 0xFF, 0xFF, 0x85, 0xF6, 0x75, 0x2B, 0xE8, 0xD7, 0xFC, 0xFF, 0xFF, 0xC7, 0x00, 0x16, 0x00, 0x00, 0x00, 0xE8, 0x7A, 0xFC, 0xFF, 0xFF, 0x80, 0xBD, 0xB0, 0xFD, 0xFF, 0xFF, 0x00, 0x74, 0x0A, 0x8B, 0x85, 0xAC, 0xFD, 0xFF, 0xFF, 0x83, 0x60, 0x70, 0xFD, 0x83, 0xC8, 0xFF, 0xE9, 0x37, 0x0B, 0x00, 0x00, 0xF6, 0x46, 0x0C, 0x40, 0x75, 0x5E, 0x56, 0xE8, 0x1D, 0x39, 0x00, 0x00, 0x59, 0xBA, 0x08, 0xD9, 0x40, 0x00, 0x83, 0xF8, 0xFF, 0x74, 0x1B, 0x83, 0xF8,
				0xFE, 0x74, 0x16, 0x8B, 0xC8, 0x83, 0xE1, 0x1F, 0x8B, 0xF0, 0xC1, 0xFE, 0x05, 0xC1, 0xE1, 0x06, 0x03, 0x0C, 0xB5, 0x80, 0xFA, 0x40, 0x00, 0xEB, 0x02, 0x8B, 0xCA, 0xF6, 0x41, 0x24, 0x7F, 0x75, 0x9B, 0x83, 0xF8, 0xFF, 0x74, 0x19, 0x83, 0xF8, 0xFE, 0x74, 0x14, 0x8B, 0xC8, 0x83, 0xE0, 0x1F, 0xC1, 0xF9, 0x05, 0xC1, 0xE0, 0x06, 0x03, 0x04, 0x8D, 0x80, 0xFA, 0x40, 0x00, 0xEB, 0x02, 0x8B, 0xC2, 0xF6, 0x40, 0x24, 0x80, 0x0F, 0x85, 0x71, 0xFF, 0xFF, 0xFF, 0x33, 0xC9, 0x3B, 0xD9, 0x0F, 0x84, 0x67, 0xFF, 0xFF, 0xFF, 0x8A, 0x13, 0x89, 0x8D, 0xDC, 0xFD, 0xFF, 0xFF, 0x89, 0x8D, 0xD8, 0xFD, 0xFF, 0xFF, 0x89, 0x8D, 0xB8, 0xFD, 0xFF, 0xFF, 0x88, 0x95, 0xEF, 0xFD, 0xFF, 0xFF, 0x84, 0xD2, 0x0F, 0x84, 0x8E, 0x0A, 0x00, 0x00, 0x43, 0x33, 0xF6, 0x89, 0x9D, 0xC0, 0xFD, 0xFF, 0xFF, 0x39, 0xB5, 0xDC, 0xFD, 0xFF, 0xFF, 0x0F, 0x8C, 0x79, 0x0A, 0x00, 0x00, 0x8D, 0x42, 0xE0, 0x3C, 0x58, 0x77, 0x0F, 0x0F, 0xBE, 0xC2, 0x0F, 0xBE, 0x80, 0x88, 0xA5, 0x40, 0x00, 0x83, 0xE0, 0x0F, 0xEB, 0x02, 0x33, 0xC0, 0x0F, 0xBE, 0x84, 0xC1, 0xA8, 0xA5, 0x40, 0x00, 0x6A, 0x07, 0xC1, 0xF8, 0x04, 0x59, 0x89, 0x85, 0x8C, 0xFD, 0xFF, 0xFF, 0x3B, 0xC1, 0x0F, 0x87, 0x20, 0x0A, 0x00, 0x00, 0xFF, 0x24, 0x85, 0x02, 0x48, 0x40, 0x00, 0x83, 0x8D, 0xE8, 0xFD, 0xFF, 0xFF, 0xFF, 0x89, 0xB5, 0x88, 0xFD, 0xFF, 0xFF, 0x89, 0xB5, 0xBC, 0xFD, 0xFF, 0xFF, 0x89, 0xB5, 0xC8, 0xFD, 0xFF, 0xFF, 0x89, 0xB5, 0xCC, 0xFD, 0xFF, 0xFF, 0x89, 0xB5, 0xF0, 0xFD, 0xFF, 0xFF, 0x89, 0xB5, 0xC4, 0xFD, 0xFF, 0xFF, 0xE9, 0xE9, 0x09, 0x00, 0x00, 0x0F, 0xBE, 0xC2, 0x83, 0xE8, 0x20, 0x74, 0x4A, 0x83, 0xE8, 0x03, 0x74, 0x36, 0x83, 0xE8, 0x08, 0x74, 0x25, 0x48, 0x48, 0x74, 0x15, 0x83, 0xE8, 0x03, 0x0F, 0x85, 0xCA, 0x09, 0x00, 0x00, 0x83, 0x8D, 0xF0, 0xFD, 0xFF, 0xFF, 0x08, 0xE9, 0xBE, 0x09, 0x00, 0x00, 0x83, 0x8D, 0xF0, 0xFD, 0xFF, 0xFF, 0x04, 0xE9, 0xB2, 0x09, 0x00, 0x00, 0x83, 0x8D, 0xF0, 0xFD, 0xFF, 0xFF, 0x01, 0xE9, 0xA6, 0x09, 0x00, 0x00, 0x81, 0x8D, 0xF0, 0xFD, 0xFF, 0xFF, 0x80, 0x00, 0x00, 0x00, 0xE9, 0x97, 0x09, 0x00, 0x00, 0x83, 0x8D, 0xF0, 0xFD, 0xFF, 0xFF, 0x02, 0xE9, 0x8B, 0x09, 0x00, 0x00, 0x80, 0xFA, 0x2A, 0x75, 0x2C, 0x83, 0xC7, 0x04, 0x89, 0xBD, 0xE4, 0xFD, 0xFF, 0xFF, 0x8B, 0x7F, 0xFC, 0x89, 0xBD, 0xC8, 0xFD, 0xFF, 0xFF, 0x3B, 0xFE, 0x0F, 0x8D, 0x6C, 0x09, 0x00, 0x00, 0x83, 0x8D, 0xF0, 0xFD, 0xFF, 0xFF, 0x04, 0xF7, 0x9D, 0xC8, 0xFD, 0xFF, 0xFF, 0xE9, 0x5A, 0x09, 0x00, 0x00, 0x8B, 0x85, 0xC8, 0xFD, 0xFF, 0xFF, 0x6B, 0xC0, 0x0A, 0x0F, 0xBE, 0xCA, 0x8D, 0x44, 0x08, 0xD0, 0x89, 0x85, 0xC8, 0xFD, 0xFF, 0xFF, 0xE9, 0x3F, 0x09, 0x00, 0x00, 0x89, 0xB5, 0xE8, 0xFD, 0xFF, 0xFF, 0xE9, 0x34, 0x09, 0x00, 0x00, 0x80, 0xFA, 0x2A, 0x75, 0x26, 0x83, 0xC7, 0x04, 0x89, 0xBD, 0xE4, 0xFD, 0xFF, 0xFF, 0x8B, 0x7F, 0xFC, 0x89, 0xBD, 0xE8, 0xFD, 0xFF, 0xFF, 0x3B, 0xFE, 0x0F, 0x8D, 0x15, 0x09, 0x00, 0x00, 0x83, 0x8D, 0xE8, 0xFD, 0xFF, 0xFF, 0xFF, 0xE9, 0x09, 0x09, 0x00, 0x00, 0x8B, 0x85, 0xE8, 0xFD, 0xFF, 0xFF, 0x6B, 0xC0, 0x0A, 0x0F, 0xBE, 0xCA, 0x8D, 0x44, 0x08, 0xD0, 0x89, 0x85, 0xE8, 0xFD, 0xFF, 0xFF, 0xE9, 0xEE, 0x08, 0x00, 0x00, 0x80, 0xFA,
				0x49, 0x74, 0x55, 0x80, 0xFA, 0x68, 0x74, 0x44, 0x80, 0xFA, 0x6C, 0x74, 0x18, 0x80, 0xFA, 0x77, 0x0F, 0x85, 0xD6, 0x08, 0x00, 0x00, 0x81, 0x8D, 0xF0, 0xFD, 0xFF, 0xFF, 0x00, 0x08, 0x00, 0x00, 0xE9, 0xC7, 0x08, 0x00, 0x00, 0x80, 0x3B, 0x6C, 0x75, 0x16, 0x43, 0x81, 0x8D, 0xF0, 0xFD, 0xFF, 0xFF, 0x00, 0x10, 0x00, 0x00, 0x89, 0x9D, 0xC0, 0xFD, 0xFF, 0xFF, 0xE9, 0xAC, 0x08, 0x00, 0x00, 0x83, 0x8D, 0xF0, 0xFD, 0xFF, 0xFF, 0x10, 0xE9, 0xA0, 0x08, 0x00, 0x00, 0x83, 0x8D, 0xF0, 0xFD, 0xFF, 0xFF, 0x20, 0xE9, 0x94, 0x08, 0x00, 0x00, 0x8A, 0x03, 0x3C, 0x36, 0x75, 0x1E, 0x80, 0x7B, 0x01, 0x34, 0x75, 0x18, 0x83, 0xC3, 0x02, 0x81, 0x8D, 0xF0, 0xFD, 0xFF, 0xFF, 0x00, 0x80, 0x00, 0x00, 0x89, 0x9D, 0xC0, 0xFD, 0xFF, 0xFF, 0xE9, 0x70, 0x08, 0x00, 0x00, 0x3C, 0x33, 0x75, 0x1E, 0x80, 0x7B, 0x01, 0x32, 0x75, 0x18, 0x83, 0xC3, 0x02, 0x81, 0xA5, 0xF0, 0xFD, 0xFF, 0xFF, 0xFF, 0x7F, 0xFF, 0xFF, 0x89, 0x9D, 0xC0, 0xFD, 0xFF, 0xFF, 0xE9, 0x4E, 0x08, 0x00, 0x00, 0x3C, 0x64, 0x0F, 0x84, 0x46, 0x08, 0x00, 0x00, 0x3C, 0x69, 0x0F, 0x84, 0x3E, 0x08, 0x00, 0x00, 0x3C, 0x6F, 0x0F, 0x84, 0x36, 0x08, 0x00, 0x00, 0x3C, 0x75, 0x0F, 0x84, 0x2E, 0x08, 0x00, 0x00, 0x3C, 0x78, 0x0F, 0x84, 0x26, 0x08, 0x00, 0x00, 0x3C, 0x58, 0x0F, 0x84, 0x1E, 0x08, 0x00, 0x00, 0x89, 0xB5, 0x8C, 0xFD, 0xFF, 0xFF, 0x21, 0xB5, 0xC4, 0xFD, 0xFF, 0xFF, 0x8D, 0x85, 0xA4, 0xFD, 0xFF, 0xFF, 0x50, 0x0F, 0xB6, 0xC2, 0x50, 0xE8, 0x16, 0x24, 0x00, 0x00, 0x59, 0x85, 0xC0, 0x8A, 0x85, 0xEF, 0xFD, 0xFF, 0xFF, 0x59, 0x74, 0x22, 0x8B, 0x8D, 0xD0, 0xFD, 0xFF, 0xFF, 0x8D, 0xB5, 0xDC, 0xFD, 0xFF, 0xFF, 0xE8, 0xB6, 0xFB, 0xFF, 0xFF, 0x8A, 0x03, 0x43, 0x89, 0x9D, 0xC0, 0xFD, 0xFF, 0xFF, 0x84, 0xC0, 0x0F, 0x84, 0xB0, 0xFC, 0xFF, 0xFF, 0x8B, 0x8D, 0xD0, 0xFD, 0xFF, 0xFF, 0x8D, 0xB5, 0xDC, 0xFD, 0xFF, 0xFF, 0xE8, 0x94, 0xFB, 0xFF, 0xFF, 0xE9, 0xBE, 0x07, 0x00, 0x00, 0x0F, 0xBE, 0xC2, 0x83, 0xF8, 0x64, 0x0F, 0x8F, 0xB6, 0x01, 0x00, 0x00, 0x0F, 0x84, 0x58, 0x02, 0x00, 0x00, 0x83, 0xF8, 0x53, 0x0F, 0x8F, 0xBA, 0x00, 0x00, 0x00, 0x74, 0x4C, 0x83, 0xE8, 0x41, 0x74, 0x10, 0x48, 0x48, 0x74, 0x24, 0x48, 0x48, 0x74, 0x08, 0x48, 0x48, 0x0F, 0x85, 0xAB, 0x05, 0x00, 0x00, 0x80, 0xC2, 0x20, 0xC7, 0x85, 0x88, 0xFD, 0xFF, 0xFF, 0x01, 0x00, 0x00, 0x00, 0x88, 0x95, 0xEF, 0xFD, 0xFF, 0xFF, 0xE9, 0x56, 0x02, 0x00, 0x00, 0xF7, 0x85, 0xF0, 0xFD, 0xFF, 0xFF, 0x30, 0x08, 0x00, 0x00, 0x0F, 0x85, 0x9E, 0x00, 0x00, 0x00, 0x81, 0x8D, 0xF0, 0xFD, 0xFF, 0xFF, 0x00, 0x08, 0x00, 0x00, 0xE9, 0x8F, 0x00, 0x00, 0x00, 0xF7, 0x85, 0xF0, 0xFD, 0xFF, 0xFF, 0x30, 0x08, 0x00, 0x00, 0x75, 0x0A, 0x81, 0x8D, 0xF0, 0xFD, 0xFF, 0xFF, 0x00, 0x08, 0x00, 0x00, 0x8B, 0x8D, 0xE8, 0xFD, 0xFF, 0xFF, 0x83, 0xF9, 0xFF, 0x75, 0x05, 0xB9, 0xFF, 0xFF, 0xFF, 0x7F, 0x83, 0xC7, 0x04, 0xF7, 0x85, 0xF0, 0xFD, 0xFF, 0xFF, 0x10, 0x08, 0x00, 0x00, 0x89, 0xBD, 0xE4, 0xFD, 0xFF, 0xFF, 0x8B, 0x7F, 0xFC, 0x89, 0xBD, 0xE0, 0xFD, 0xFF, 0xFF, 0x0F, 0x84, 0xFE, 0x04, 0x00, 0x00, 0x85, 0xFF, 0x75, 0x0B, 0xA1, 0x04, 0xD9, 0x40, 0x00, 0x89, 0x85, 0xE0, 0xFD, 0xFF, 0xFF, 0x8B, 0x85, 0xE0, 0xFD, 0xFF, 0xFF,
				0xC7, 0x85, 0xC4, 0xFD, 0xFF, 0xFF, 0x01, 0x00, 0x00, 0x00, 0xE9, 0xCC, 0x04, 0x00, 0x00, 0x83, 0xE8, 0x58, 0x0F, 0x84, 0x22, 0x03, 0x00, 0x00, 0x48, 0x48, 0x74, 0x7F, 0x2B, 0xC1, 0x0F, 0x84, 0xB6, 0x01, 0x00, 0x00, 0x48, 0x48, 0x0F, 0x85, 0xEB, 0x04, 0x00, 0x00, 0x8B, 0xBD, 0xE4, 0xFD, 0xFF, 0xFF, 0x83, 0xC7, 0x04, 0xF7, 0x85, 0xF0, 0xFD, 0xFF, 0xFF, 0x10, 0x08, 0x00, 0x00, 0x89, 0xBD, 0xE4, 0xFD, 0xFF, 0xFF, 0x74, 0x30, 0x0F, 0xB7, 0x47, 0xFC, 0x50, 0x68, 0x00, 0x02, 0x00, 0x00, 0x8D, 0x85, 0xF4, 0xFD, 0xFF, 0xFF, 0x50, 0x8D, 0x85, 0xD8, 0xFD, 0xFF, 0xFF, 0x50, 0xE8, 0x78, 0x36, 0x00, 0x00, 0x83, 0xC4, 0x10, 0x85, 0xC0, 0x74, 0x1F, 0xC7, 0x85, 0xBC, 0xFD, 0xFF, 0xFF, 0x01, 0x00, 0x00, 0x00, 0xEB, 0x13, 0x8A, 0x47, 0xFC, 0x88, 0x85, 0xF4, 0xFD, 0xFF, 0xFF, 0xC7, 0x85, 0xD8, 0xFD, 0xFF, 0xFF, 0x01, 0x00, 0x00, 0x00, 0x8D, 0x85, 0xF4, 0xFD, 0xFF, 0xFF, 0x89, 0x85, 0xE0, 0xFD, 0xFF, 0xFF, 0xE9, 0x7C, 0x04, 0x00, 0x00, 0x8B, 0x07, 0x83, 0xC7, 0x04, 0x89, 0xBD, 0xE4, 0xFD, 0xFF, 0xFF, 0x85, 0xC0, 0x74, 0x3B, 0x8B, 0x48, 0x04, 0x85, 0xC9, 0x74, 0x34, 0xF7, 0x85, 0xF0, 0xFD, 0xFF, 0xFF, 0x00, 0x08, 0x00, 0x00, 0x0F, 0xBF, 0x00, 0x89, 0x8D, 0xE0, 0xFD, 0xFF, 0xFF, 0x74, 0x14, 0x99, 0x2B, 0xC2, 0xD1, 0xF8, 0xC7, 0x85, 0xC4, 0xFD, 0xFF, 0xFF, 0x01, 0x00, 0x00, 0x00, 0xE9, 0x37, 0x04, 0x00, 0x00, 0x21, 0xB5, 0xC4, 0xFD, 0xFF, 0xFF, 0xE9, 0x2C, 0x04, 0x00, 0x00, 0xA1, 0x00, 0xD9, 0x40, 0x00, 0x89, 0x85, 0xE0, 0xFD, 0xFF, 0xFF, 0x50, 0xE8, 0xCE, 0x27, 0x00, 0x00, 0x59, 0xE9, 0x15, 0x04, 0x00, 0x00, 0x83, 0xF8, 0x70, 0x0F, 0x8F, 0x3D, 0x02, 0x00, 0x00, 0x0F, 0x84, 0x25, 0x02, 0x00, 0x00, 0x83, 0xF8, 0x65, 0x0F, 0x8C, 0x03, 0x04, 0x00, 0x00, 0x83, 0xF8, 0x67, 0x0F, 0x8E, 0xB7, 0x00, 0x00, 0x00, 0x83, 0xF8, 0x69, 0x74, 0x7C, 0x83, 0xF8, 0x6E, 0x74, 0x2E, 0x83, 0xF8, 0x6F, 0x0F, 0x85, 0xE7, 0x03, 0x00, 0x00, 0xF6, 0x85, 0xF0, 0xFD, 0xFF, 0xFF, 0x80, 0x8B, 0xBD, 0xE4, 0xFD, 0xFF, 0xFF, 0xC7, 0x85, 0xD8, 0xFD, 0xFF, 0xFF, 0x08, 0x00, 0x00, 0x00, 0x74, 0x6C, 0x81, 0x8D, 0xF0, 0xFD, 0xFF, 0xFF, 0x00, 0x02, 0x00, 0x00, 0xEB, 0x60, 0x83, 0x85, 0xE4, 0xFD, 0xFF, 0xFF, 0x04, 0x8B, 0x85, 0xE4, 0xFD, 0xFF, 0xFF, 0x8B, 0x70, 0xFC, 0xE8, 0x07, 0x34, 0x00, 0x00, 0x85, 0xC0, 0x0F, 0x84, 0x62, 0xFA, 0xFF, 0xFF, 0xF6, 0x85, 0xF0, 0xFD, 0xFF, 0xFF, 0x20, 0x74, 0x0C, 0x66, 0x8B, 0x85, 0xDC, 0xFD, 0xFF, 0xFF, 0x66, 0x89, 0x06, 0xEB, 0x08, 0x8B, 0x85, 0xDC, 0xFD, 0xFF, 0xFF, 0x89, 0x06, 0xC7, 0x85, 0xBC, 0xFD, 0xFF, 0xFF, 0x01, 0x00, 0x00, 0x00, 0xE9, 0x3E, 0x05, 0x00, 0x00, 0x8B, 0xBD, 0xE4, 0xFD, 0xFF, 0xFF, 0x83, 0x8D, 0xF0, 0xFD, 0xFF, 0xFF, 0x40, 0xC7, 0x85, 0xD8, 0xFD, 0xFF, 0xFF, 0x0A, 0x00, 0x00, 0x00, 0x8B, 0x8D, 0xF0, 0xFD, 0xFF, 0xFF, 0xF7, 0xC1, 0x00, 0x80, 0x00, 0x00, 0x0F, 0x84, 0xE0, 0x01, 0x00, 0x00, 0x8B, 0x07, 0x8B, 0x57, 0x04, 0x83, 0xC7, 0x08, 0xE9, 0x0C, 0x02, 0x00, 0x00, 0x8B, 0xBD, 0xE4, 0xFD, 0xFF, 0xFF, 0x83, 0x8D, 0xF0, 0xFD, 0xFF, 0xFF, 0x40, 0x8D, 0x9D, 0xF4, 0xFD, 0xFF, 0xFF, 0xB8, 0x00, 0x02, 0x00, 0x00, 0x89, 0x9D, 0xE0, 0xFD, 0xFF, 0xFF, 0x89, 0x85,
				0xA0, 0xFD, 0xFF, 0xFF, 0x39, 0xB5, 0xE8, 0xFD, 0xFF, 0xFF, 0x7D, 0x0C, 0xC7, 0x85, 0xE8, 0xFD, 0xFF, 0xFF, 0x06, 0x00, 0x00, 0x00, 0xEB, 0x6A, 0x75, 0x11, 0x80, 0xFA, 0x67, 0x75, 0x63, 0xC7, 0x85, 0xE8, 0xFD, 0xFF, 0xFF, 0x01, 0x00, 0x00, 0x00, 0xEB, 0x57, 0x39, 0x85, 0xE8, 0xFD, 0xFF, 0xFF, 0x7E, 0x06, 0x89, 0x85, 0xE8, 0xFD, 0xFF, 0xFF, 0x81, 0xBD, 0xE8, 0xFD, 0xFF, 0xFF, 0xA3, 0x00, 0x00, 0x00, 0x7E, 0x3D, 0x8B, 0xB5, 0xE8, 0xFD, 0xFF, 0xFF, 0x81, 0xC6, 0x5D, 0x01, 0x00, 0x00, 0x56, 0xE8, 0x04, 0x1B, 0x00, 0x00, 0x8A, 0x95, 0xEF, 0xFD, 0xFF, 0xFF, 0x59, 0x89, 0x85, 0xB8, 0xFD, 0xFF, 0xFF, 0x85, 0xC0, 0x74, 0x10, 0x89, 0x85, 0xE0, 0xFD, 0xFF, 0xFF, 0x89, 0xB5, 0xA0, 0xFD, 0xFF, 0xFF, 0x8B, 0xD8, 0xEB, 0x0A, 0xC7, 0x85, 0xE8, 0xFD, 0xFF, 0xFF, 0xA3, 0x00, 0x00, 0x00, 0x8B, 0x07, 0x8B, 0x35, 0x88, 0xA0, 0x40, 0x00, 0x83, 0xC7, 0x08, 0x89, 0x85, 0x80, 0xFD, 0xFF, 0xFF, 0x8B, 0x47, 0xFC, 0x89, 0x85, 0x84, 0xFD, 0xFF, 0xFF, 0x8D, 0x85, 0xA4, 0xFD, 0xFF, 0xFF, 0x50, 0xFF, 0xB5, 0x88, 0xFD, 0xFF, 0xFF, 0x0F, 0xBE, 0xC2, 0xFF, 0xB5, 0xE8, 0xFD, 0xFF, 0xFF, 0x89, 0xBD, 0xE4, 0xFD, 0xFF, 0xFF, 0x50, 0xFF, 0xB5, 0xA0, 0xFD, 0xFF, 0xFF, 0x8D, 0x85, 0x80, 0xFD, 0xFF, 0xFF, 0x53, 0x50, 0xFF, 0x35, 0x78, 0xDD, 0x40, 0x00, 0xFF, 0xD6, 0xFF, 0xD0, 0x8B, 0xBD, 0xF0, 0xFD, 0xFF, 0xFF, 0x83, 0xC4, 0x1C, 0x81, 0xE7, 0x80, 0x00, 0x00, 0x00, 0x74, 0x1D, 0x83, 0xBD, 0xE8, 0xFD, 0xFF, 0xFF, 0x00, 0x75, 0x14, 0x8D, 0x85, 0xA4, 0xFD, 0xFF, 0xFF, 0x50, 0x53, 0xFF, 0x35, 0x84, 0xDD, 0x40, 0x00, 0xFF, 0xD6, 0xFF, 0xD0, 0x59, 0x59, 0x80, 0xBD, 0xEF, 0xFD, 0xFF, 0xFF, 0x67, 0x75, 0x18, 0x85, 0xFF, 0x75, 0x14, 0x8D, 0x85, 0xA4, 0xFD, 0xFF, 0xFF, 0x50, 0x53, 0xFF, 0x35, 0x80, 0xDD, 0x40, 0x00, 0xFF, 0xD6, 0xFF, 0xD0, 0x59, 0x59, 0x80, 0x3B, 0x2D, 0x75, 0x11, 0x81, 0x8D, 0xF0, 0xFD, 0xFF, 0xFF, 0x00, 0x01, 0x00, 0x00, 0x43, 0x89, 0x9D, 0xE0, 0xFD, 0xFF, 0xFF, 0x53, 0xE9, 0xC1, 0xFD, 0xFF, 0xFF, 0xC7, 0x85, 0xE8, 0xFD, 0xFF, 0xFF, 0x08, 0x00, 0x00, 0x00, 0x89, 0x8D, 0xB4, 0xFD, 0xFF, 0xFF, 0xEB, 0x2A, 0x83, 0xE8, 0x73, 0x0F, 0x84, 0x6E, 0xFC, 0xFF, 0xFF, 0x48, 0x48, 0x0F, 0x84, 0x58, 0xFE, 0xFF, 0xFF, 0x83, 0xE8, 0x03, 0x0F, 0x85, 0xBB, 0x01, 0x00, 0x00, 0x8B, 0xBD, 0xE4, 0xFD, 0xFF, 0xFF, 0xC7, 0x85, 0xB4, 0xFD, 0xFF, 0xFF, 0x27, 0x00, 0x00, 0x00, 0xF6, 0x85, 0xF0, 0xFD, 0xFF, 0xFF, 0x80, 0xC7, 0x85, 0xD8, 0xFD, 0xFF, 0xFF, 0x10, 0x00, 0x00, 0x00, 0x0F, 0x84, 0x32, 0xFE, 0xFF, 0xFF, 0x8A, 0x85, 0xB4, 0xFD, 0xFF, 0xFF, 0x04, 0x51, 0xC6, 0x85, 0xD4, 0xFD, 0xFF, 0xFF, 0x30, 0x88, 0x85, 0xD5, 0xFD, 0xFF, 0xFF, 0xC7, 0x85, 0xCC, 0xFD, 0xFF, 0xFF, 0x02, 0x00, 0x00, 0x00, 0xE9, 0x0E, 0xFE, 0xFF, 0xFF, 0xF7, 0xC1, 0x00, 0x10, 0x00, 0x00, 0x0F, 0x85, 0x14, 0xFE, 0xFF, 0xFF, 0x83, 0xC7, 0x04, 0xF6, 0xC1, 0x20, 0x74, 0x18, 0x89, 0xBD, 0xE4, 0xFD, 0xFF, 0xFF, 0xF6, 0xC1, 0x40, 0x74, 0x06, 0x0F, 0xBF, 0x47, 0xFC, 0xEB, 0x04, 0x0F, 0xB7, 0x47, 0xFC, 0x99, 0xEB, 0x13, 0x8B, 0x47, 0xFC, 0xF6, 0xC1, 0x40, 0x74, 0x03, 0x99, 0xEB, 0x02, 0x33, 0xD2, 0x89, 0xBD, 0xE4, 0xFD, 0xFF, 0xFF, 0xF6, 0xC1,
				0x40, 0x74, 0x1A, 0x85, 0xD2, 0x7F, 0x16, 0x7C, 0x04, 0x85, 0xC0, 0x73, 0x10, 0xF7, 0xD8, 0x13, 0xD6, 0xF7, 0xDA, 0x81, 0x8D, 0xF0, 0xFD, 0xFF, 0xFF, 0x00, 0x01, 0x00, 0x00, 0xF7, 0x85, 0xF0, 0xFD, 0xFF, 0xFF, 0x00, 0x90, 0x00, 0x00, 0x8B, 0xFA, 0x8B, 0xD8, 0x75, 0x02, 0x33, 0xFF, 0x39, 0xB5, 0xE8, 0xFD, 0xFF, 0xFF, 0x7D, 0x0C, 0xC7, 0x85, 0xE8, 0xFD, 0xFF, 0xFF, 0x01, 0x00, 0x00, 0x00, 0xEB, 0x1A, 0x83, 0xA5, 0xF0, 0xFD, 0xFF, 0xFF, 0xF7, 0xB8, 0x00, 0x02, 0x00, 0x00, 0x39, 0x85, 0xE8, 0xFD, 0xFF, 0xFF, 0x7E, 0x06, 0x89, 0x85, 0xE8, 0xFD, 0xFF, 0xFF, 0x8B, 0xC3, 0x0B, 0xC7, 0x75, 0x06, 0x21, 0xB5, 0xCC, 0xFD, 0xFF, 0xFF, 0x8D, 0x75, 0xF3, 0x8B, 0x85, 0xE8, 0xFD, 0xFF, 0xFF, 0xFF, 0x8D, 0xE8, 0xFD, 0xFF, 0xFF, 0x85, 0xC0, 0x7F, 0x06, 0x8B, 0xC3, 0x0B, 0xC7, 0x74, 0x2D, 0x8B, 0x85, 0xD8, 0xFD, 0xFF, 0xFF, 0x99, 0x52, 0x50, 0x57, 0x53, 0xE8, 0x8A, 0x32, 0x00, 0x00, 0x83, 0xC1, 0x30, 0x89, 0x9D, 0xA0, 0xFD, 0xFF, 0xFF, 0x8B, 0xD8, 0x8B, 0xFA, 0x83, 0xF9, 0x39, 0x7E, 0x06, 0x03, 0x8D, 0xB4, 0xFD, 0xFF, 0xFF, 0x88, 0x0E, 0x4E, 0xEB, 0xBD, 0x8D, 0x45, 0xF3, 0x2B, 0xC6, 0x46, 0xF7, 0x85, 0xF0, 0xFD, 0xFF, 0xFF, 0x00, 0x02, 0x00, 0x00, 0x89, 0x85, 0xD8, 0xFD, 0xFF, 0xFF, 0x89, 0xB5, 0xE0, 0xFD, 0xFF, 0xFF, 0x74, 0x62, 0x85, 0xC0, 0x74, 0x07, 0x8B, 0xCE, 0x80, 0x39, 0x30, 0x74, 0x57, 0xFF, 0x8D, 0xE0, 0xFD, 0xFF, 0xFF, 0x8B, 0x8D, 0xE0, 0xFD, 0xFF, 0xFF, 0xC6, 0x01, 0x30, 0x40, 0xEB, 0x3F, 0x49, 0x66, 0x39, 0x30, 0x74, 0x07, 0x83, 0xC0, 0x02, 0x85, 0xC9, 0x75, 0xF3, 0x2B, 0x85, 0xE0, 0xFD, 0xFF, 0xFF, 0xD1, 0xF8, 0xEB, 0x28, 0x85, 0xFF, 0x75, 0x0B, 0xA1, 0x00, 0xD9, 0x40, 0x00, 0x89, 0x85, 0xE0, 0xFD, 0xFF, 0xFF, 0x8B, 0x85, 0xE0, 0xFD, 0xFF, 0xFF, 0xEB, 0x07, 0x49, 0x80, 0x38, 0x00, 0x74, 0x05, 0x40, 0x85, 0xC9, 0x75, 0xF5, 0x2B, 0x85, 0xE0, 0xFD, 0xFF, 0xFF, 0x89, 0x85, 0xD8, 0xFD, 0xFF, 0xFF, 0x83, 0xBD, 0xBC, 0xFD, 0xFF, 0xFF, 0x00, 0x0F, 0x85, 0xB8, 0x01, 0x00, 0x00, 0x8B, 0x8D, 0xF0, 0xFD, 0xFF, 0xFF, 0xF6, 0xC1, 0x40, 0x74, 0x35, 0xF7, 0xC1, 0x00, 0x01, 0x00, 0x00, 0x74, 0x09, 0xC6, 0x85, 0xD4, 0xFD, 0xFF, 0xFF, 0x2D, 0xEB, 0x1A, 0xF6, 0xC1, 0x01, 0x74, 0x09, 0xC6, 0x85, 0xD4, 0xFD, 0xFF, 0xFF, 0x2B, 0xEB, 0x0C, 0xF6, 0xC1, 0x02, 0x74, 0x11, 0xC6, 0x85, 0xD4, 0xFD, 0xFF, 0xFF, 0x20, 0xC7, 0x85, 0xCC, 0xFD, 0xFF, 0xFF, 0x01, 0x00, 0x00, 0x00, 0x8B, 0x85, 0xC8, 0xFD, 0xFF, 0xFF, 0x2B, 0x85, 0xD8, 0xFD, 0xFF, 0xFF, 0x2B, 0x85, 0xCC, 0xFD, 0xFF, 0xFF, 0x89, 0x85, 0xA0, 0xFD, 0xFF, 0xFF, 0xF6, 0xC1, 0x0C, 0x75, 0x25, 0x8B, 0xF8, 0xEB, 0x1D, 0x8B, 0x8D, 0xD0, 0xFD, 0xFF, 0xFF, 0x8D, 0xB5, 0xDC, 0xFD, 0xFF, 0xFF, 0xB0, 0x20, 0x4F, 0xE8, 0x30, 0xF5, 0xFF, 0xFF, 0x83, 0xBD, 0xDC, 0xFD, 0xFF, 0xFF, 0xFF, 0x74, 0x04, 0x85, 0xFF, 0x7F, 0xDF, 0xFF, 0xB5, 0xCC, 0xFD, 0xFF, 0xFF, 0x8B, 0xBD, 0x94, 0xFD, 0xFF, 0xFF, 0x8B, 0x9D, 0xD0, 0xFD, 0xFF, 0xFF, 0x8D, 0x85, 0xD4, 0xFD, 0xFF, 0xFF, 0x50, 0x8D, 0x85, 0xDC, 0xFD, 0xFF, 0xFF, 0xE8, 0x32, 0xF5, 0xFF, 0xFF, 0xF6, 0x85, 0xF0, 0xFD, 0xFF, 0xFF, 0x08, 0x59, 0x59, 0x74, 0x2E, 0xF6, 0x85, 0xF0, 0xFD, 0xFF, 0xFF, 0x04,
				0x75, 0x25, 0x8B, 0xBD, 0xA0, 0xFD, 0xFF, 0xFF, 0xEB, 0x19, 0x8D, 0xB5, 0xDC, 0xFD, 0xFF, 0xFF, 0x8B, 0xCB, 0xB0, 0x30, 0x4F, 0xE8, 0xD3, 0xF4, 0xFF, 0xFF, 0x83, 0xBD, 0xDC, 0xFD, 0xFF, 0xFF, 0xFF, 0x74, 0x04, 0x85, 0xFF, 0x7F, 0xE3, 0x83, 0xBD, 0xC4, 0xFD, 0xFF, 0xFF, 0x00, 0x8B, 0x85, 0xD8, 0xFD, 0xFF, 0xFF, 0x74, 0x75, 0x85, 0xC0, 0x7E, 0x71, 0x8B, 0xB5, 0xE0, 0xFD, 0xFF, 0xFF, 0x89, 0x85, 0x98, 0xFD, 0xFF, 0xFF, 0x0F, 0xB7, 0x06, 0xFF, 0x8D, 0x98, 0xFD, 0xFF, 0xFF, 0x50, 0x6A, 0x06, 0x8D, 0x45, 0xF4, 0x50, 0x8D, 0x85, 0x90, 0xFD, 0xFF, 0xFF, 0x50, 0x83, 0xC6, 0x02, 0xE8, 0x9B, 0x30, 0x00, 0x00, 0x83, 0xC4, 0x10, 0x85, 0xC0, 0x75, 0x36, 0x39, 0x85, 0x90, 0xFD, 0xFF, 0xFF, 0x74, 0x2E, 0xFF, 0xB5, 0x90, 0xFD, 0xFF, 0xFF, 0x8B, 0xBD, 0x94, 0xFD, 0xFF, 0xFF, 0x8B, 0x9D, 0xD0, 0xFD, 0xFF, 0xFF, 0x8D, 0x45, 0xF4, 0x50, 0x8D, 0x85, 0xDC, 0xFD, 0xFF, 0xFF, 0xE8, 0x8B, 0xF4, 0xFF, 0xFF, 0x83, 0xBD, 0x98, 0xFD, 0xFF, 0xFF, 0x00, 0x59, 0x59, 0x75, 0xA6, 0xEB, 0x23, 0x83, 0x8D, 0xDC, 0xFD, 0xFF, 0xFF, 0xFF, 0xEB, 0x1A, 0x8B, 0xBD, 0x94, 0xFD, 0xFF, 0xFF, 0x50, 0xFF, 0xB5, 0xE0, 0xFD, 0xFF, 0xFF, 0x8D, 0x85, 0xDC, 0xFD, 0xFF, 0xFF, 0xE8, 0x5D, 0xF4, 0xFF, 0xFF, 0x59, 0x59, 0x83, 0xBD, 0xDC, 0xFD, 0xFF, 0xFF, 0x00, 0x7C, 0x32, 0xF6, 0x85, 0xF0, 0xFD, 0xFF, 0xFF, 0x04, 0x74, 0x29, 0x8B, 0xBD, 0xA0, 0xFD, 0xFF, 0xFF, 0xEB, 0x1D, 0x8B, 0x8D, 0xD0, 0xFD, 0xFF, 0xFF, 0x8D, 0xB5, 0xDC, 0xFD, 0xFF, 0xFF, 0xB0, 0x20, 0x4F, 0xE8, 0xFA, 0xF3, 0xFF, 0xFF, 0x83, 0xBD, 0xDC, 0xFD, 0xFF, 0xFF, 0xFF, 0x74, 0x04, 0x85, 0xFF, 0x7F, 0xDF, 0x83, 0xBD, 0xB8, 0xFD, 0xFF, 0xFF, 0x00, 0x74, 0x13, 0xFF, 0xB5, 0xB8, 0xFD, 0xFF, 0xFF, 0xE8, 0xCA, 0xDC, 0xFF, 0xFF, 0x83, 0xA5, 0xB8, 0xFD, 0xFF, 0xFF, 0x00, 0x59, 0x8B, 0x9D, 0xC0, 0xFD, 0xFF, 0xFF, 0x8A, 0x03, 0x88, 0x85, 0xEF, 0xFD, 0xFF, 0xFF, 0x84, 0xC0, 0x74, 0x13, 0x8B, 0x8D, 0x8C, 0xFD, 0xFF, 0xFF, 0x8B, 0xBD, 0xE4, 0xFD, 0xFF, 0xFF, 0x8A, 0xD0, 0xE9, 0x72, 0xF5, 0xFF, 0xFF, 0x80, 0xBD, 0xB0, 0xFD, 0xFF, 0xFF, 0x00, 0x74, 0x0A, 0x8B, 0x85, 0xAC, 0xFD, 0xFF, 0xFF, 0x83, 0x60, 0x70, 0xFD, 0x8B, 0x85, 0xDC, 0xFD, 0xFF, 0xFF, 0x8B, 0x4D, 0xFC, 0x5F, 0x5E, 0x33, 0xCD, 0x5B, 0xE8, 0xC0, 0xD8, 0xFF, 0xFF, 0xC9, 0xC3, 0x90, 0x9C, 0x3F, 0x40, 0x00, 0x9B, 0x3D, 0x40, 0x00, 0xCB, 0x3D, 0x40, 0x00, 0x29, 0x3E, 0x40, 0x00, 0x75, 0x3E, 0x40, 0x00, 0x80, 0x3E, 0x40, 0x00, 0xC6, 0x3E, 0x40, 0x00, 0xF6, 0x3F, 0x40, 0x00, 0x6A, 0x00, 0x68, 0x00, 0x10, 0x00, 0x00, 0x6A, 0x00, 0xFF, 0x15, 0xA0, 0xA0, 0x40, 0x00, 0x33, 0xC9, 0x85, 0xC0, 0x0F, 0x95, 0xC1, 0xA3, 0x28, 0xE1, 0x40, 0x00, 0x8B, 0xC1, 0xC3, 0x8B, 0xFF, 0x55, 0x8B, 0xEC, 0x68, 0x14, 0xA6, 0x40, 0x00, 0xFF, 0x15, 0x90, 0xA0, 0x40, 0x00, 0x85, 0xC0, 0x74, 0x15, 0x68, 0x04, 0xA6, 0x40, 0x00, 0x50, 0xFF, 0x15, 0x9C, 0xA0, 0x40, 0x00, 0x85, 0xC0, 0x74, 0x05, 0xFF, 0x75, 0x08, 0xFF, 0xD0, 0x5D, 0xC3, 0x8B, 0xFF, 0x55, 0x8B, 0xEC, 0xFF, 0x75, 0x08, 0xE8, 0xC8, 0xFF, 0xFF, 0xFF, 0x59, 0xFF, 0x75, 0x08, 0xFF, 0x15, 0x2C, 0xA0, 0x40, 0x00, 0xCC, 0x6A, 0x08, 0xE8, 0x4E, 0x15, 0x00, 0x00, 0x59, 0xC3,
				0x6A, 0x08, 0xE8, 0x6C, 0x14, 0x00, 0x00, 0x59, 0xC3, 0x8B, 0xFF, 0x56, 0xE8, 0x6A, 0xE9, 0xFF, 0xFF, 0x8B, 0xF0, 0x56, 0xE8, 0x94, 0x04, 0x00, 0x00, 0x56, 0xE8, 0xE5, 0xEE, 0xFF, 0xFF, 0x56, 0xE8, 0x02, 0x32, 0x00, 0x00, 0x56, 0xE8, 0xED, 0x31, 0x00, 0x00, 0x56, 0xE8, 0xE2, 0x2F, 0x00, 0x00, 0x56, 0xE8, 0xCB, 0x2F, 0x00, 0x00, 0x83, 0xC4, 0x18, 0x5E, 0xC3, 0x8B, 0xFF, 0x55, 0x8B, 0xEC, 0x56, 0x8B, 0x75, 0x08, 0x33, 0xC0, 0xEB, 0x0F, 0x85, 0xC0, 0x75, 0x10, 0x8B, 0x0E, 0x85, 0xC9, 0x74, 0x02, 0xFF, 0xD1, 0x83, 0xC6, 0x04, 0x3B, 0x75, 0x0C, 0x72, 0xEC, 0x5E, 0x5D, 0xC3, 0x8B, 0xFF, 0x55, 0x8B, 0xEC, 0x83, 0x3D, 0x90, 0xFB, 0x40, 0x00, 0x00, 0x74, 0x19, 0x68, 0x90, 0xFB, 0x40, 0x00, 0xE8, 0x8C, 0x33, 0x00, 0x00, 0x59, 0x85, 0xC0, 0x74, 0x0A, 0xFF, 0x75, 0x08, 0xFF, 0x15, 0x90, 0xFB, 0x40, 0x00, 0x59, 0xE8, 0xF2, 0x2C, 0x00, 0x00, 0x68, 0x54, 0xA1, 0x40, 0x00, 0x68, 0x3C, 0xA1, 0x40, 0x00, 0xE8, 0xA1, 0xFF, 0xFF, 0xFF, 0x59, 0x59, 0x85, 0xC0, 0x75, 0x54, 0x56, 0x57, 0x68, 0x9F, 0x55, 0x40, 0x00, 0xE8, 0xAC, 0x32, 0x00, 0x00, 0xB8, 0x34, 0xA1, 0x40, 0x00, 0xBE, 0x38, 0xA1, 0x40, 0x00, 0x59, 0x8B, 0xF8, 0x3B, 0xC6, 0x73, 0x0F, 0x8B, 0x07, 0x85, 0xC0, 0x74, 0x02, 0xFF, 0xD0, 0x83, 0xC7, 0x04, 0x3B, 0xFE, 0x72, 0xF1, 0x83, 0x3D, 0x94, 0xFB, 0x40, 0x00, 0x00, 0x5F, 0x5E, 0x74, 0x1B, 0x68, 0x94, 0xFB, 0x40, 0x00, 0xE8, 0x22, 0x33, 0x00, 0x00, 0x59, 0x85, 0xC0, 0x74, 0x0C, 0x6A, 0x00, 0x6A, 0x02, 0x6A, 0x00, 0xFF, 0x15, 0x94, 0xFB, 0x40, 0x00, 0x33, 0xC0, 0x5D, 0xC3, 0x6A, 0x20, 0x68, 0xB0, 0xC1, 0x40, 0x00, 0xE8, 0x41, 0x0C, 0x00, 0x00, 0x6A, 0x08, 0xE8, 0x42, 0x14, 0x00, 0x00, 0x59, 0x83, 0x65, 0xFC, 0x00, 0x33, 0xC0, 0x40, 0x39, 0x05, 0x5C, 0xE1, 0x40, 0x00, 0x0F, 0x84, 0xD8, 0x00, 0x00, 0x00, 0xA3, 0x58, 0xE1, 0x40, 0x00, 0x8A, 0x45, 0x10, 0xA2, 0x54, 0xE1, 0x40, 0x00, 0x83, 0x7D, 0x0C, 0x00, 0x0F, 0x85, 0xA0, 0x00, 0x00, 0x00, 0xFF, 0x35, 0x88, 0xFB, 0x40, 0x00, 0x8B, 0x35, 0x88, 0xA0, 0x40, 0x00, 0xFF, 0xD6, 0x8B, 0xD8, 0x89, 0x5D, 0xD0, 0x85, 0xDB, 0x74, 0x68, 0xFF, 0x35, 0x84, 0xFB, 0x40, 0x00, 0xFF, 0xD6, 0x8B, 0xF8, 0x89, 0x7D, 0xD4, 0x89, 0x5D, 0xDC, 0x89, 0x7D, 0xD8, 0x83, 0xEF, 0x04, 0x89, 0x7D, 0xD4, 0x3B, 0xFB, 0x72, 0x4B, 0xE8, 0x0D, 0xE8, 0xFF, 0xFF, 0x39, 0x07, 0x74, 0xED, 0x3B, 0xFB, 0x72, 0x3E, 0xFF, 0x37, 0xFF, 0xD6, 0x8B, 0xD8, 0xE8, 0xFA, 0xE7, 0xFF, 0xFF, 0x89, 0x07, 0xFF, 0xD3, 0xFF, 0x35, 0x88, 0xFB, 0x40, 0x00, 0xFF, 0xD6, 0x8B, 0xD8, 0xFF, 0x35, 0x84, 0xFB, 0x40, 0x00, 0xFF, 0xD6, 0x39, 0x5D, 0xDC, 0x75, 0x05, 0x39, 0x45, 0xD8, 0x74, 0x0E, 0x89, 0x5D, 0xDC, 0x89, 0x5D, 0xD0, 0x89, 0x45, 0xD8, 0x8B, 0xF8, 0x89, 0x7D, 0xD4, 0x8B, 0x5D, 0xD0, 0xEB, 0xAB, 0xC7, 0x45, 0xE4, 0x58, 0xA1, 0x40, 0x00, 0x81, 0x7D, 0xE4, 0x64, 0xA1, 0x40, 0x00, 0x73, 0x11, 0x8B, 0x45, 0xE4, 0x8B, 0x00, 0x85, 0xC0, 0x74, 0x02, 0xFF, 0xD0, 0x83, 0x45, 0xE4, 0x04, 0xEB, 0xE6, 0xC7, 0x45, 0xE0, 0x68, 0xA1, 0x40, 0x00, 0x81, 0x7D, 0xE0, 0x6C, 0xA1, 0x40, 0x00, 0x73, 0x11, 0x8B, 0x45, 0xE0, 0x8B, 0x00, 0x85, 0xC0, 0x74, 0x02, 0xFF, 0xD0, 0x83, 0x45, 0xE0, 0x04,
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
