ninomegadriver/BlueJamma/(commit log)

2024-02-16 first push
    [BlueJamma-Current_BOM.csv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]
2024-03-12 added a firmware with the order of players swapped
    [Blue_Jamma_as_Xinput.ino]
2024-03-19 fixed 3xPunch and 3xKick bug
    [Blue_Jamma_as_Xinput.ino]
2025-03-25 "3 Buttons Bug" fixed by sending the USB report all at once
